essensys-hub/essensys-test-banc-SC944D/etude/cables-v1.docx

Câbles tout fait :

Videk 1530 Farnell 1525883 (Sub-D HP (helf pitch) 50 vers Sub-D HP 50)

Videk 1557 Farnell 1525919 (idem 1530 mais en 68 pts)

MEILHAUS (http://fr.farnell.com/meilhaus) AK-D78/1 Farnell 9568352 (SUB-D normal 78 pts mâle/femelle).

Trouver de la chaussette à toron.
