essensys-hub/essensys-test-banc-SC944D/etude/mesures-analogiques-annexe-spec-v4.pdf

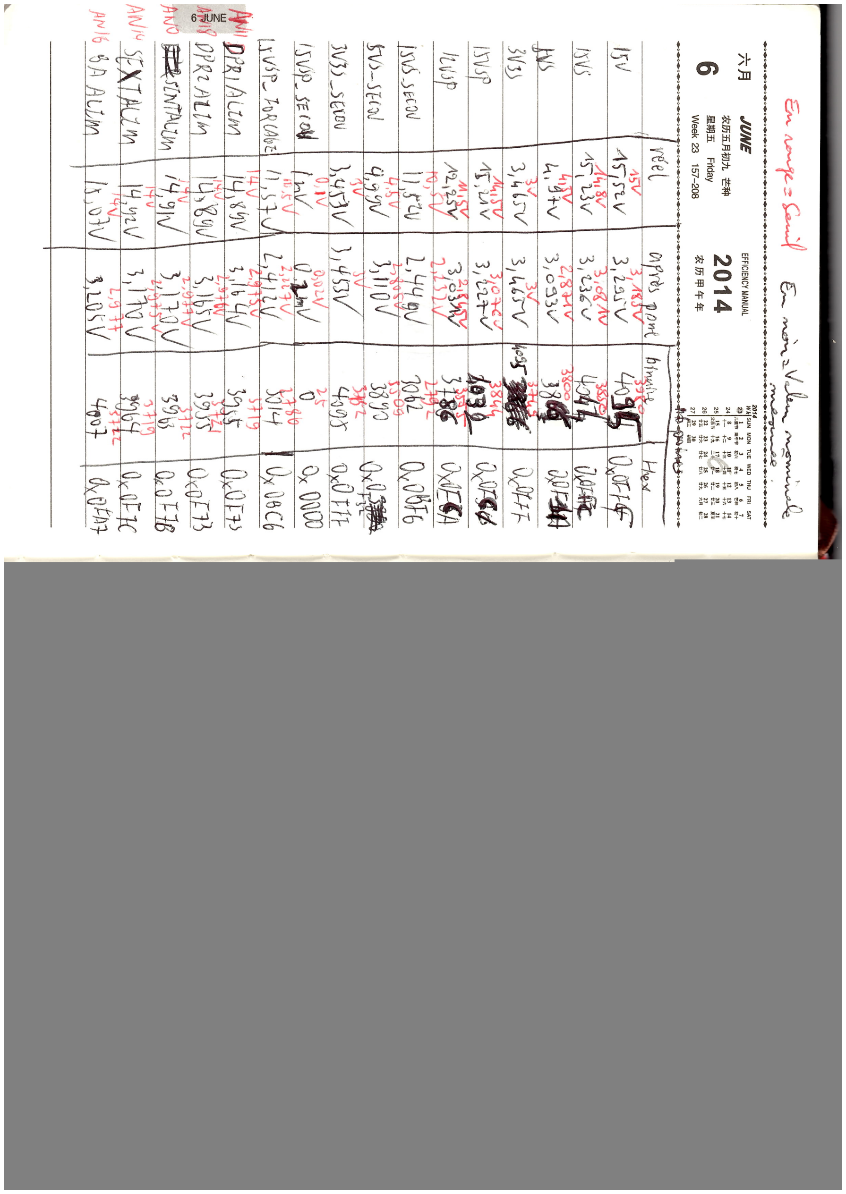
[picture p5: page 1]
