essensys-hub/essensys-test-banc-SC944D/etude/croquis-alimentations-banc.pdf

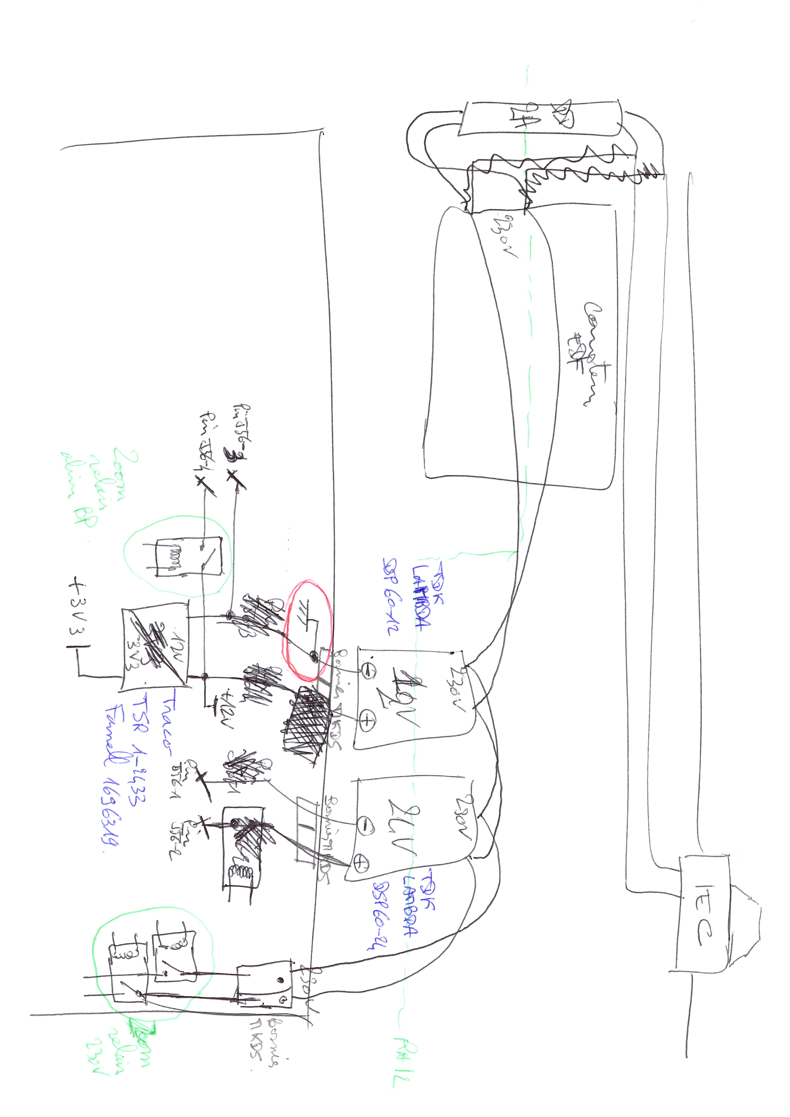
[picture p6: page 1]
