essensys-hub/essensys-test-banc-SC944D/etude/croquis-implantation-mecanique.pdf

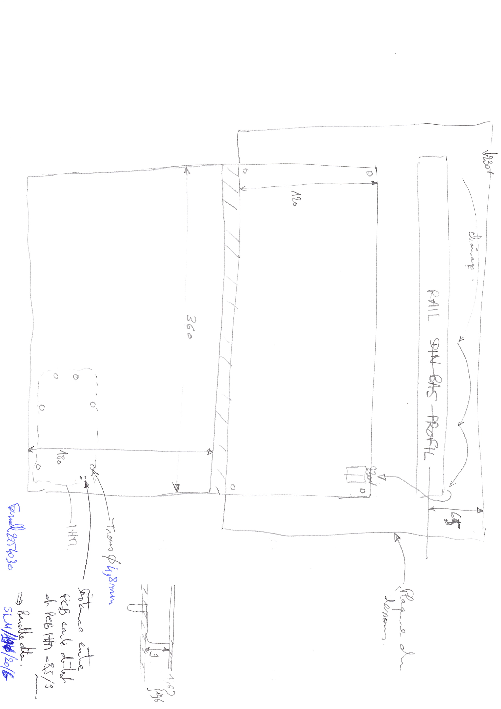
[picture p7: page 1]
