essensys-hub/essensys-test-banc-SC944D/etude/croquis-relais-230v.pdf

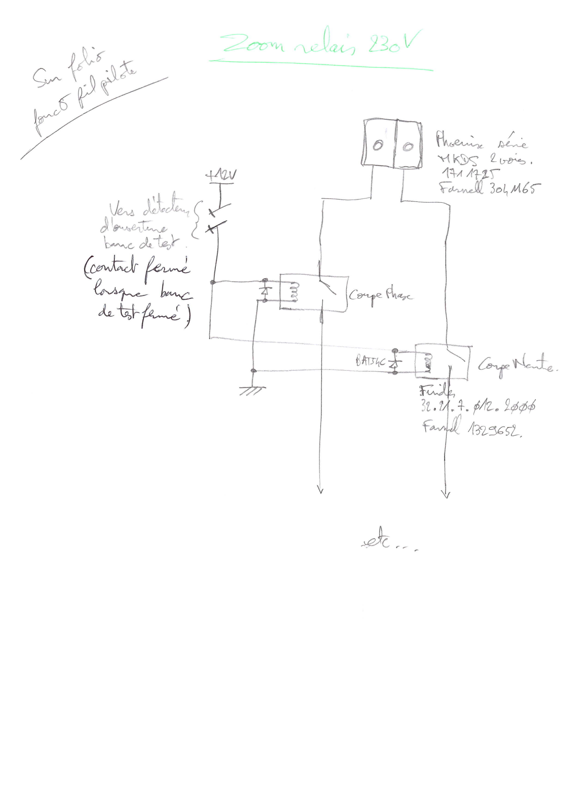
[picture p8: page 1]
