essensys-hub/essensys-test-banc-SC944D/etude/croquis-relais-alim-bp.pdf

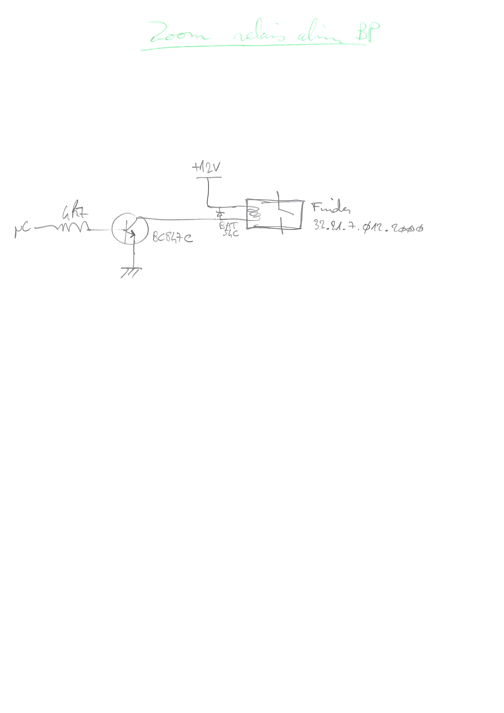
[picture p9: page 1]
