essensys-hub/essensys-test-banc-SC944D/etude/scan-ajout-masses.pdf

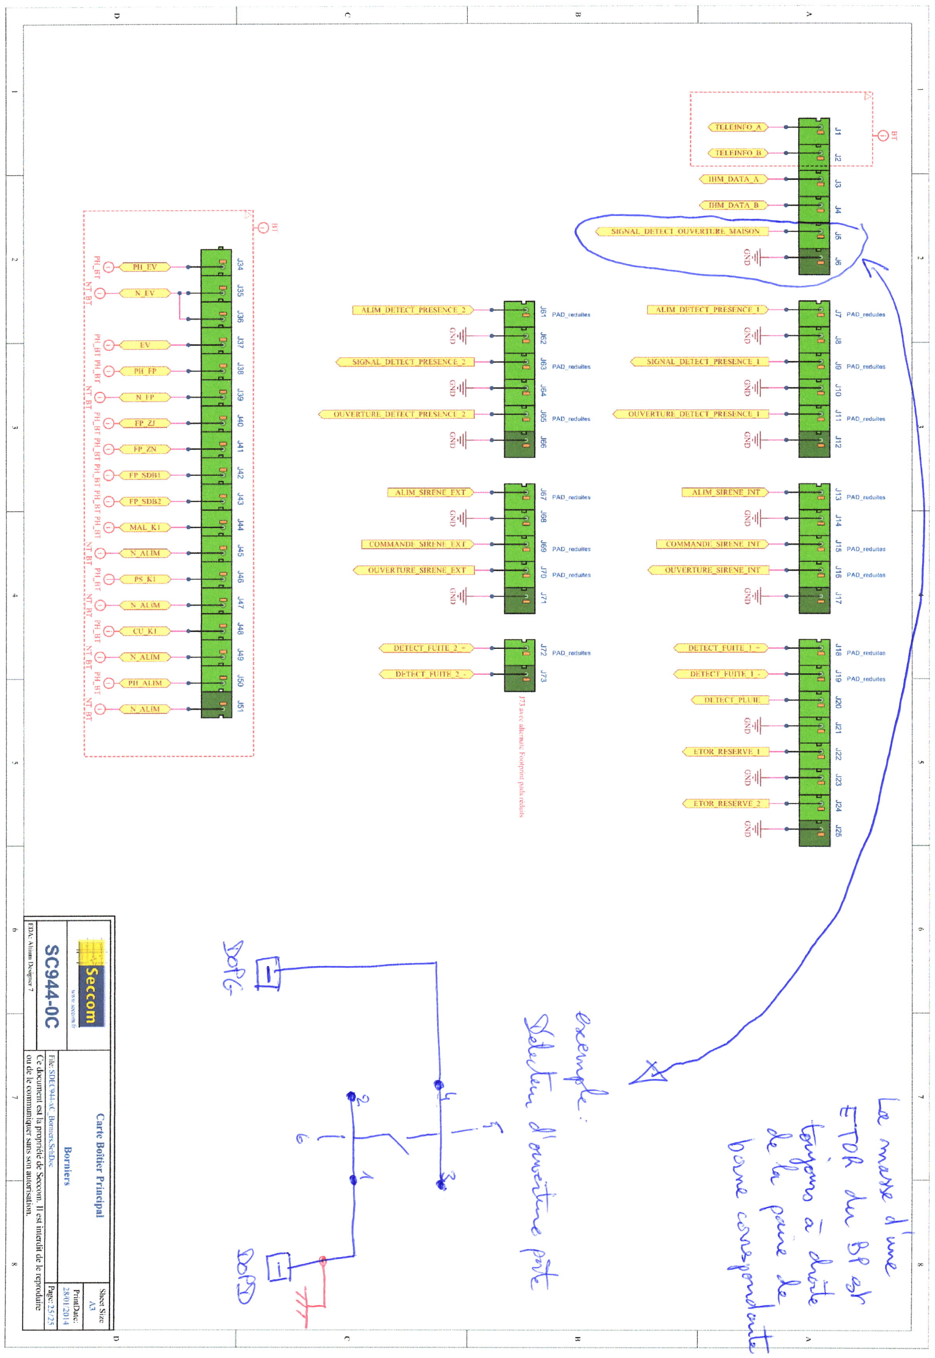
[picture p10: page 1]
