essensys-hub/essensys-test-banc-SC944D/etude/scan-connecteur-prog-dsp.pdf

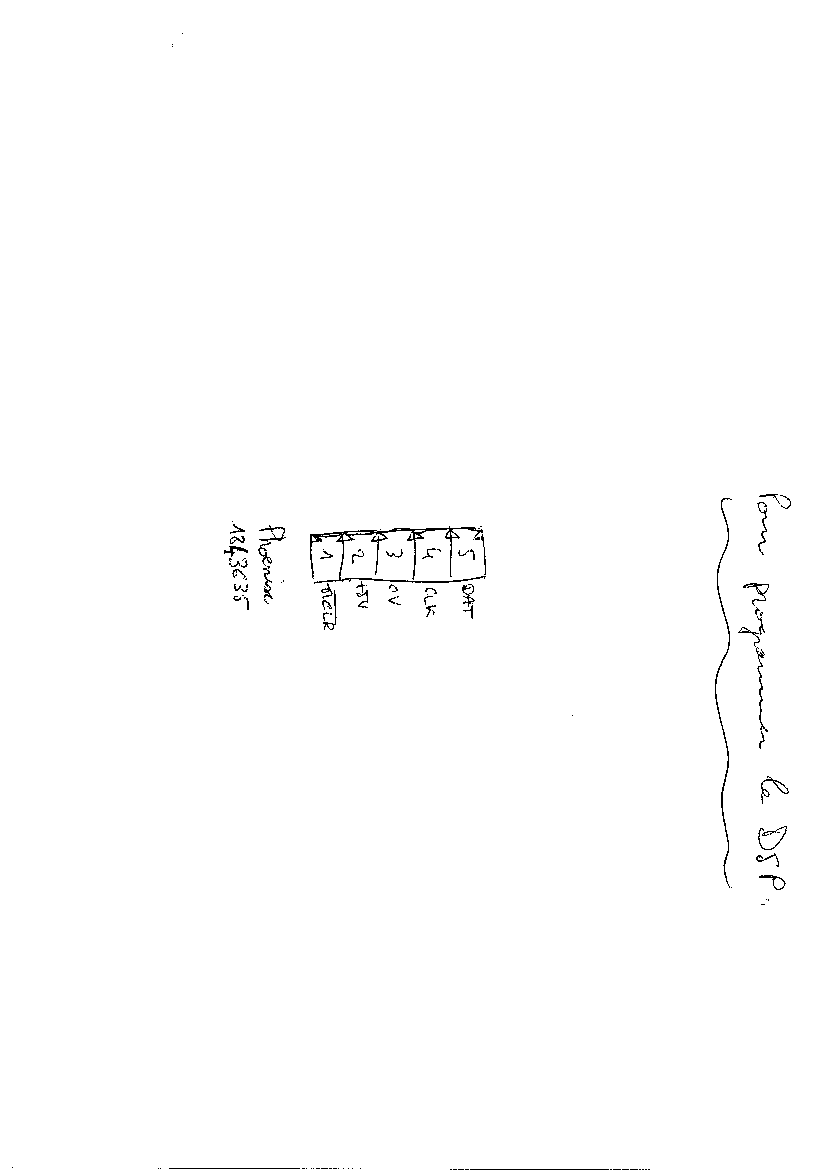
[picture p11: page 1]
