essensys-hub/essensys-test-banc-SC944D/docs/images/lit-de-clous.jpg

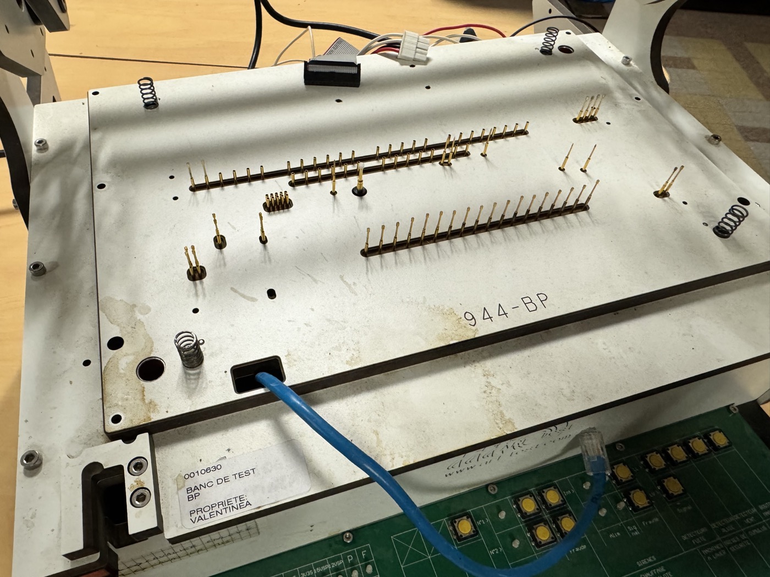
docs/images/lit-de-clous.jpg
