essensys-hub/essensys-test-banc-SC944D/photos/2016-10-08/20161008_151500.jpg

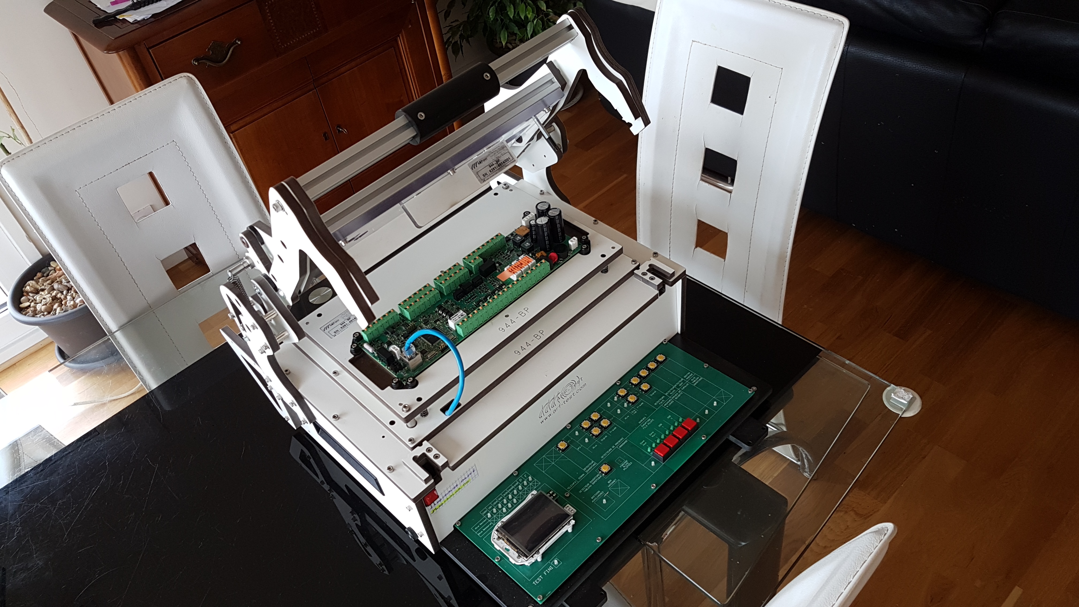
photos/2016-10-08/20161008_151500.jpg
