essensys-hub/essensys-test-banc-SC944D/photos/2026-11-09/IMG_5847.jpg

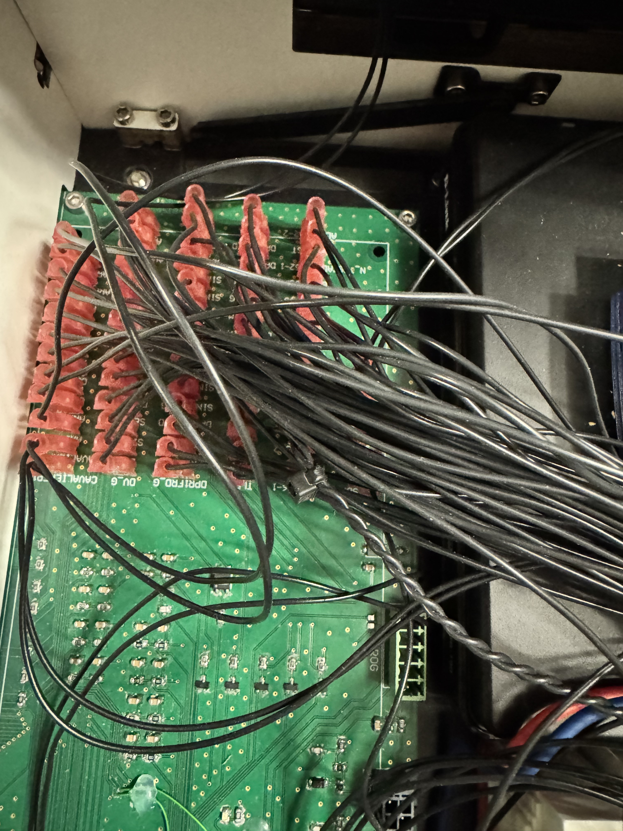
photos/2026-11-09/IMG_5847.jpg
