essensys-hub/essensys-test-banc-SC944D/photos/2026-11-09/IMG_5849.jpg

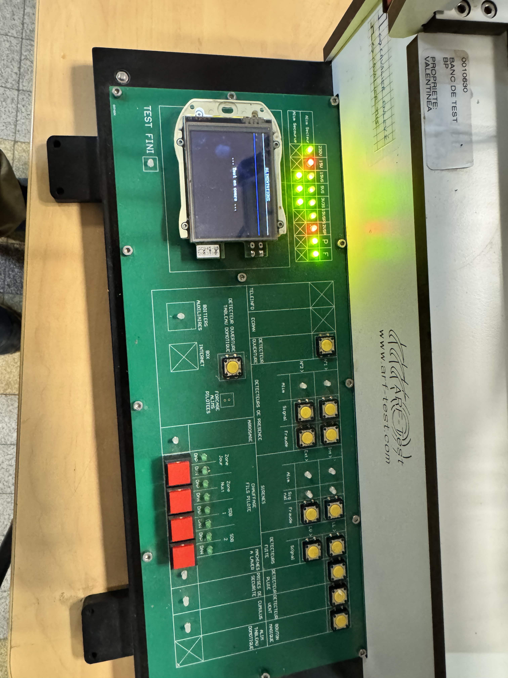
photos/2026-11-09/IMG_5849.jpg
