essensys-hub/essensys-test-banc-SC944D/carte-interface-SI841A/face-avant/archives/ci-v1_2000-Preserve-Appearance.dxf

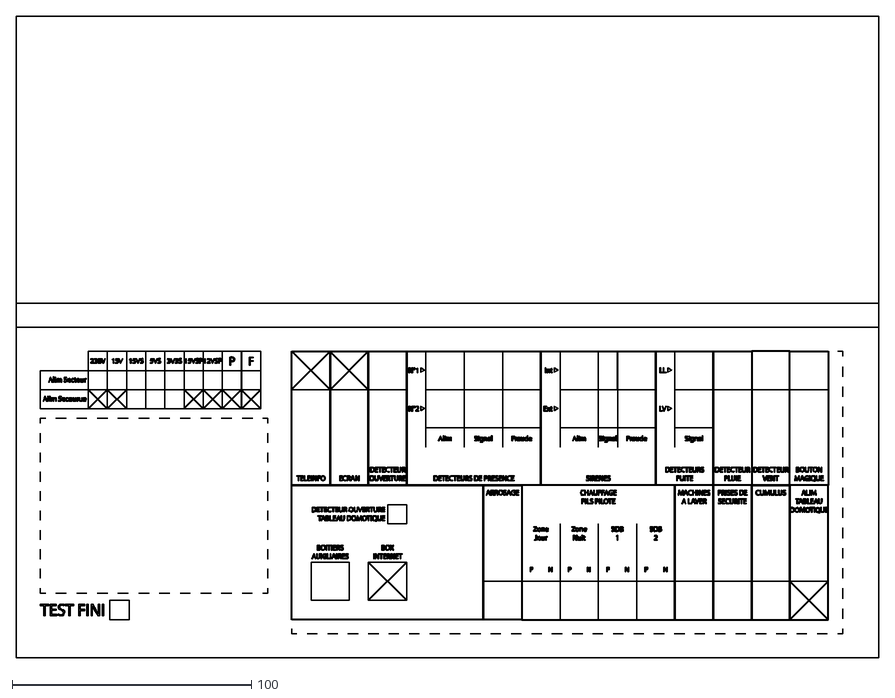
[picture p24: CAD file, 2026-11-11, an earlier design]
carte-interface-SI841A/face-avant/archives/ci-v1_2000-Preserve-Appearance.dxf
360.0 x 268.0
