essensys-hub/essensys-test-banc-SC944D/carte-interface-SI841A/face-avant/archives/ci-v4_2000-8-PNG-PA-APFA-OT.dxf

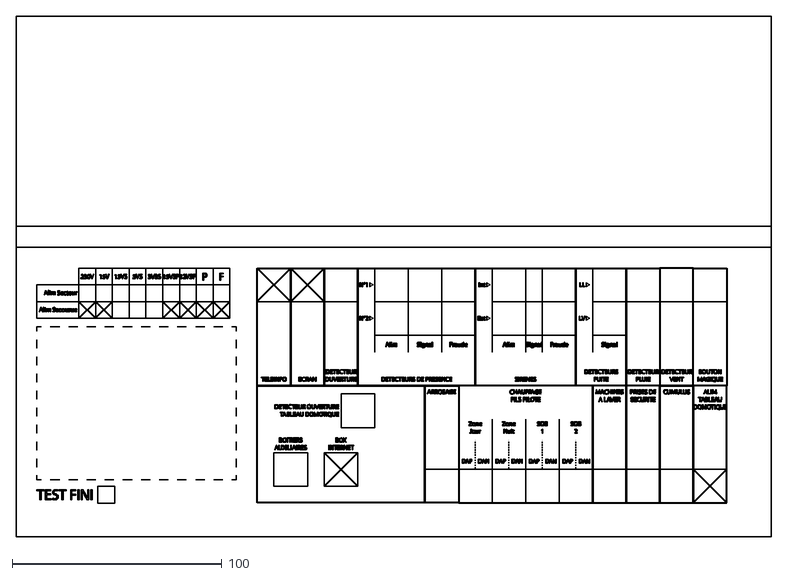
[picture p30: CAD file, 2026-11-11, an earlier design]
carte-interface-SI841A/face-avant/archives/ci-v4_2000-8-PNG-PA-APFA-OT.dxf
360.0 x 248.0
