essensys-hub/essensys-test-banc-SC944D/(list of files, cad)

Other CAD files:
carte-interface-SI841A/face-avant/archives/ci-v1_2000-Maximum-Editability.dwg
carte-interface-SI841A/face-avant/archives/ci-v1_R14-Preserve-Appearance.dwg
carte-interface-SI841A/face-avant/archives/ci-v1_R13-Preserve-Appearance.dwg
carte-interface-SI841A/face-avant/archives/ci-v1_2000-Preserve-Appearance.dwg
carte-interface-SI841A/face-avant/archives/ci-v2_2000-Preserve-Appearance.dwg
