essensys-hub/essensys-test-banc-SC944D/mecanique-arf-test-6281/_Index.html

Logo ARF-Test

Folders
ASM's Affaire | ASM's Commun | BOM | Include

Anchor

<Root>

ASM's Affaire

ASM's Commun

BOM

Include

File Listing
Folder listing : <Root>
File | Size | File | Size | File | Size | File | Size
Listing des Dossiers: H:\0 - Projets\En cours\Valentinea\Dossiers Client\6281 - ARF-PLCe 320 - SC944 | 9 Ko | Image Interface.jpg | 78 Ko | Photo interface.jpg | 205 Ko
Folder listing : ASM's Affaire
File | Size | File | Size | File | Size | File | Size
6281_005 (ARF-PLC 320 - SC944).pdf | 643 Ko | 6281_068 (Base Plate SC944).pdf | 236 Ko | 6281_092 (Top SC944).pdf | 99 Ko | 6281_111 (Right Panel - V2).pdf | 115 Ko
6281_035 (Rear Panel SC94x).pdf | 38 Ko | 6281_084 (Pusher plate SC944).pdf | 119 Ko | 6281_102 (Presse PCB).pdf | 51 Ko | 6281_117 (Left Panel - V2).pdf | 113 Ko
6281_052 (Std Presser - 320 - V2).pdf | 280 Ko | 6281_090 (Appli SC944).pdf | 104 Ko | 6281_104 (Presse Basse PCB).pdf | 47 Ko | 6281_158 (Bottom Plate (320) SC944).pdf | 90 Ko
6281_062 (Box ARF-PLC-03-V2).pdf | 491 Ko | 6281_091 (Bottom SC944).pdf | 187 Ko
Folder listing : ASM's Commun
File | Size | File | Size | File | Size | File | Size
6278_058 (Std Presser - 320 V2).pdf | 461 Ko | 6278_125 (Locating).pdf | 47 Ko | 8005_016 (Switch PLC_V2).pdf | 74 Ko | 8005_083 (Vis moletee).pdf | 83 Ko
Folder listing : BOM
File | Size | File | Size | File | Size | File | Size
6281_005 (Full).txt | 49 Ko | 6281_005 (Recap).txt | 12 Ko
Folder listing : Include
File | Size | File | Size | File | Size | File | Size
LOGO-ARF-Test.jpg | 18 Ko
