essensys-hub/essensys-test-banc-SC944D/points-de-test-SC944/si944c-pt-noms-v1.pdf

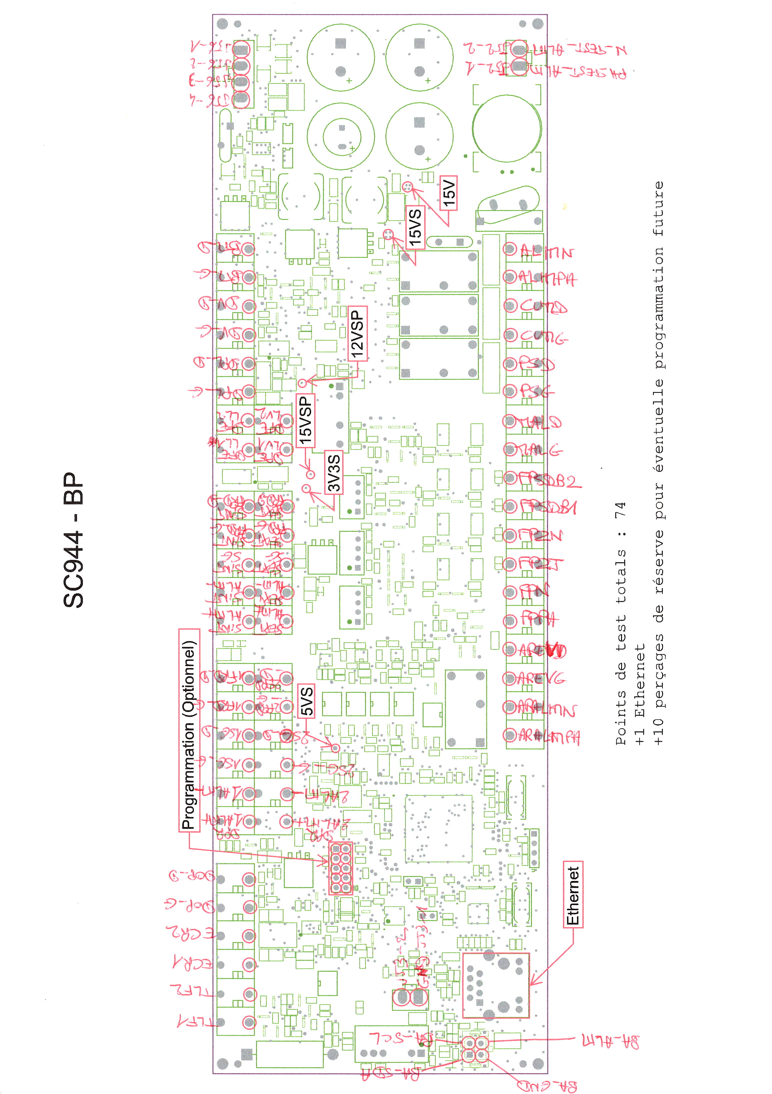
[picture p33: page 1]
