essensys-hub/essensys-test-banc-SC944D/etude/calculs-test-signal-sirenes-v1.xlsx

 | Rs | R (Ohm) | U (V) | I (mA)
SINT | 4700 | 4700 | 7.5 | 1.595744681
SEXT | 10000 |  | 4.795918367 | 1.020408163
