essensys-hub/essensys-test-banc-SC944D/etude/scan-tableau-test-alims.jpeg

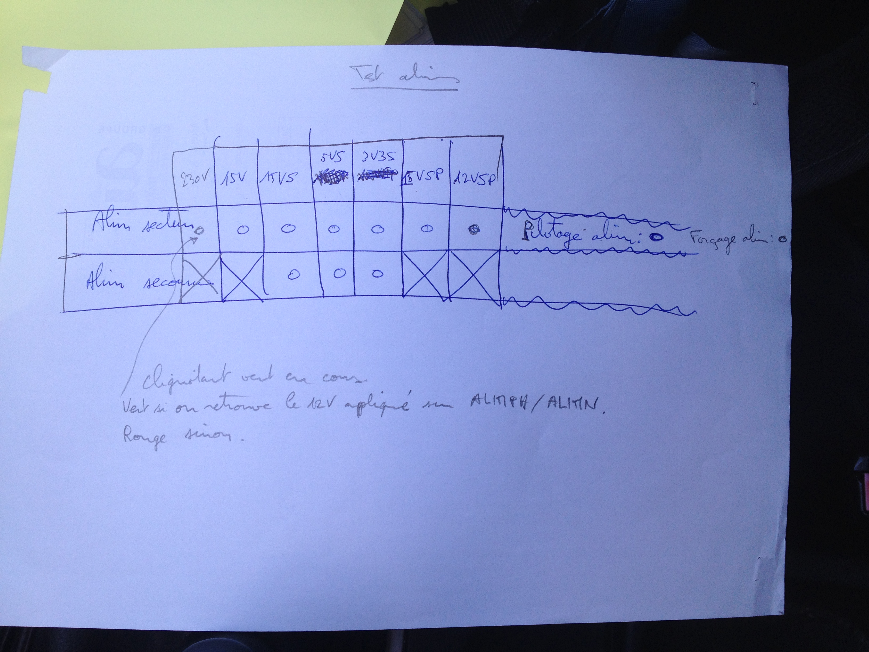
etude/scan-tableau-test-alims.jpeg
