essensys-hub/essensys-test-banc-SC944D/mecanique-arf-test-6281/Image Interface.jpg

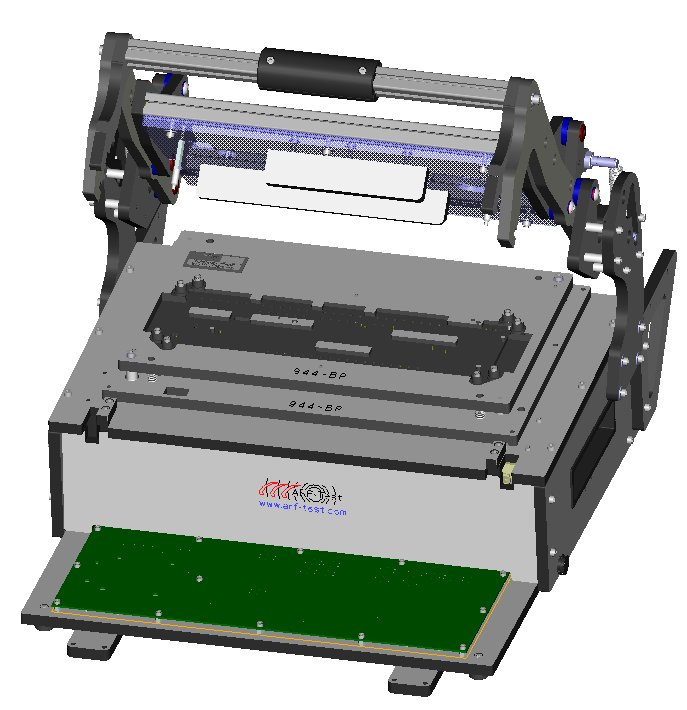
mecanique-arf-test-6281/Image Interface.jpg
