essensys-hub/essensys-test-banc-SC944D/mecanique-arf-test-6281/Photo interface.jpg

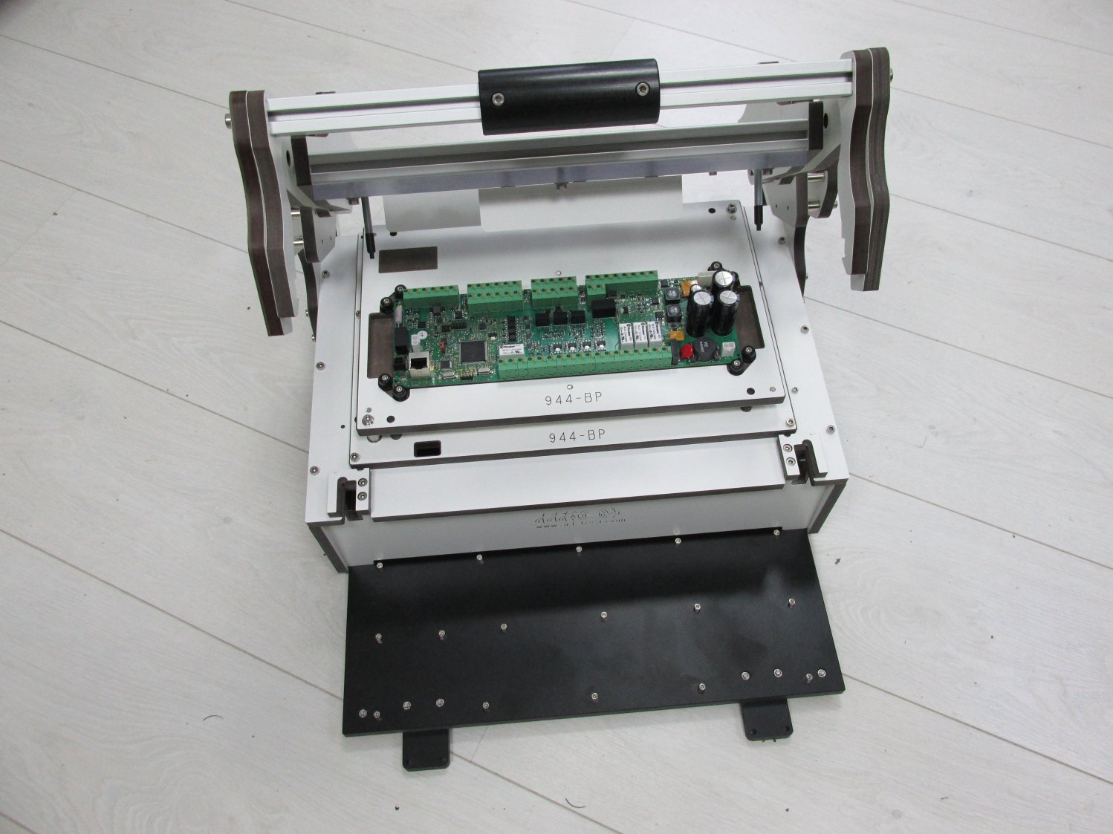
mecanique-arf-test-6281/Photo interface.jpg
