essensys-hub/essensys-test-banc-SC944D/carte-interface-SI841A/schema/schema-banc-bp-v4.pdf

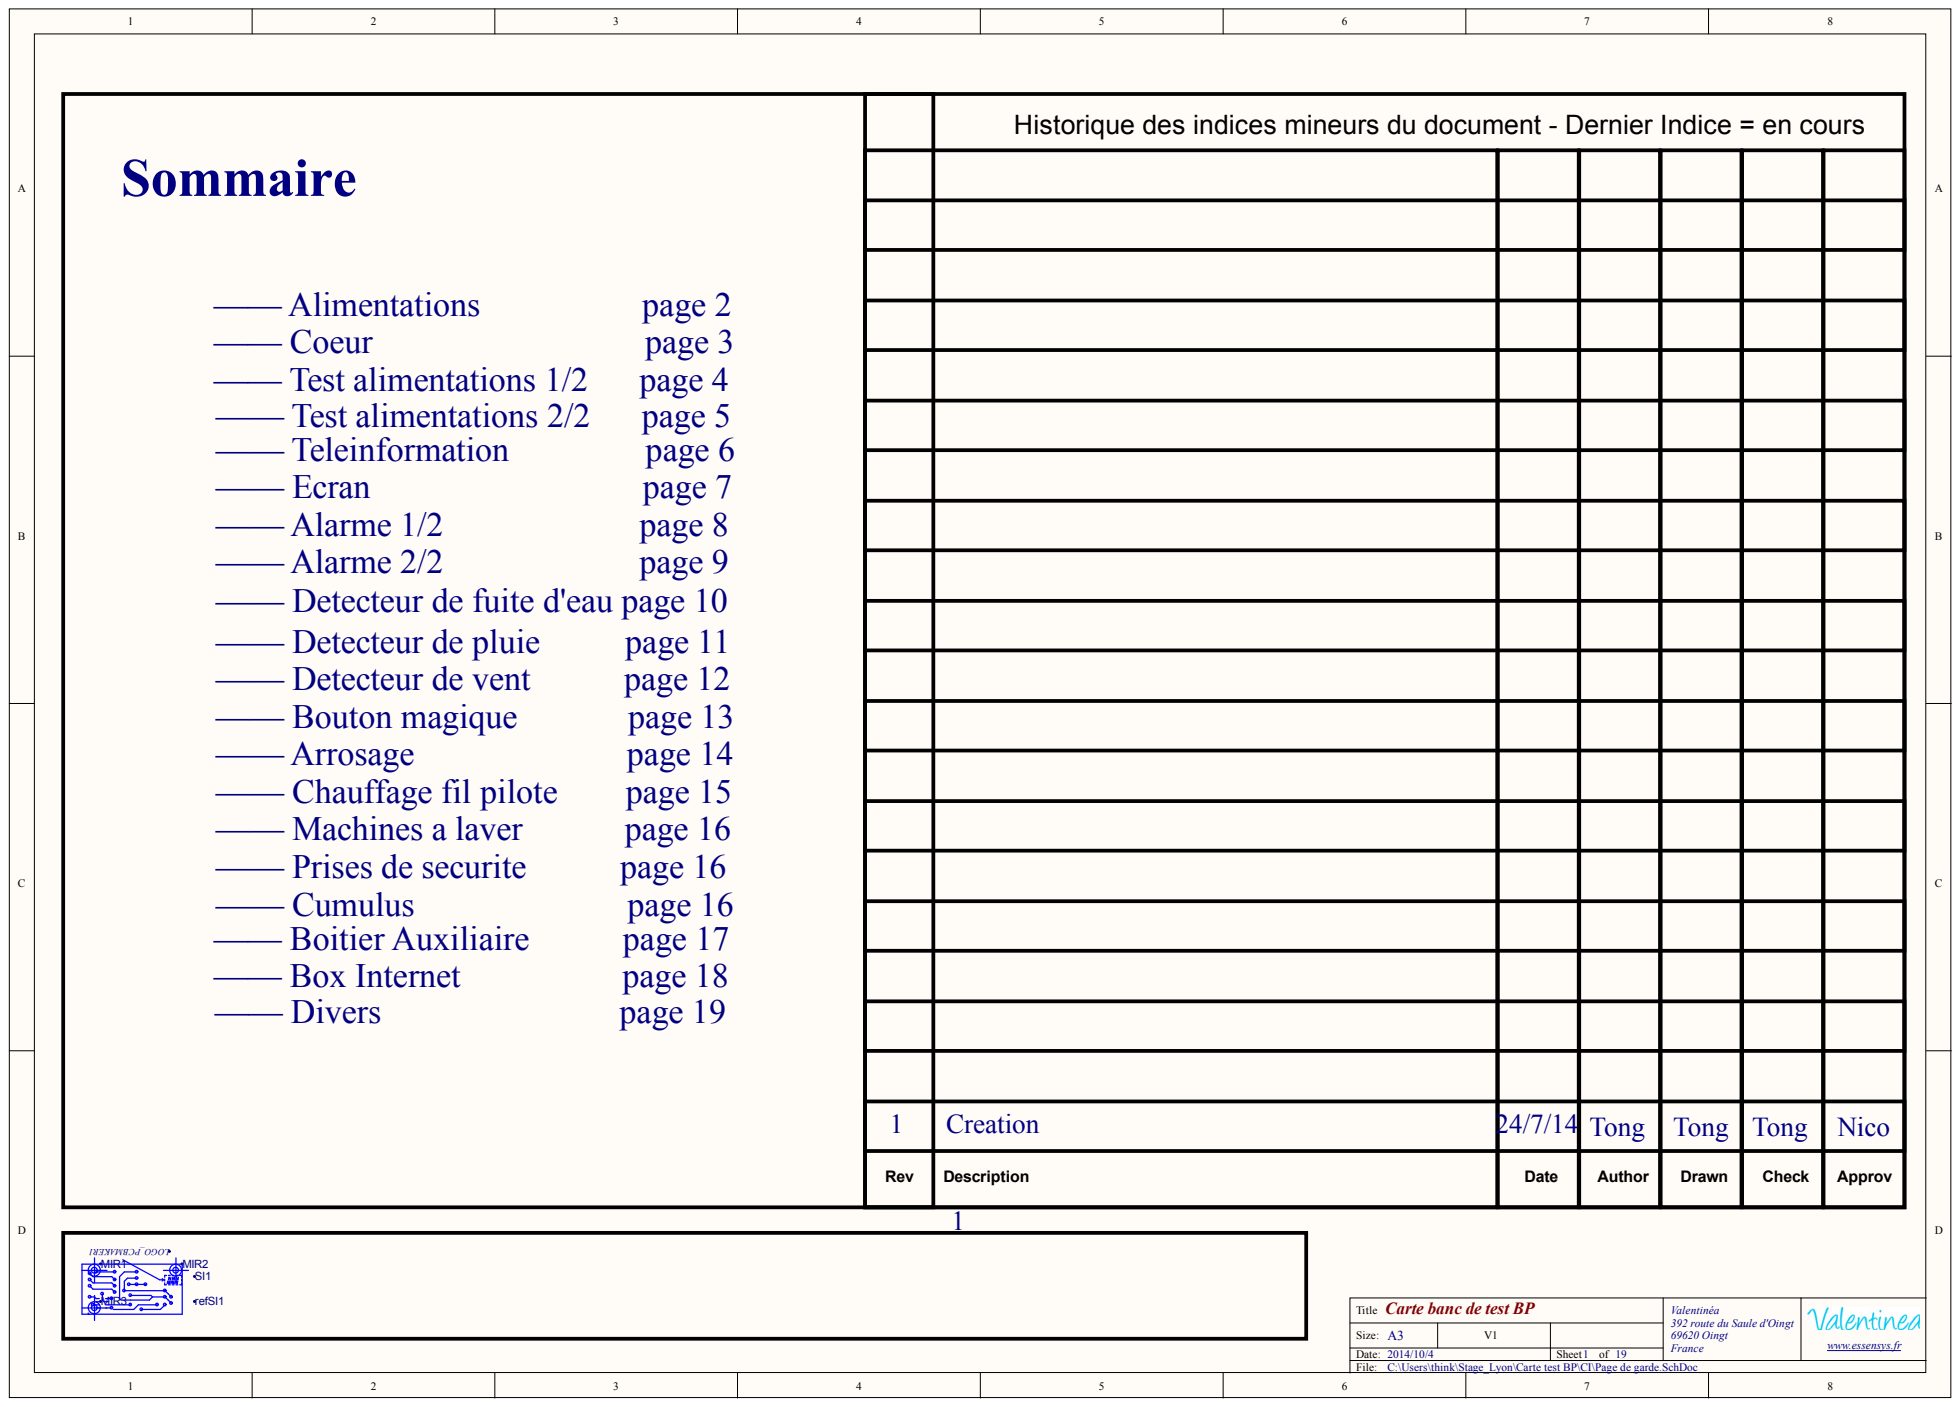
[picture p37: page 1]

Historique des indices mineurs du document - Dernier Indice = en cours

—— Detecteur de fuite d'eau page 10

1 | Creation | 24/7/14 | Tong | Tong | Tong | Nico

Rev | Description | Date | Author | Drawn | Check | Approv

Carte banc de test BP Title | Valentinéa 392 route du Saule d'Oingt 69620 Oingt France | www.essensys.fr 19

Size: A3 | V1
Date: | | Sheet of

C:\Users\think\Stage_Lyon\Carte test BP\CI\Page de garde.SchDoc

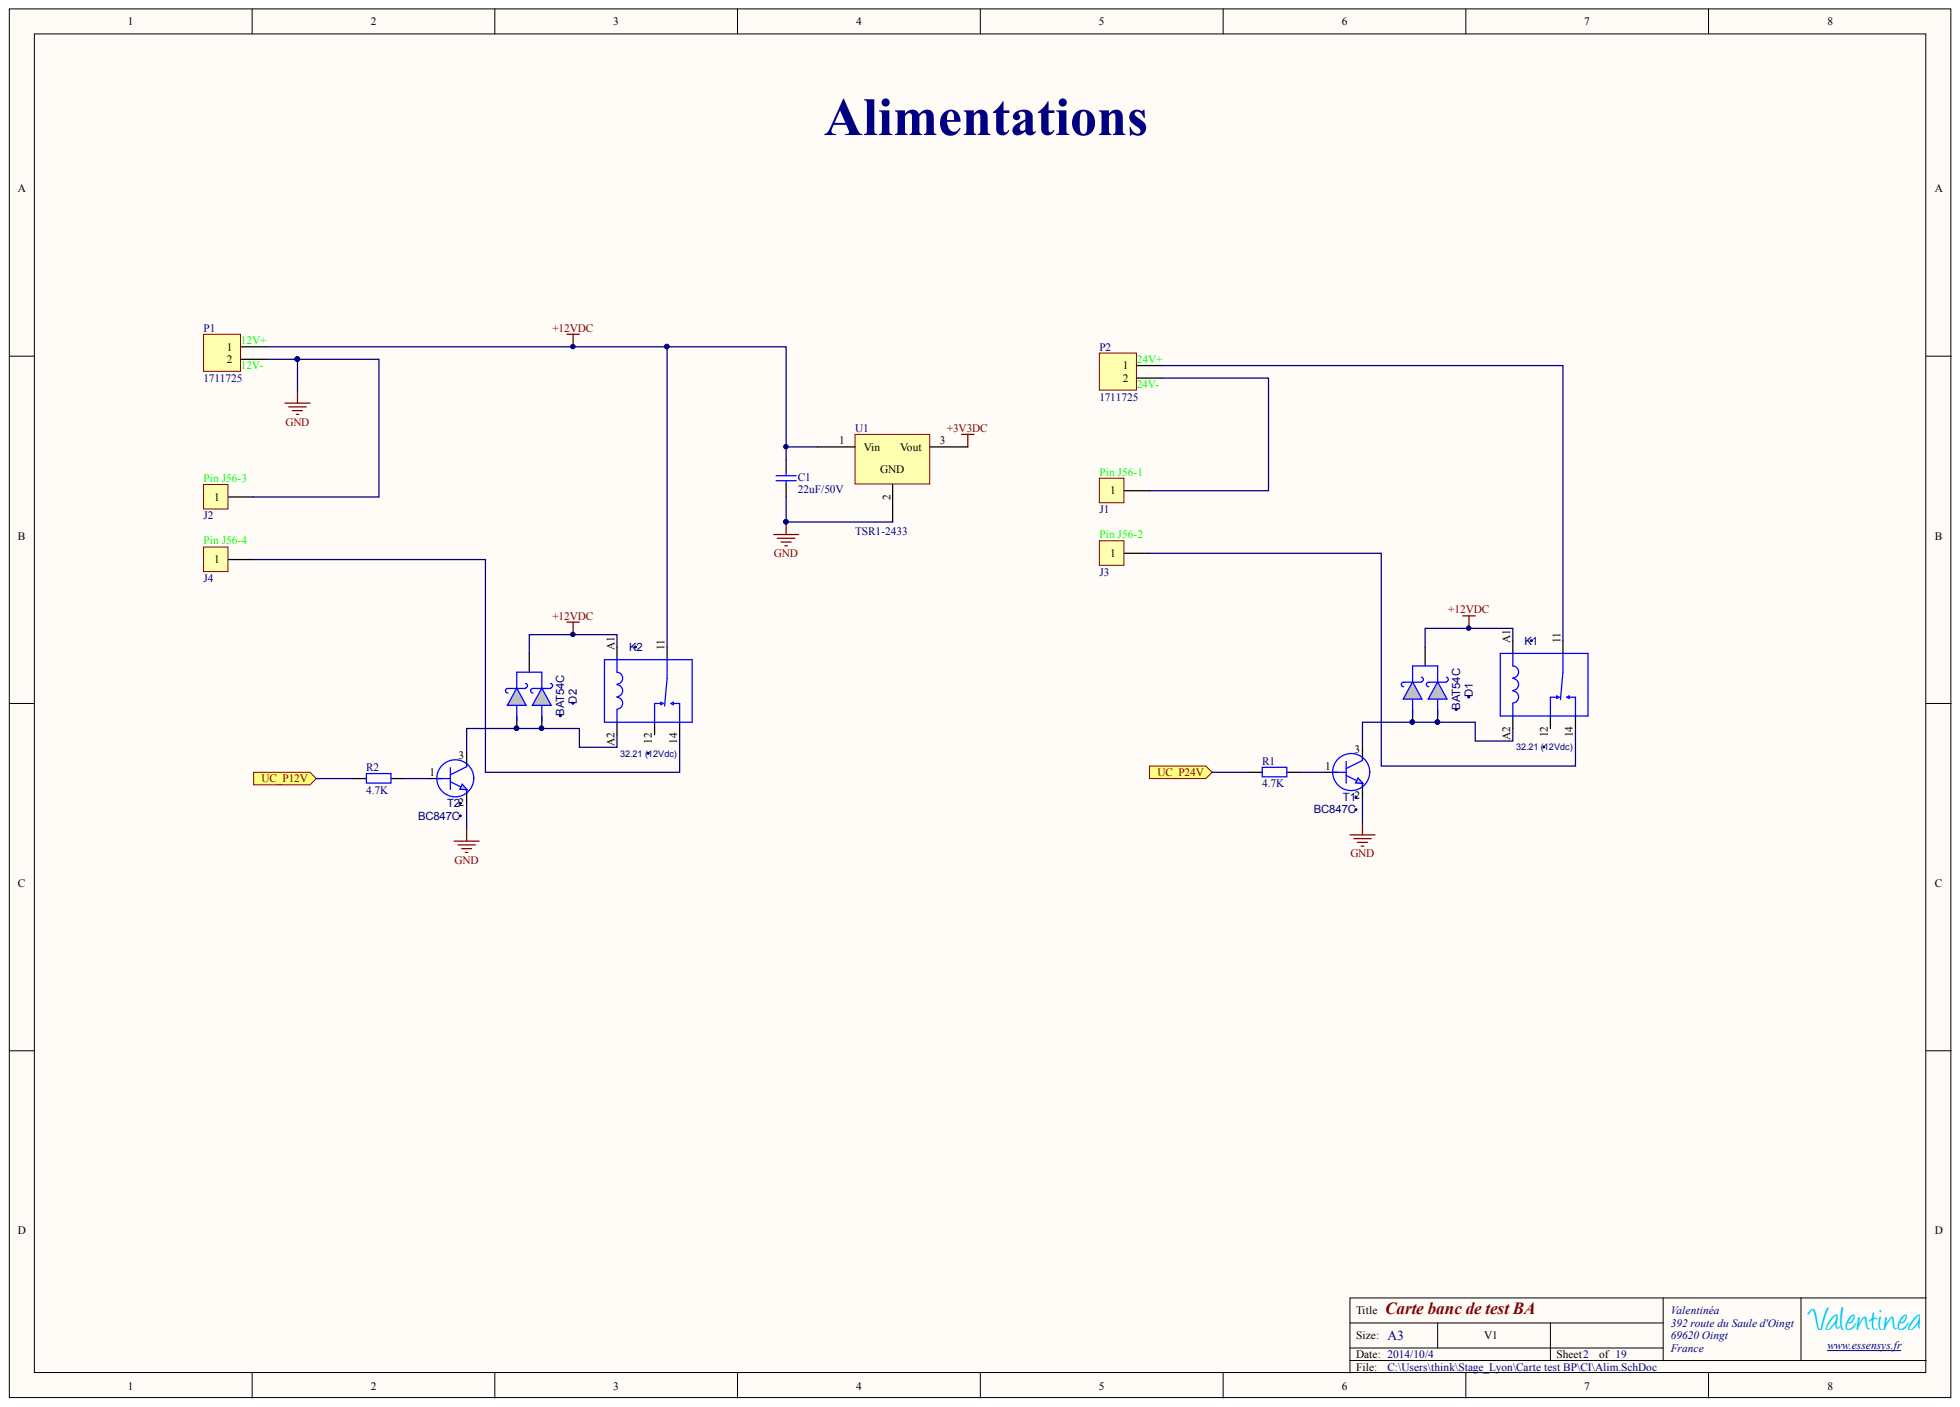
[picture p38: page 2]

Car te ban c de tes t BA Ti t l e | Valent i n é a 392 route du Saule d' O ingt 69620 O ingt France | w w w.es sensys.fr 19

Size: A | V
2014/10/

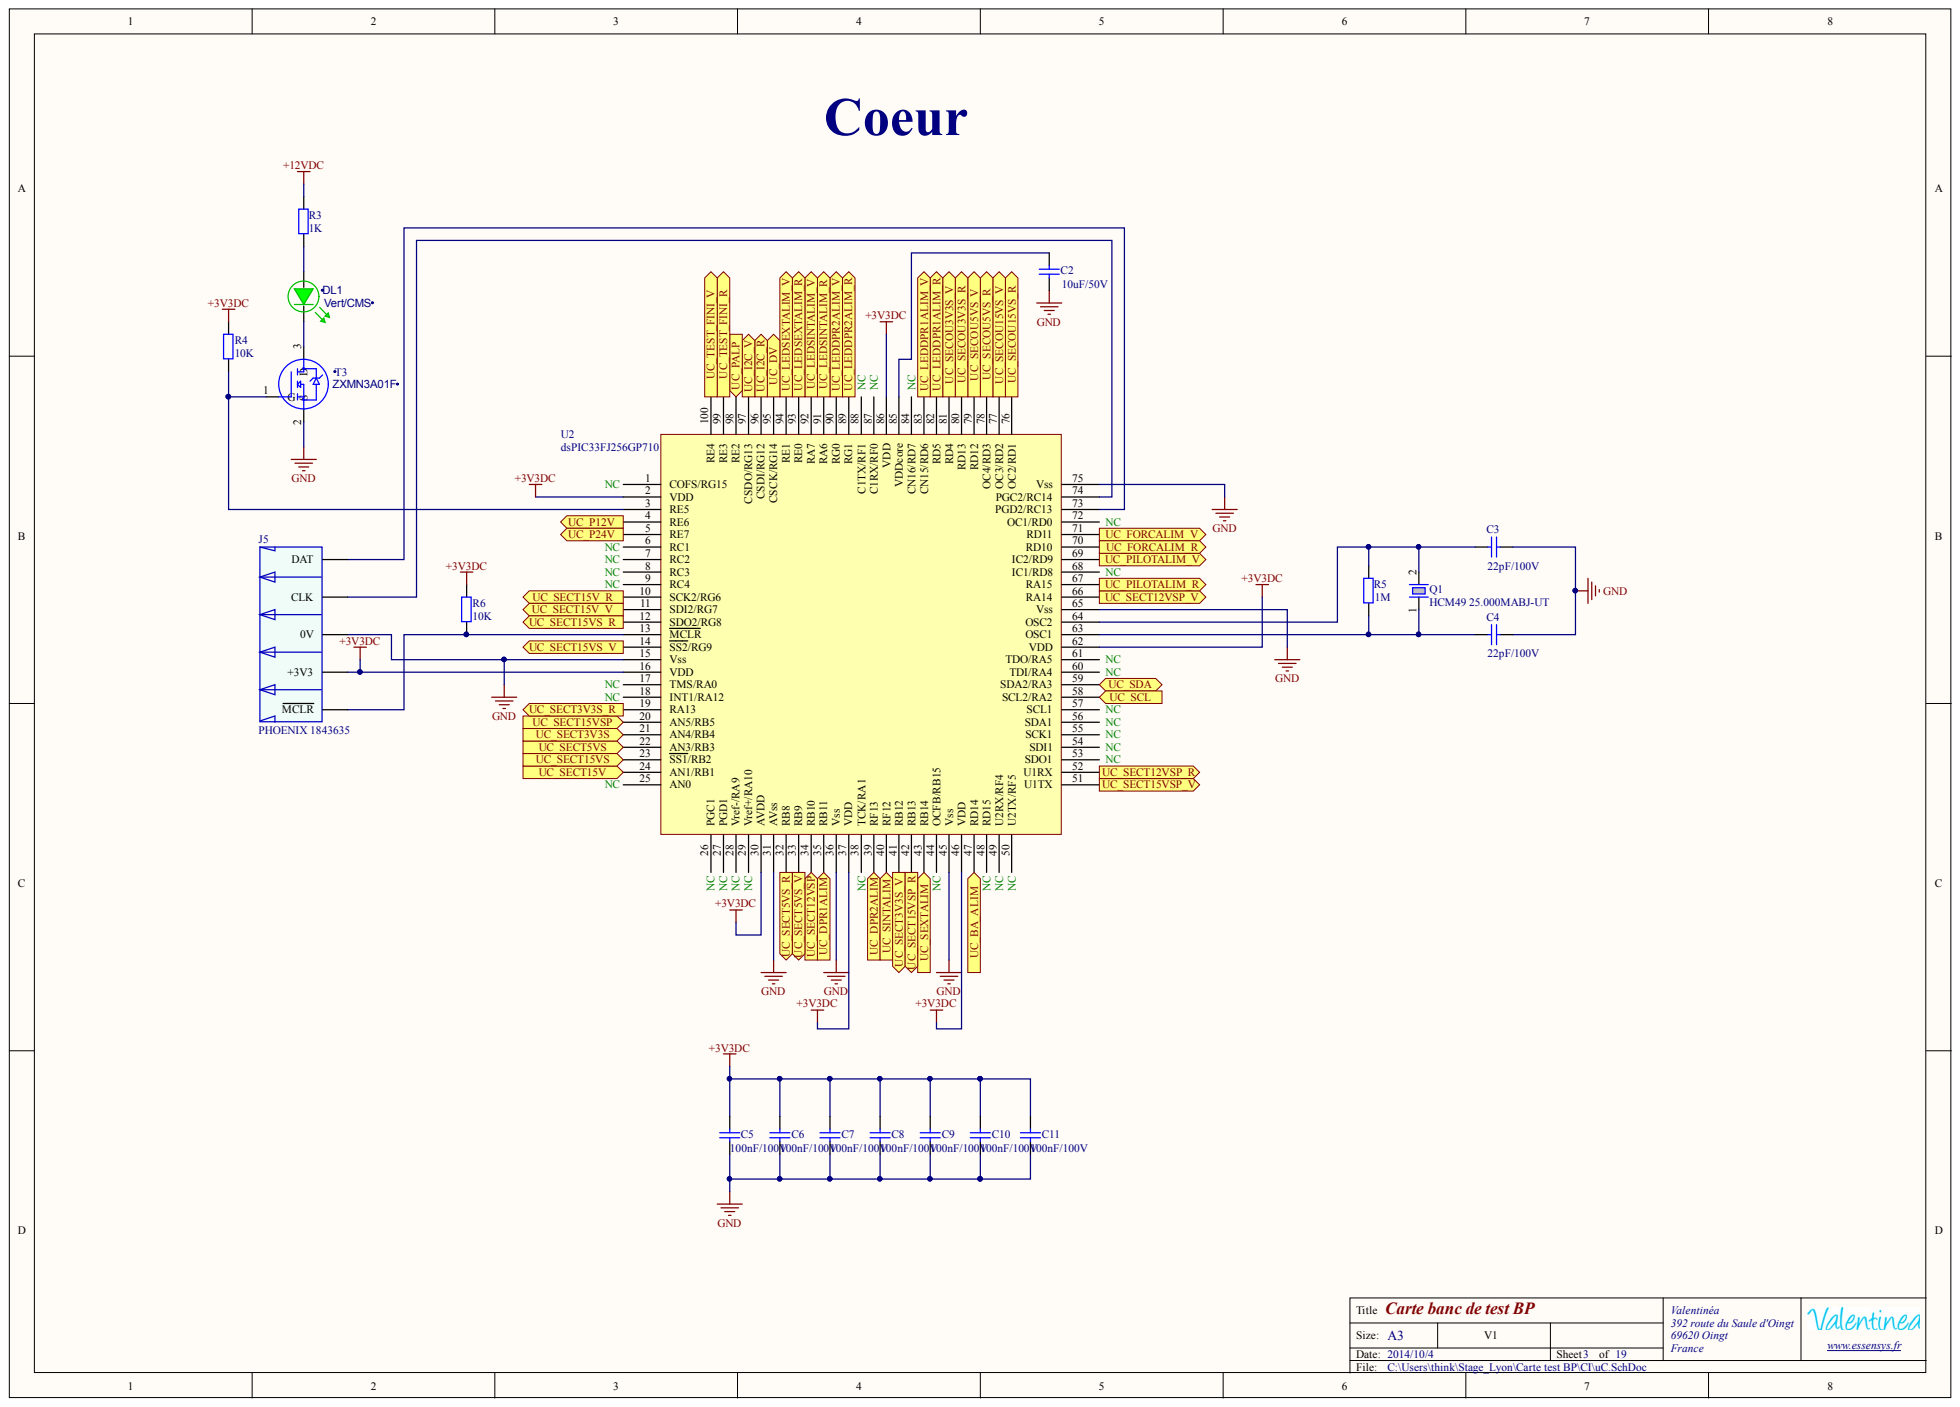
[picture p39: page 3]

VDD 16
TMS/RA0 17

MCLR | INT1/RA12 18

Carte banc de test BP

C:\Users\think\Stage_Lyon\Carte test BP\CI\uC.SchDoc

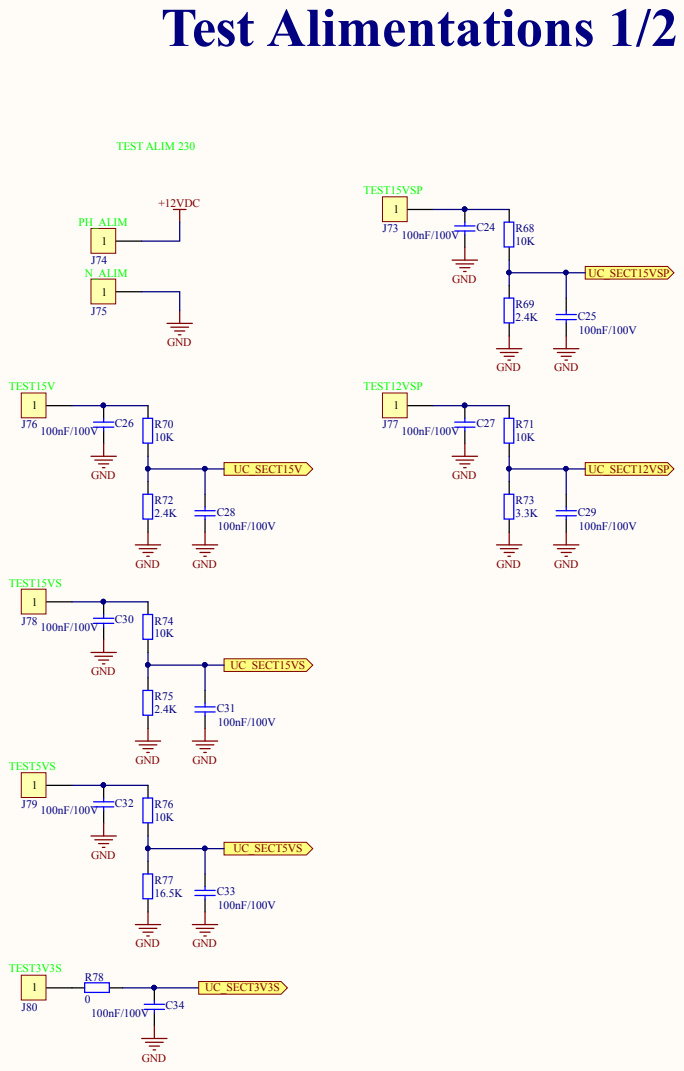
[picture p40: page 4]

Carte banc de test BA

C:\Users\think\Stage_Lyon\Carte test BP\CI\Test Alims1.SchDoc

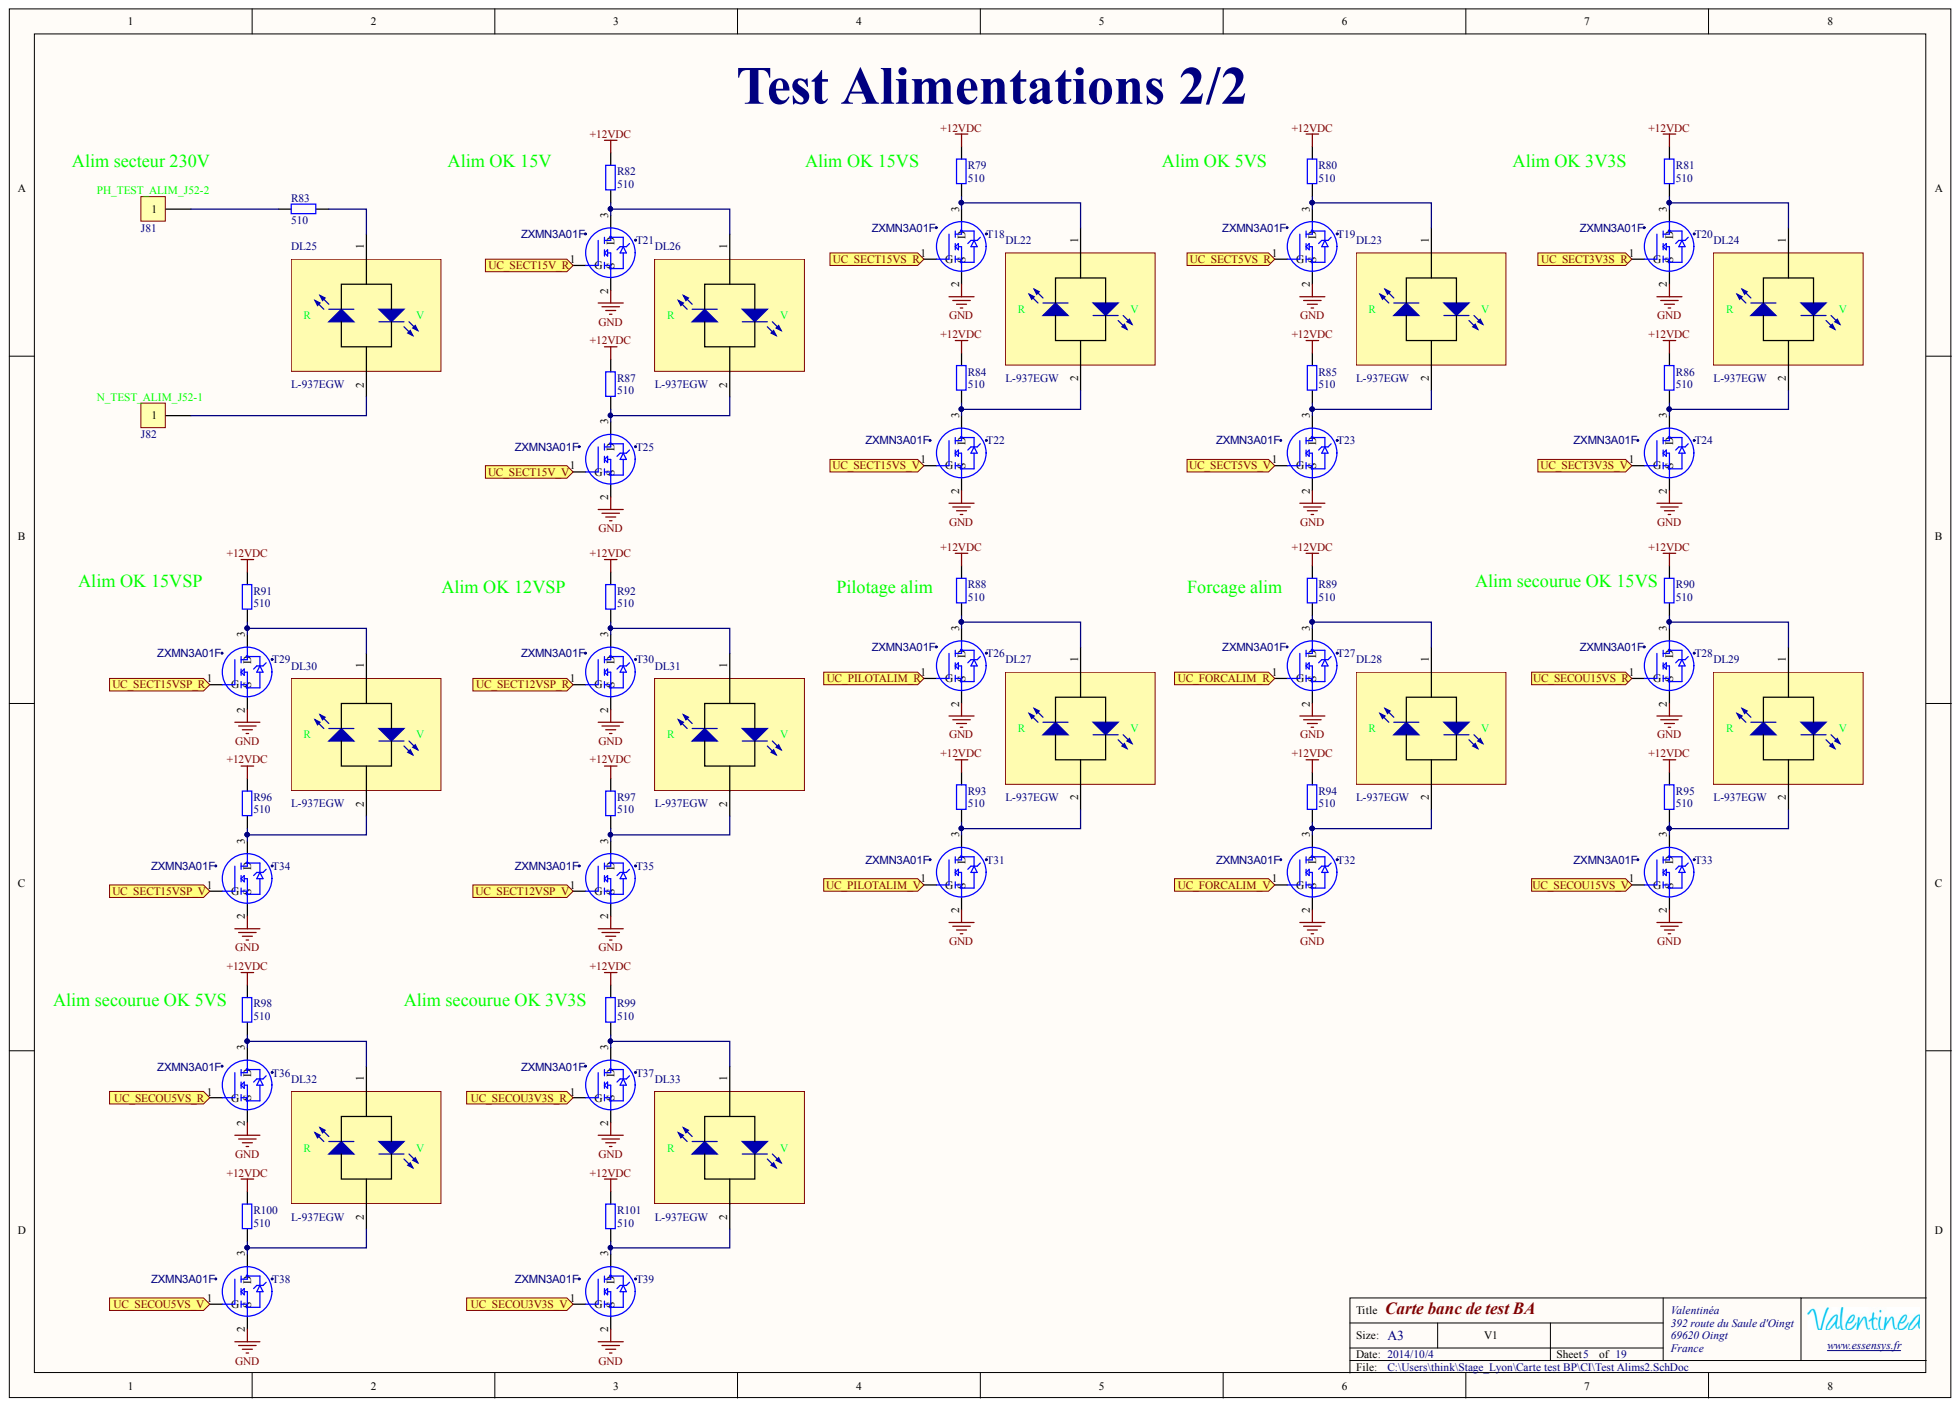
[picture p41: page 5]

C:\Users\think\Stage_Lyon\Carte test BP\CI\Test Alims2.SchDoc

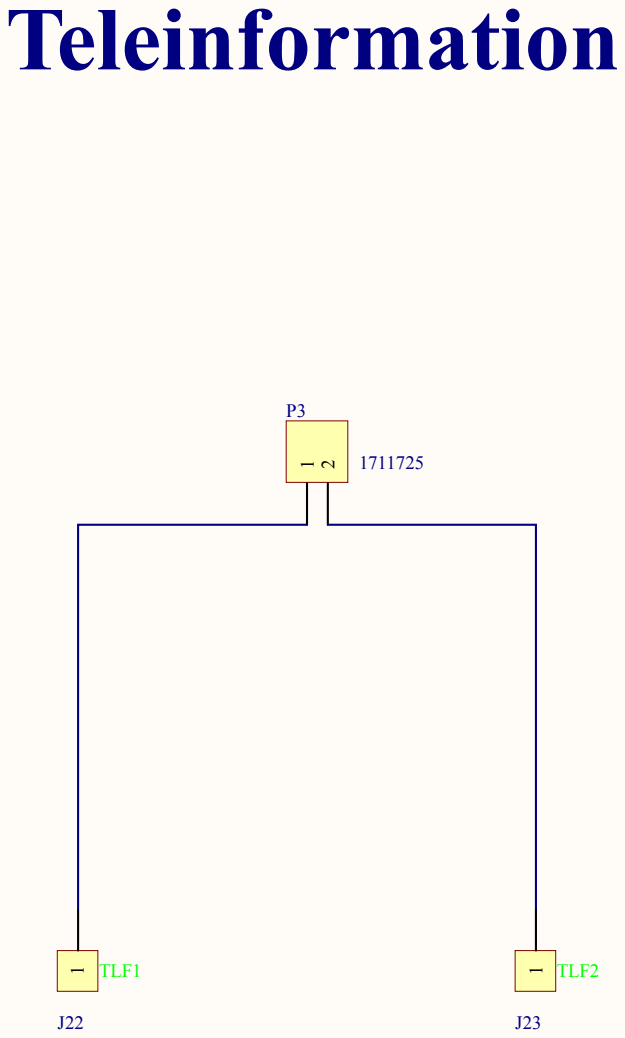
[picture p42: page 6]

C:\Users\think\Stage_Lyon\Carte test BP\CI\Teleinfo.SchDoc

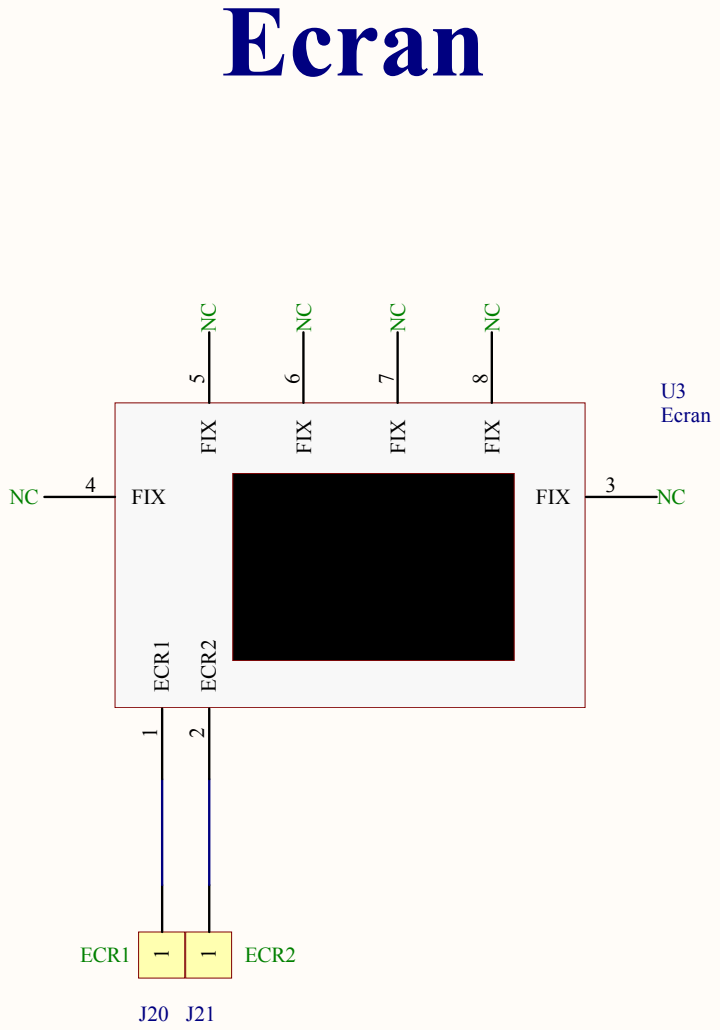
[picture p43: page 7]

C:\Users\think\Stage_Lyon\Carte test BP\CI\Ecran.SchDoc

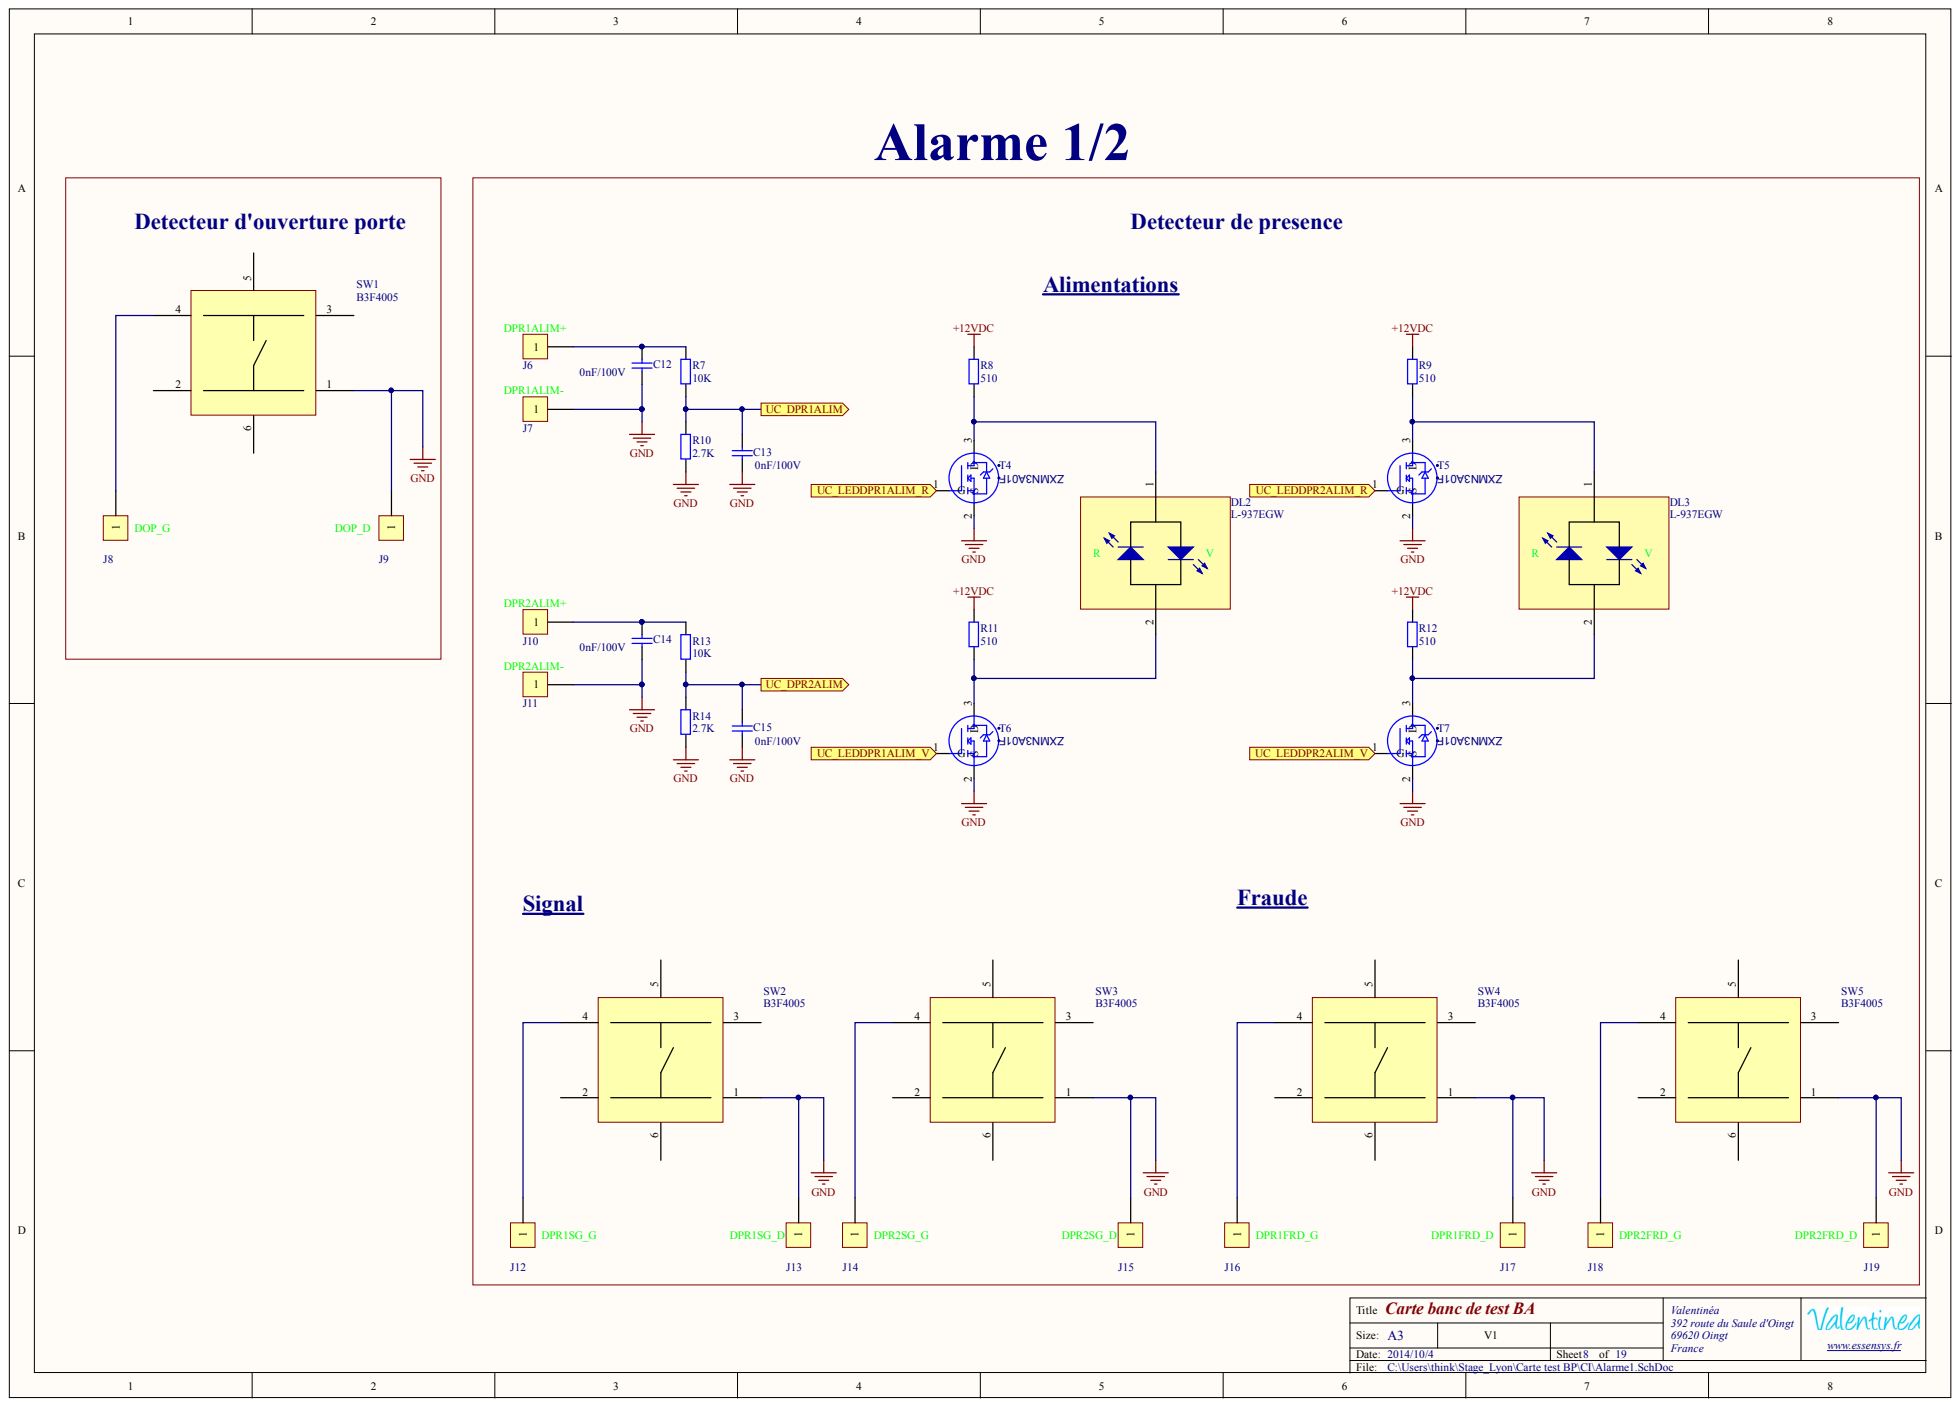
[picture p44: page 8]

C:\Users\think\Stage_Lyon\Carte test BP\CI\Alarme1.SchDoc

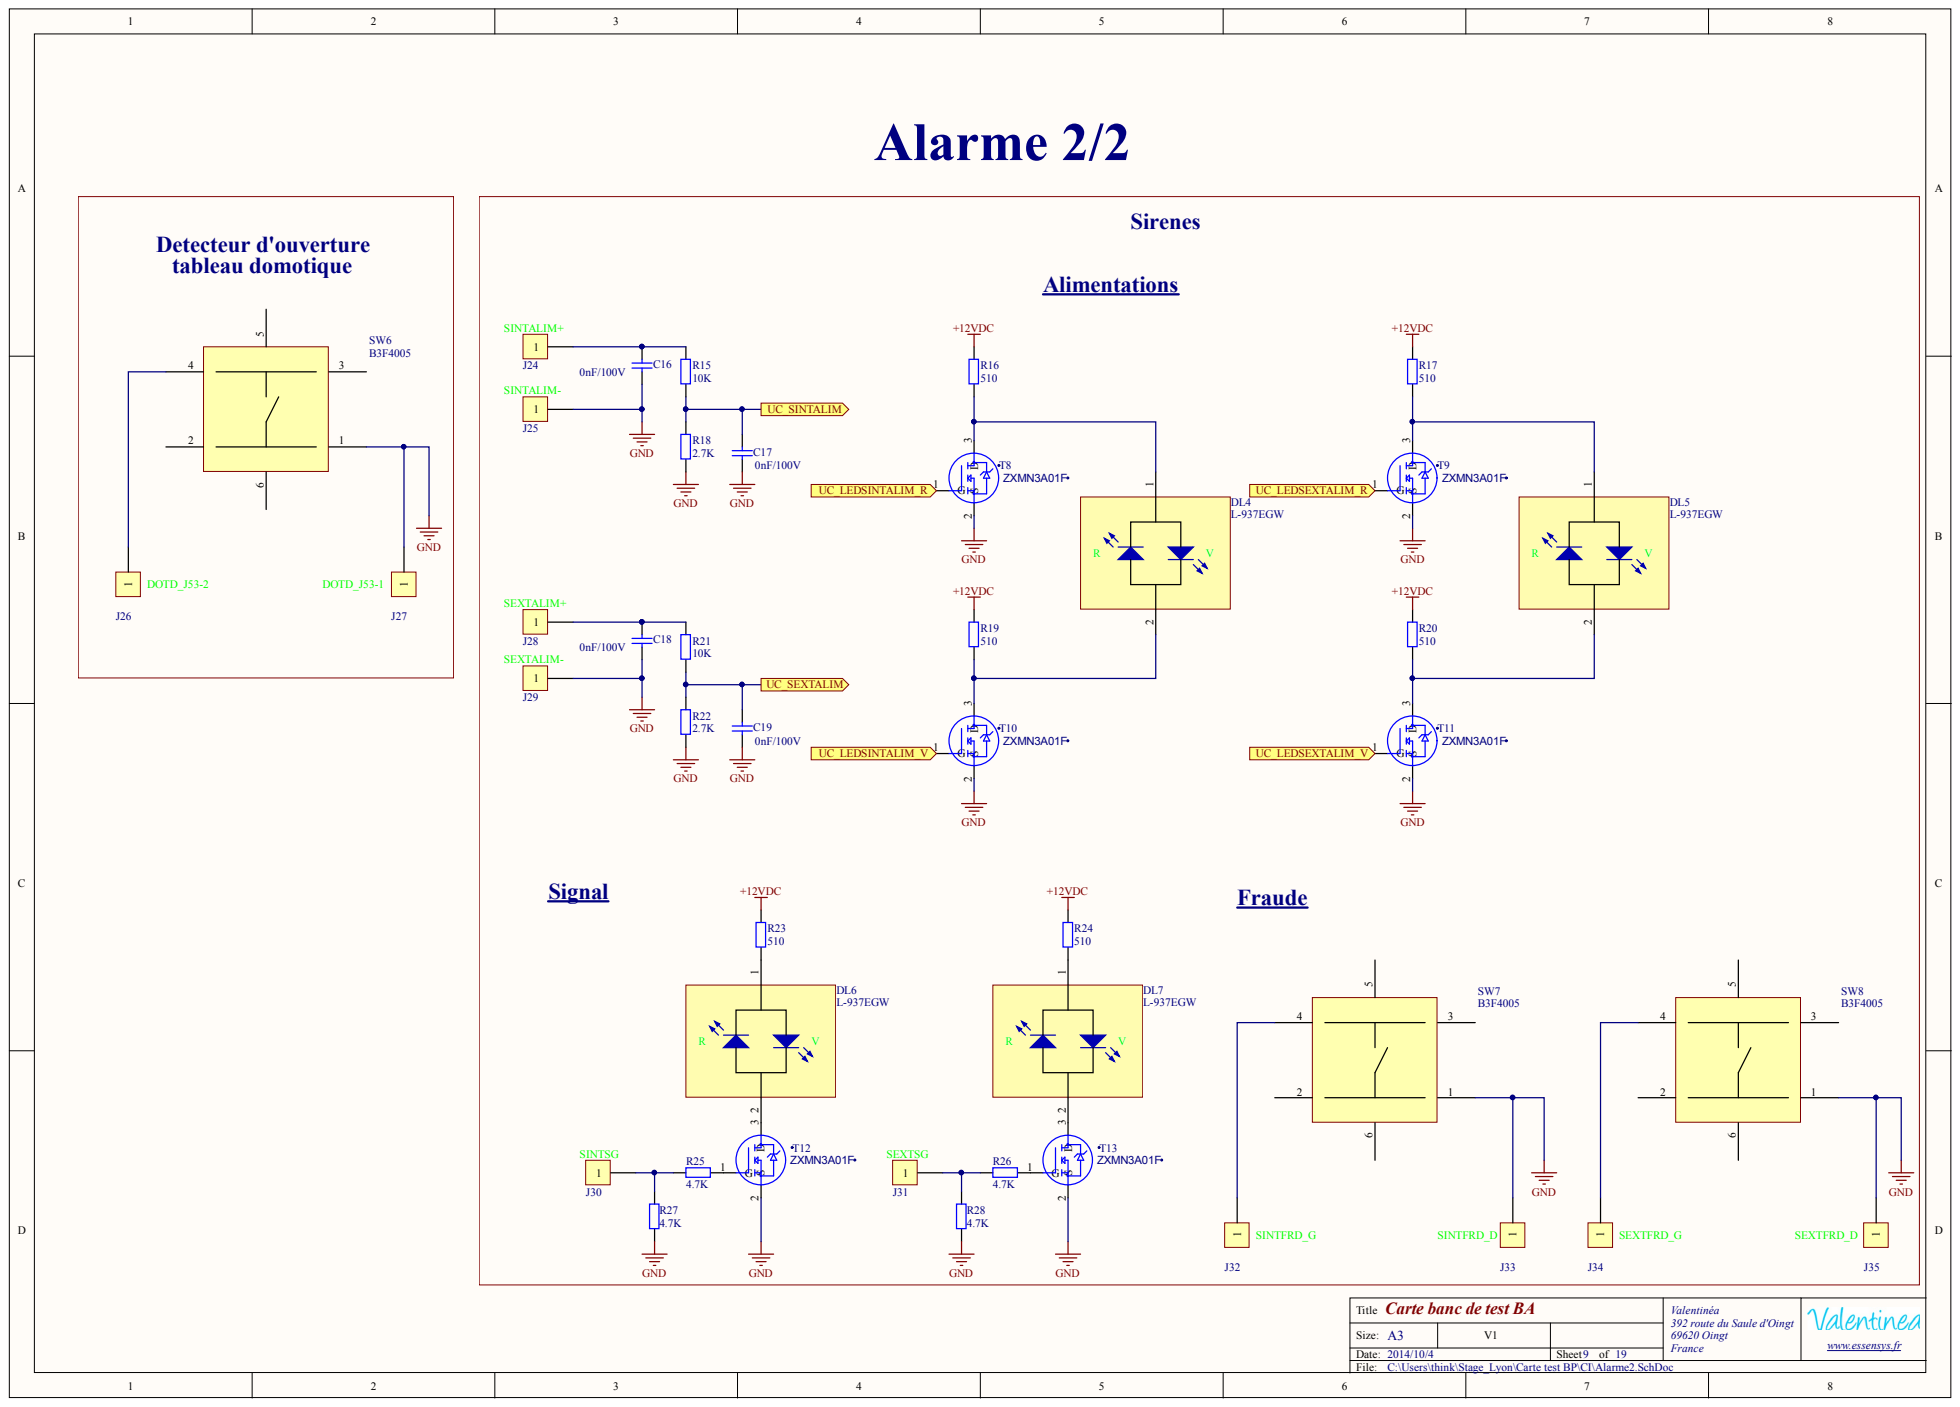
[picture p45: page 9]

C:\Users\think\Stage_Lyon\Carte test BP\CI\Alarme2.SchDoc

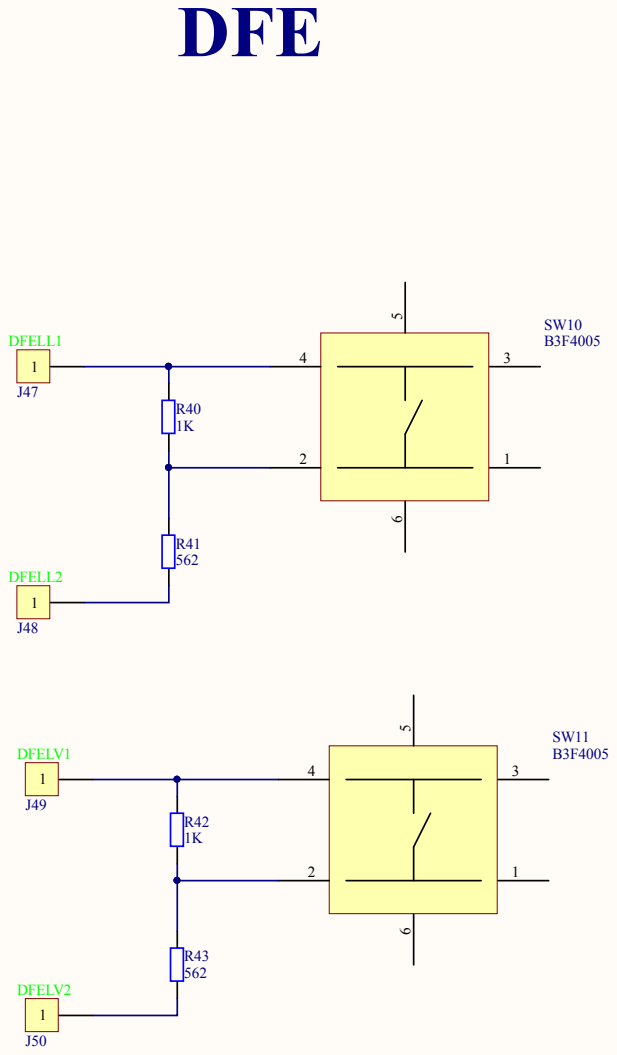
[picture p46: page 10]

C:\Users\think\Stage_Lyon\Carte test BP\CI\DFE.SchDoc

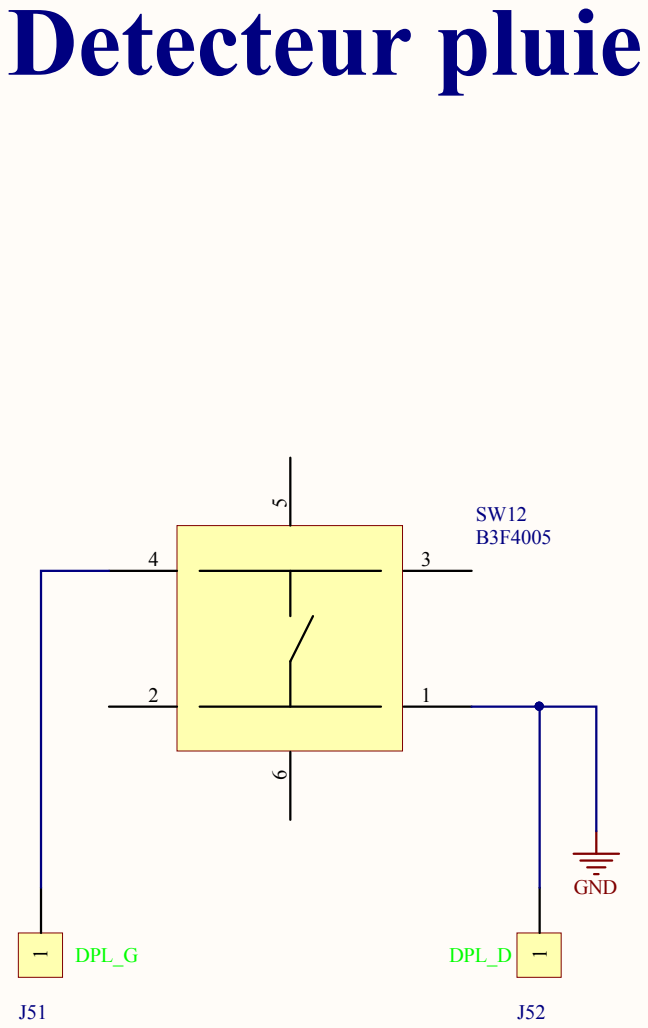
[picture p47: page 11]

C:\Users\think\Stage_Lyon\Carte test BP\CI\DPL.SchDoc

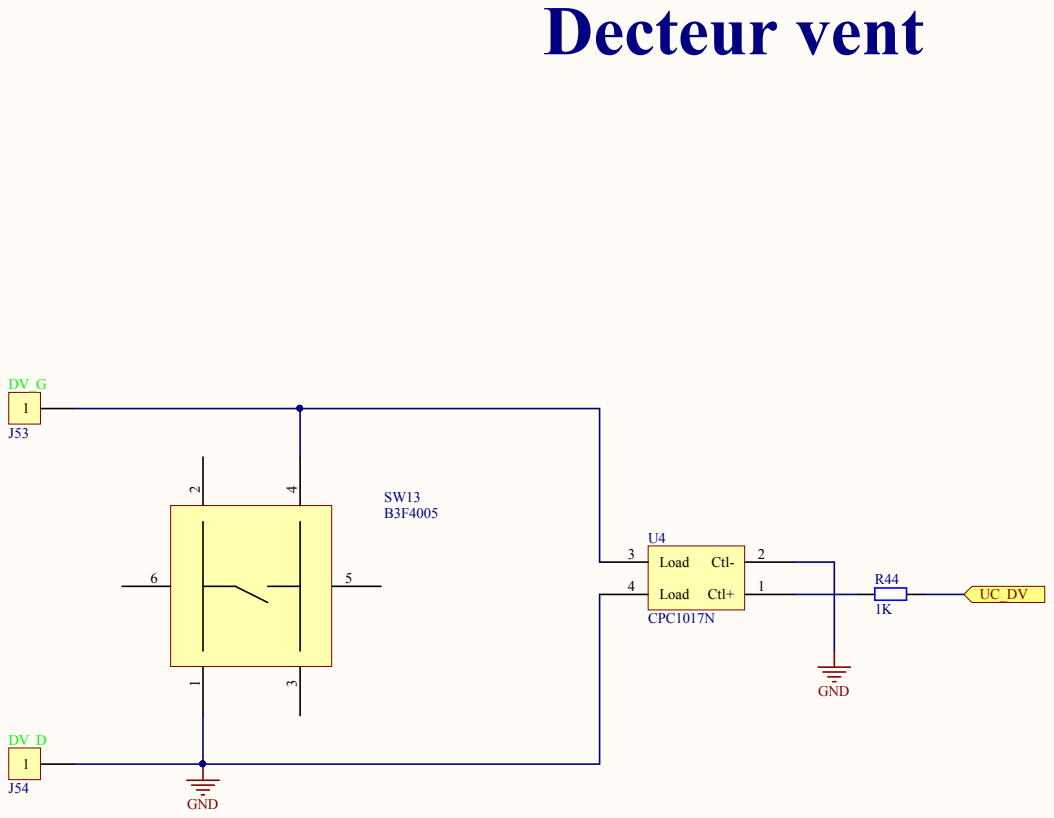
[picture p48: page 12]

C:\Users\think\Stage_Lyon\Carte test BP\CI\DV.SchDoc

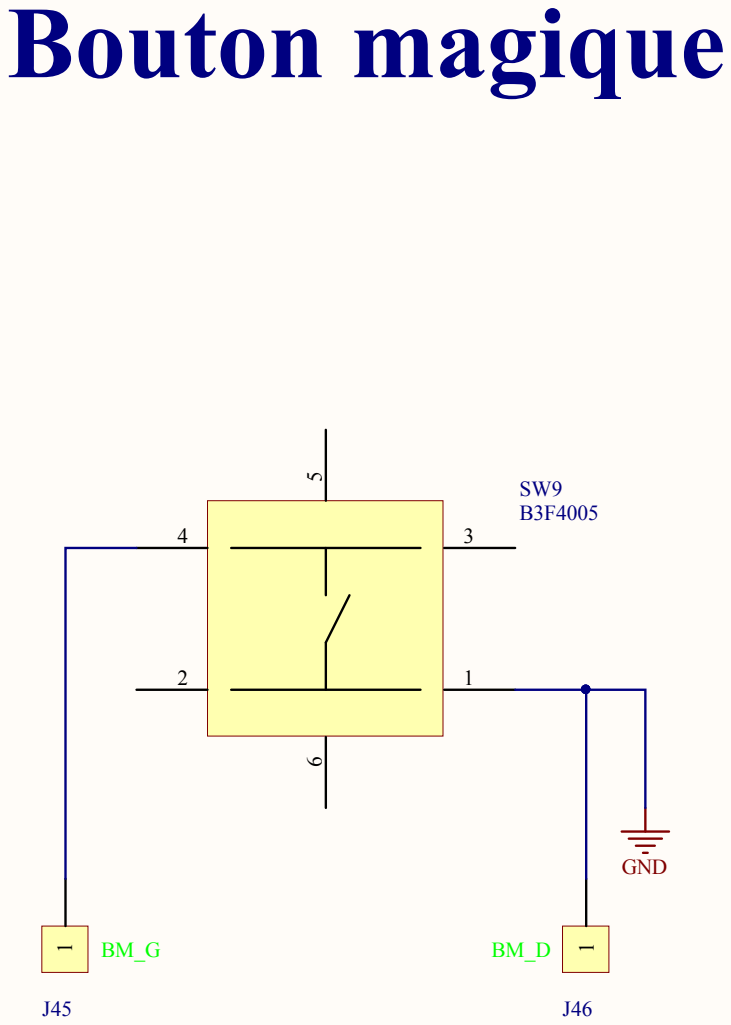
[picture p49: page 13]

C:\Users\think\Stage_Lyon\Carte test BP\CI\BM.SchDoc

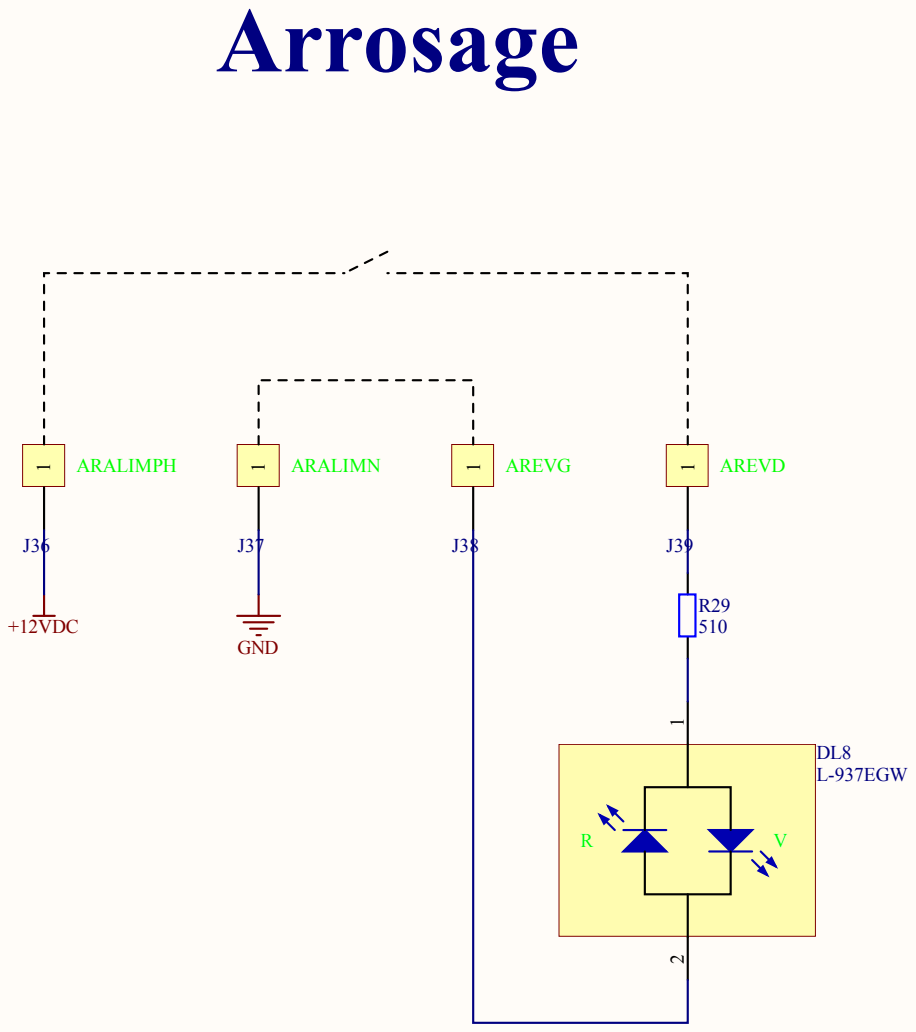
[picture p50: page 14]
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

Size: A | V
2014/10/

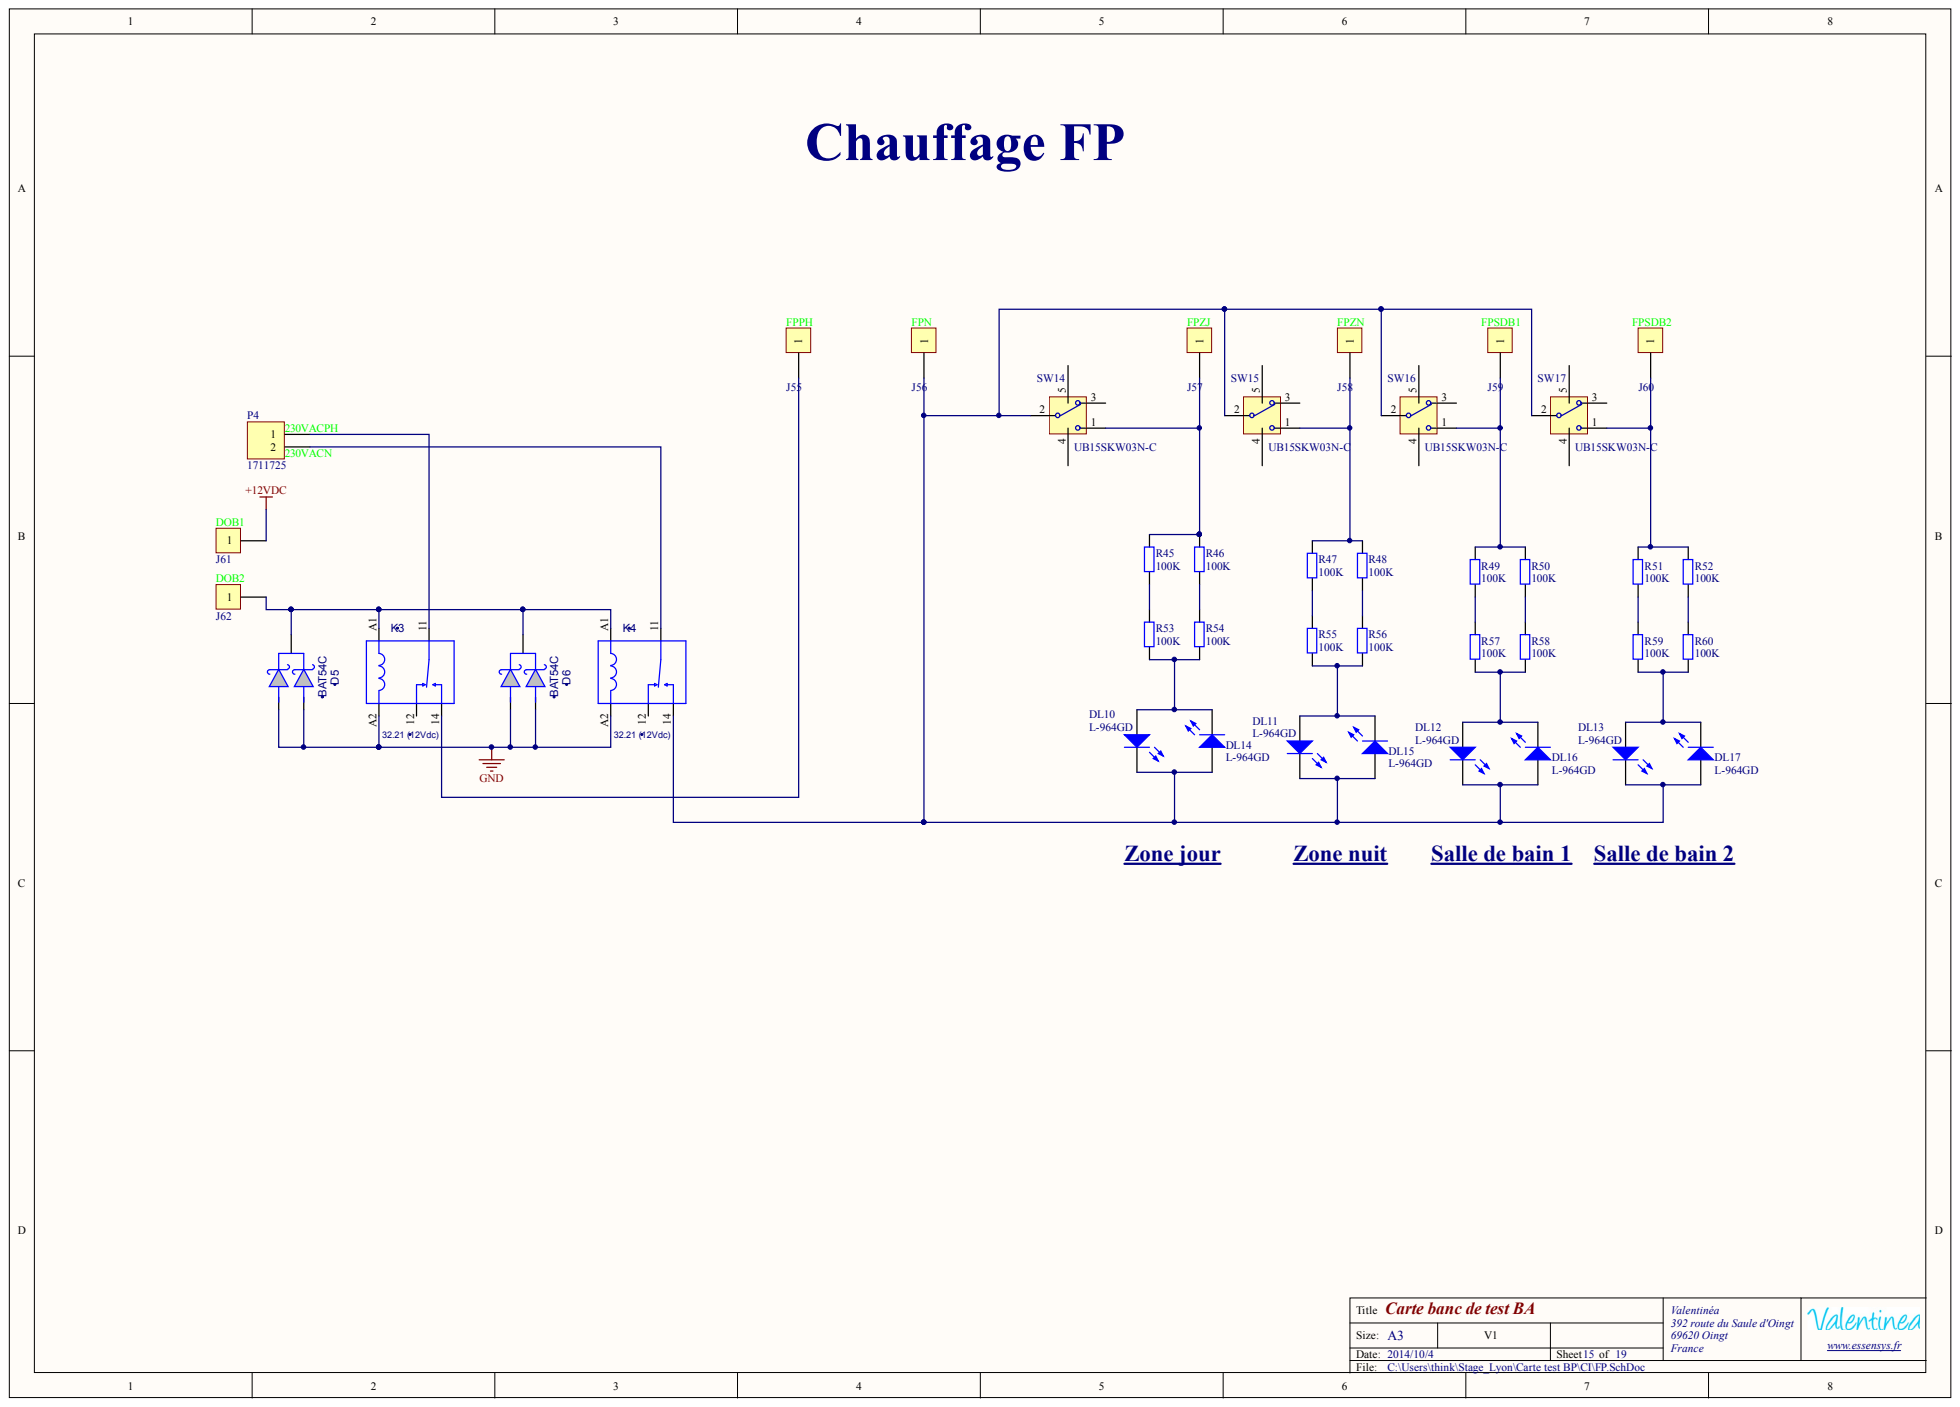
[picture p51: page 15]

C NBAT54C D5

32.21 (12Vdc)

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

Size: A | V
2014/10/

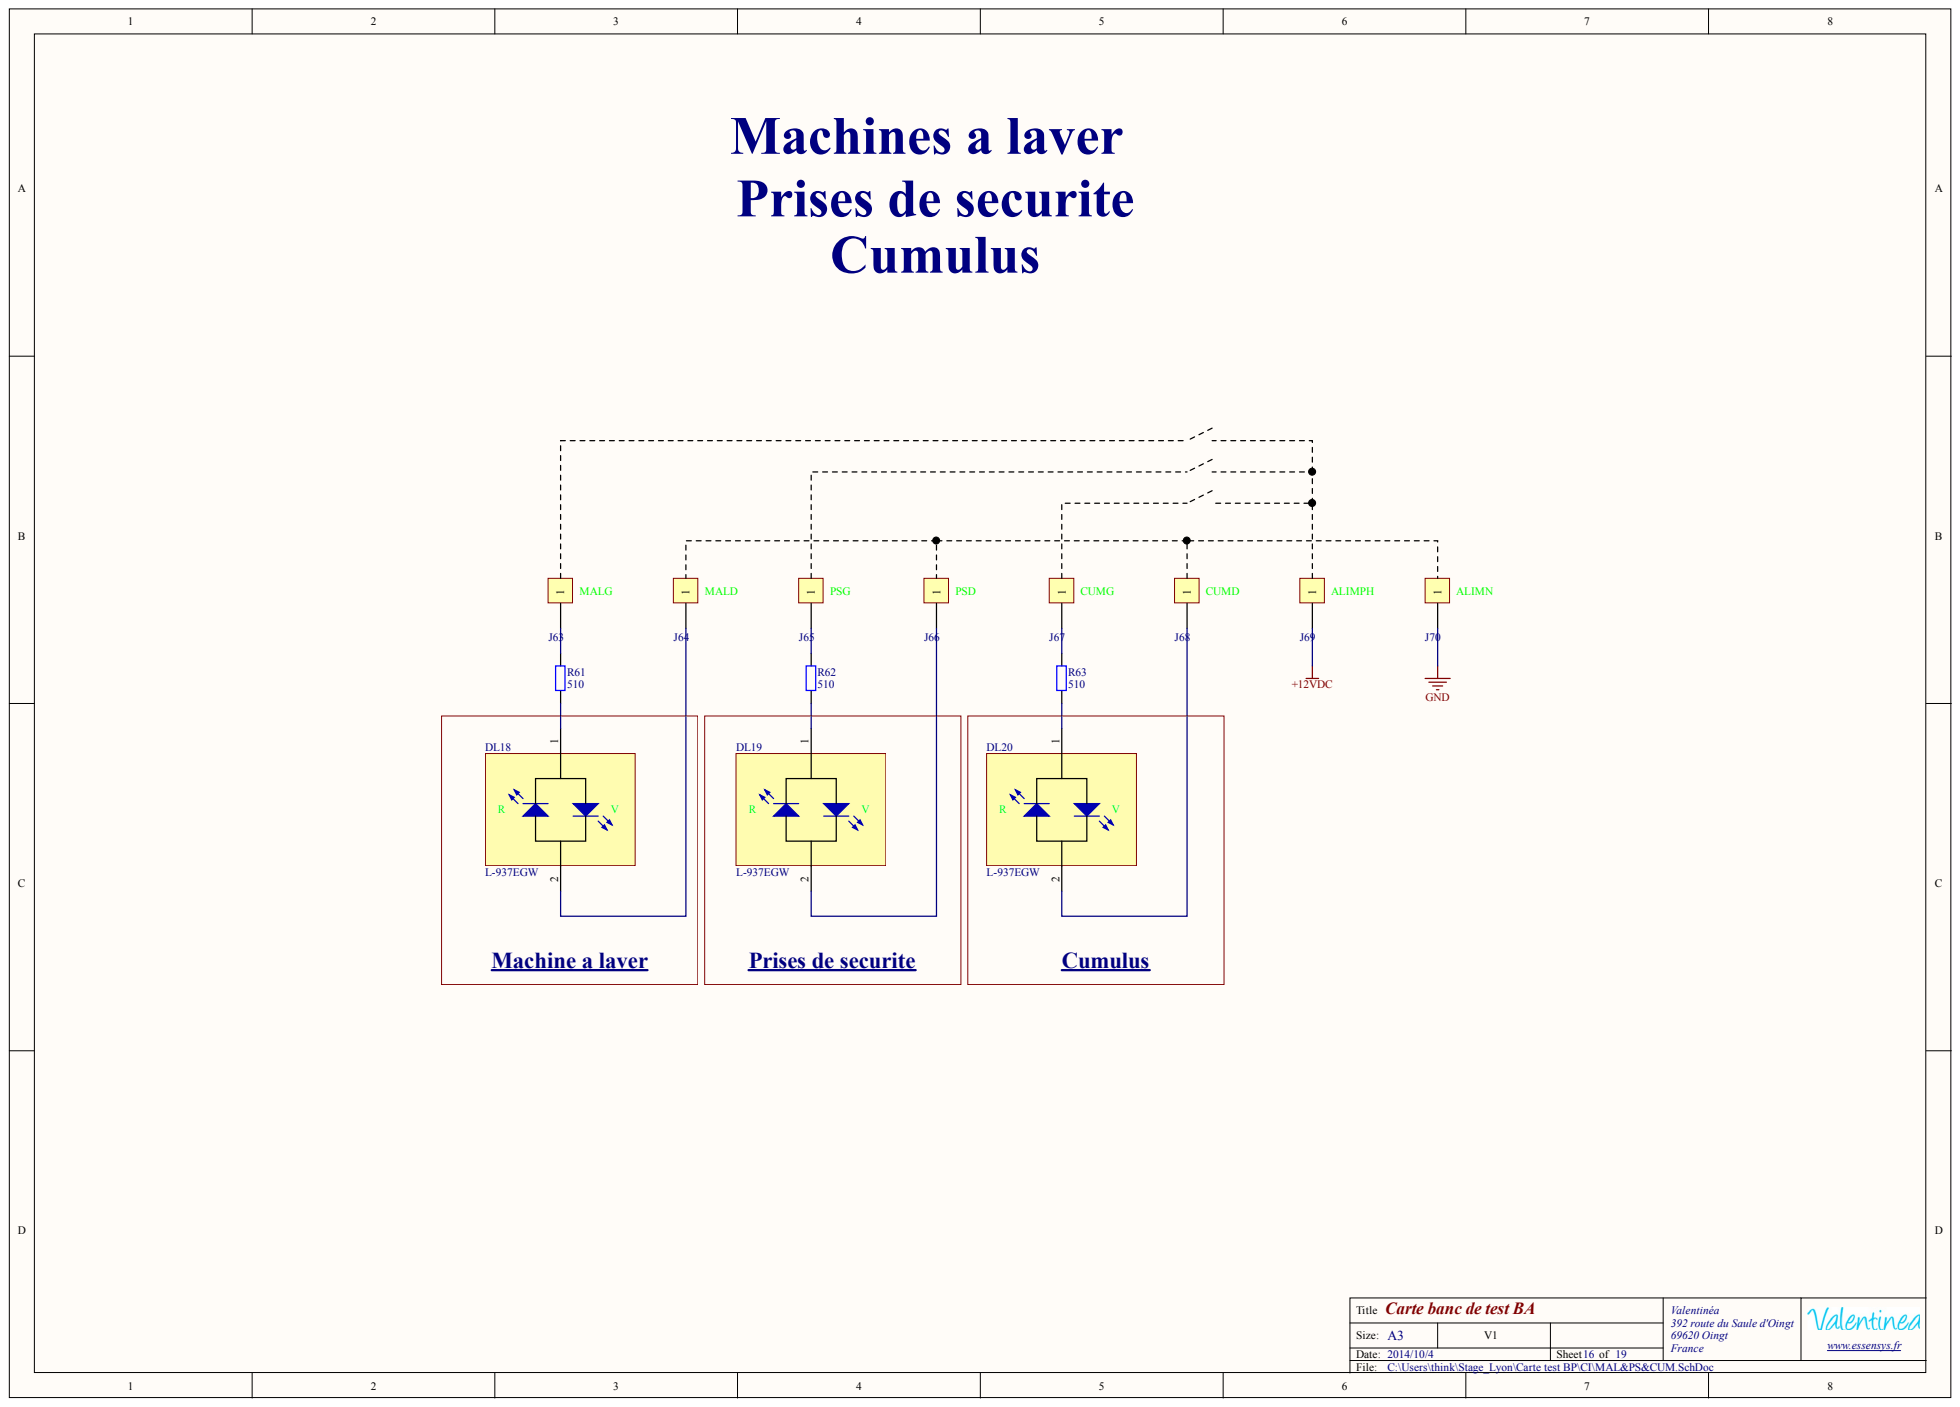
[picture p52: page 16]

C:\Users\think\Stage_Lyon\Carte test BP\CI\MAL&PS&CUM.SchDoc

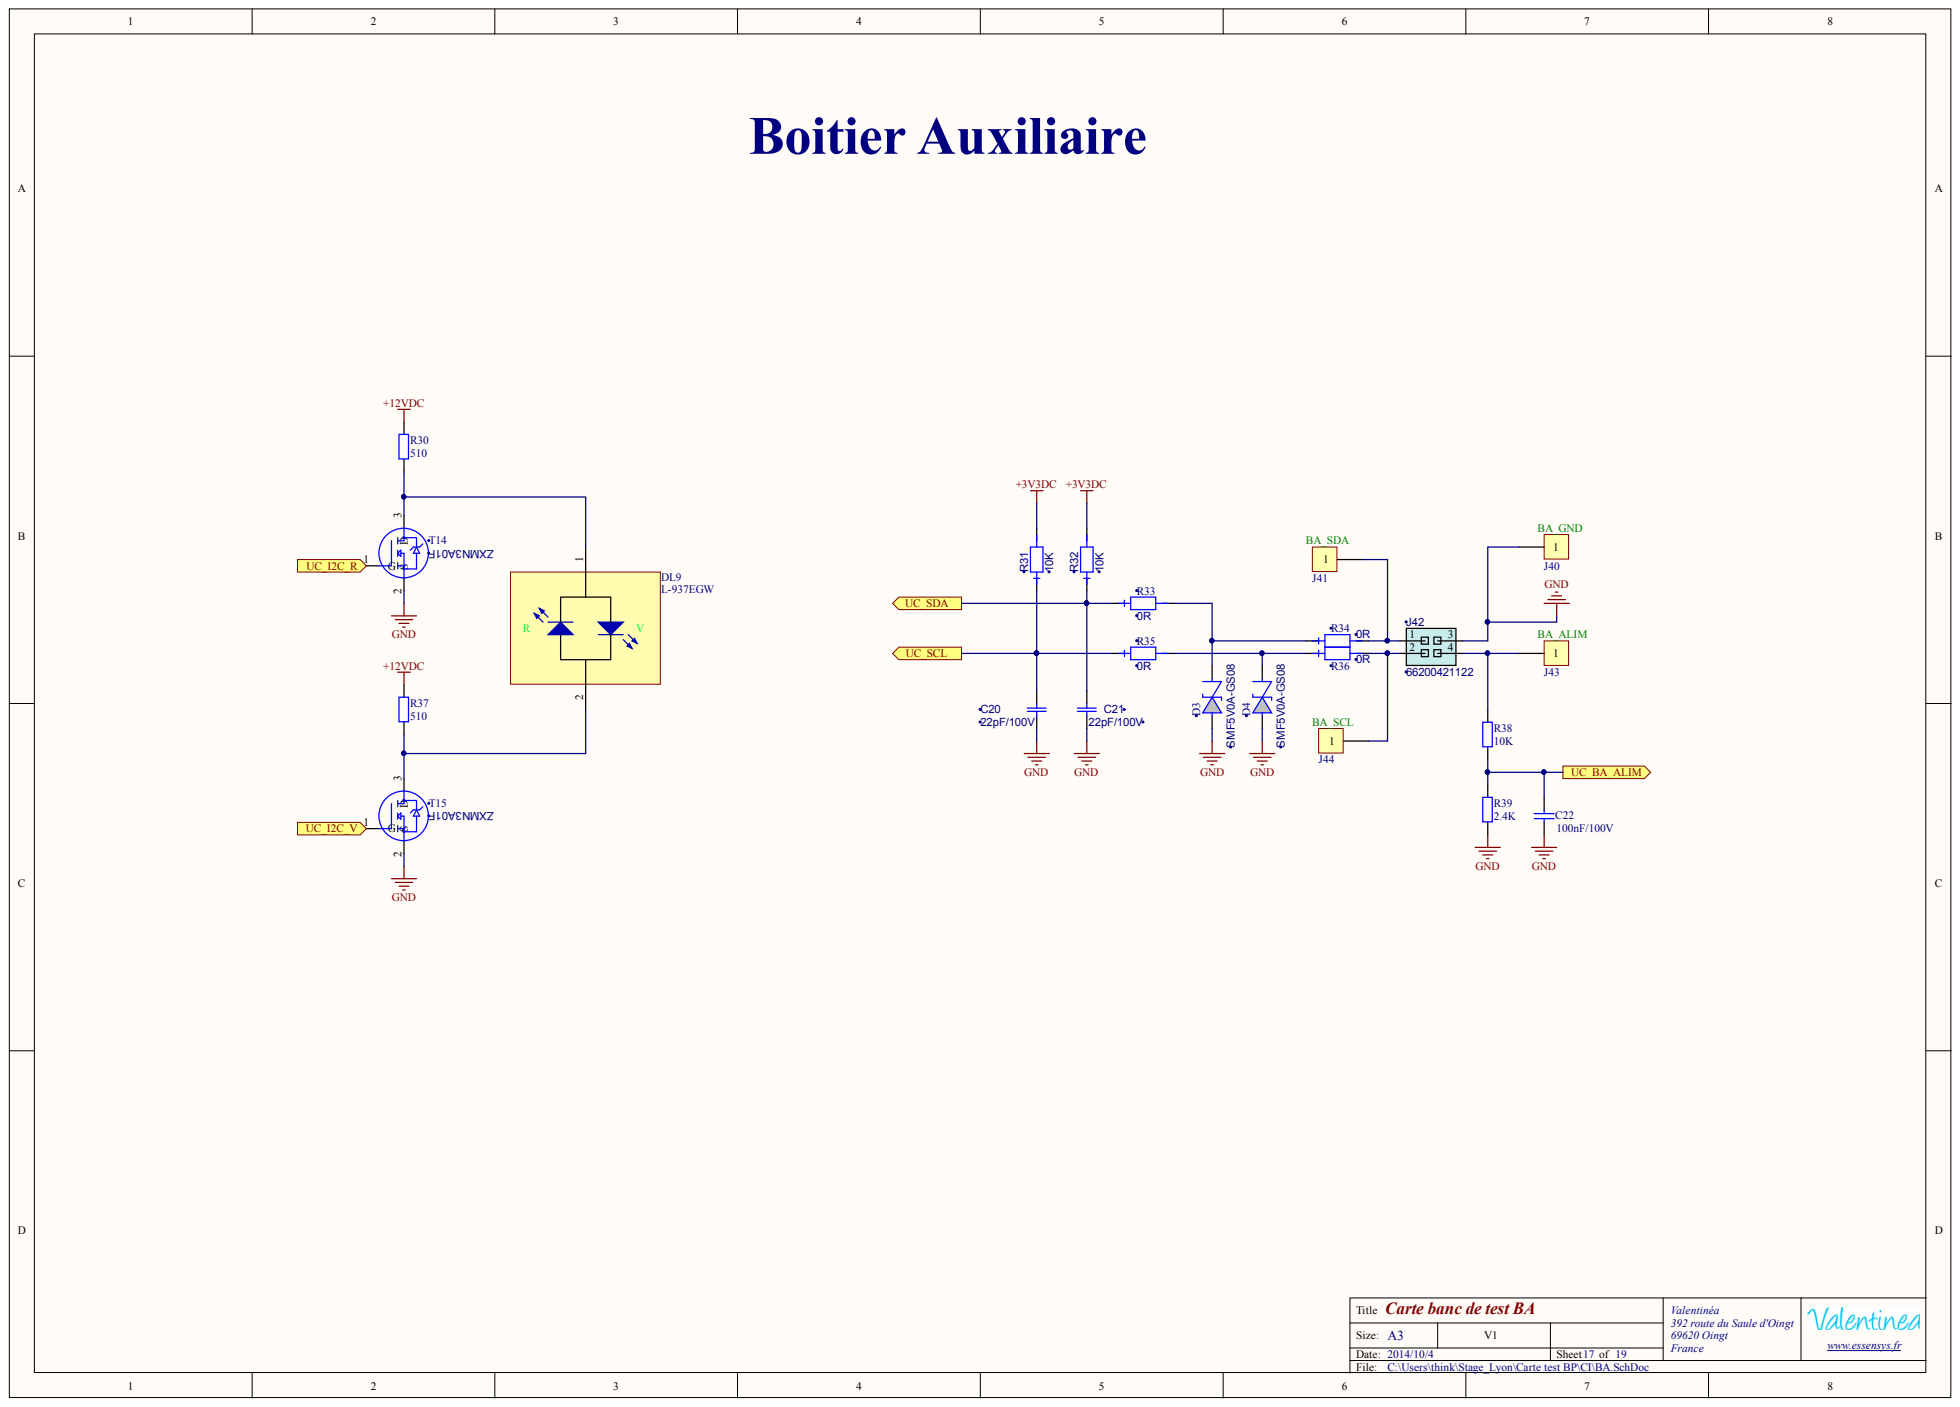
[picture p53: page 17]
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

Size: A | V
2014/10/

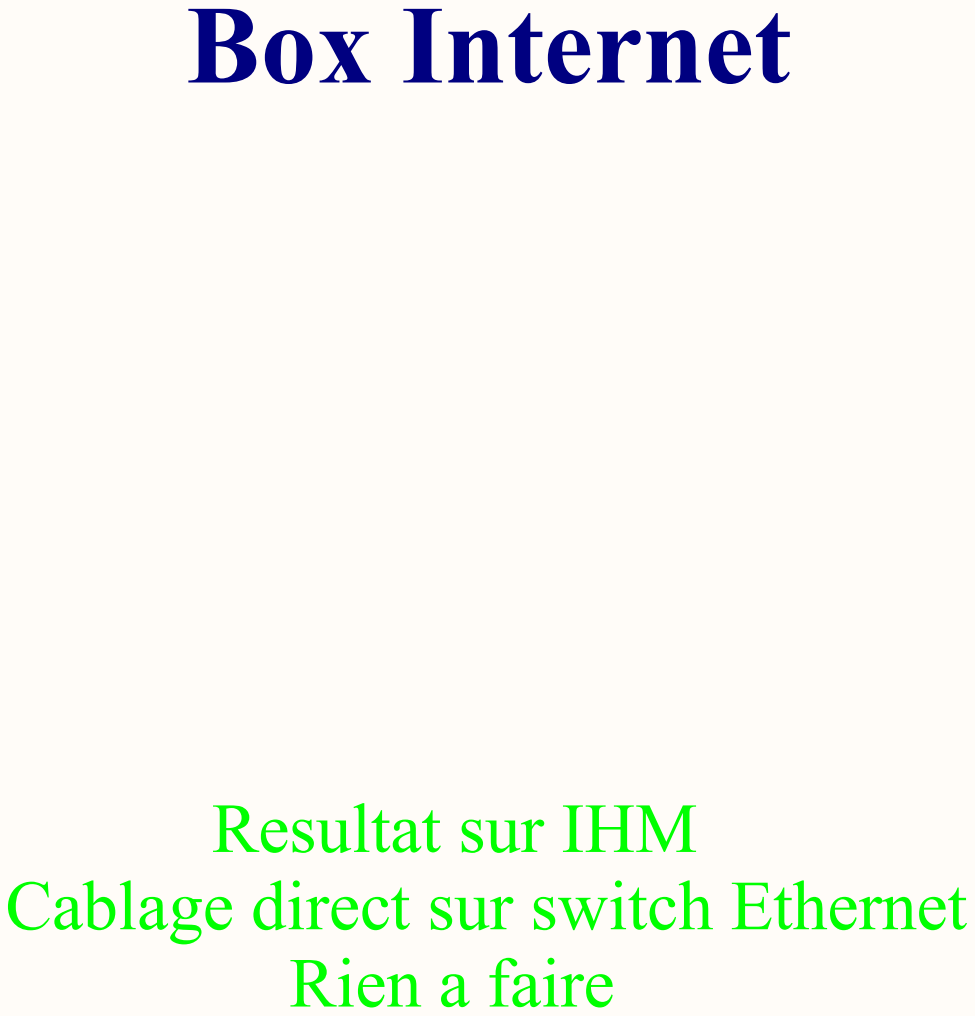
[picture p54: page 18]

Cablage direct sur switch Ethernet

C:\Users\think\Stage_Lyon\Carte test BP\CI\Eternet.SchDoc

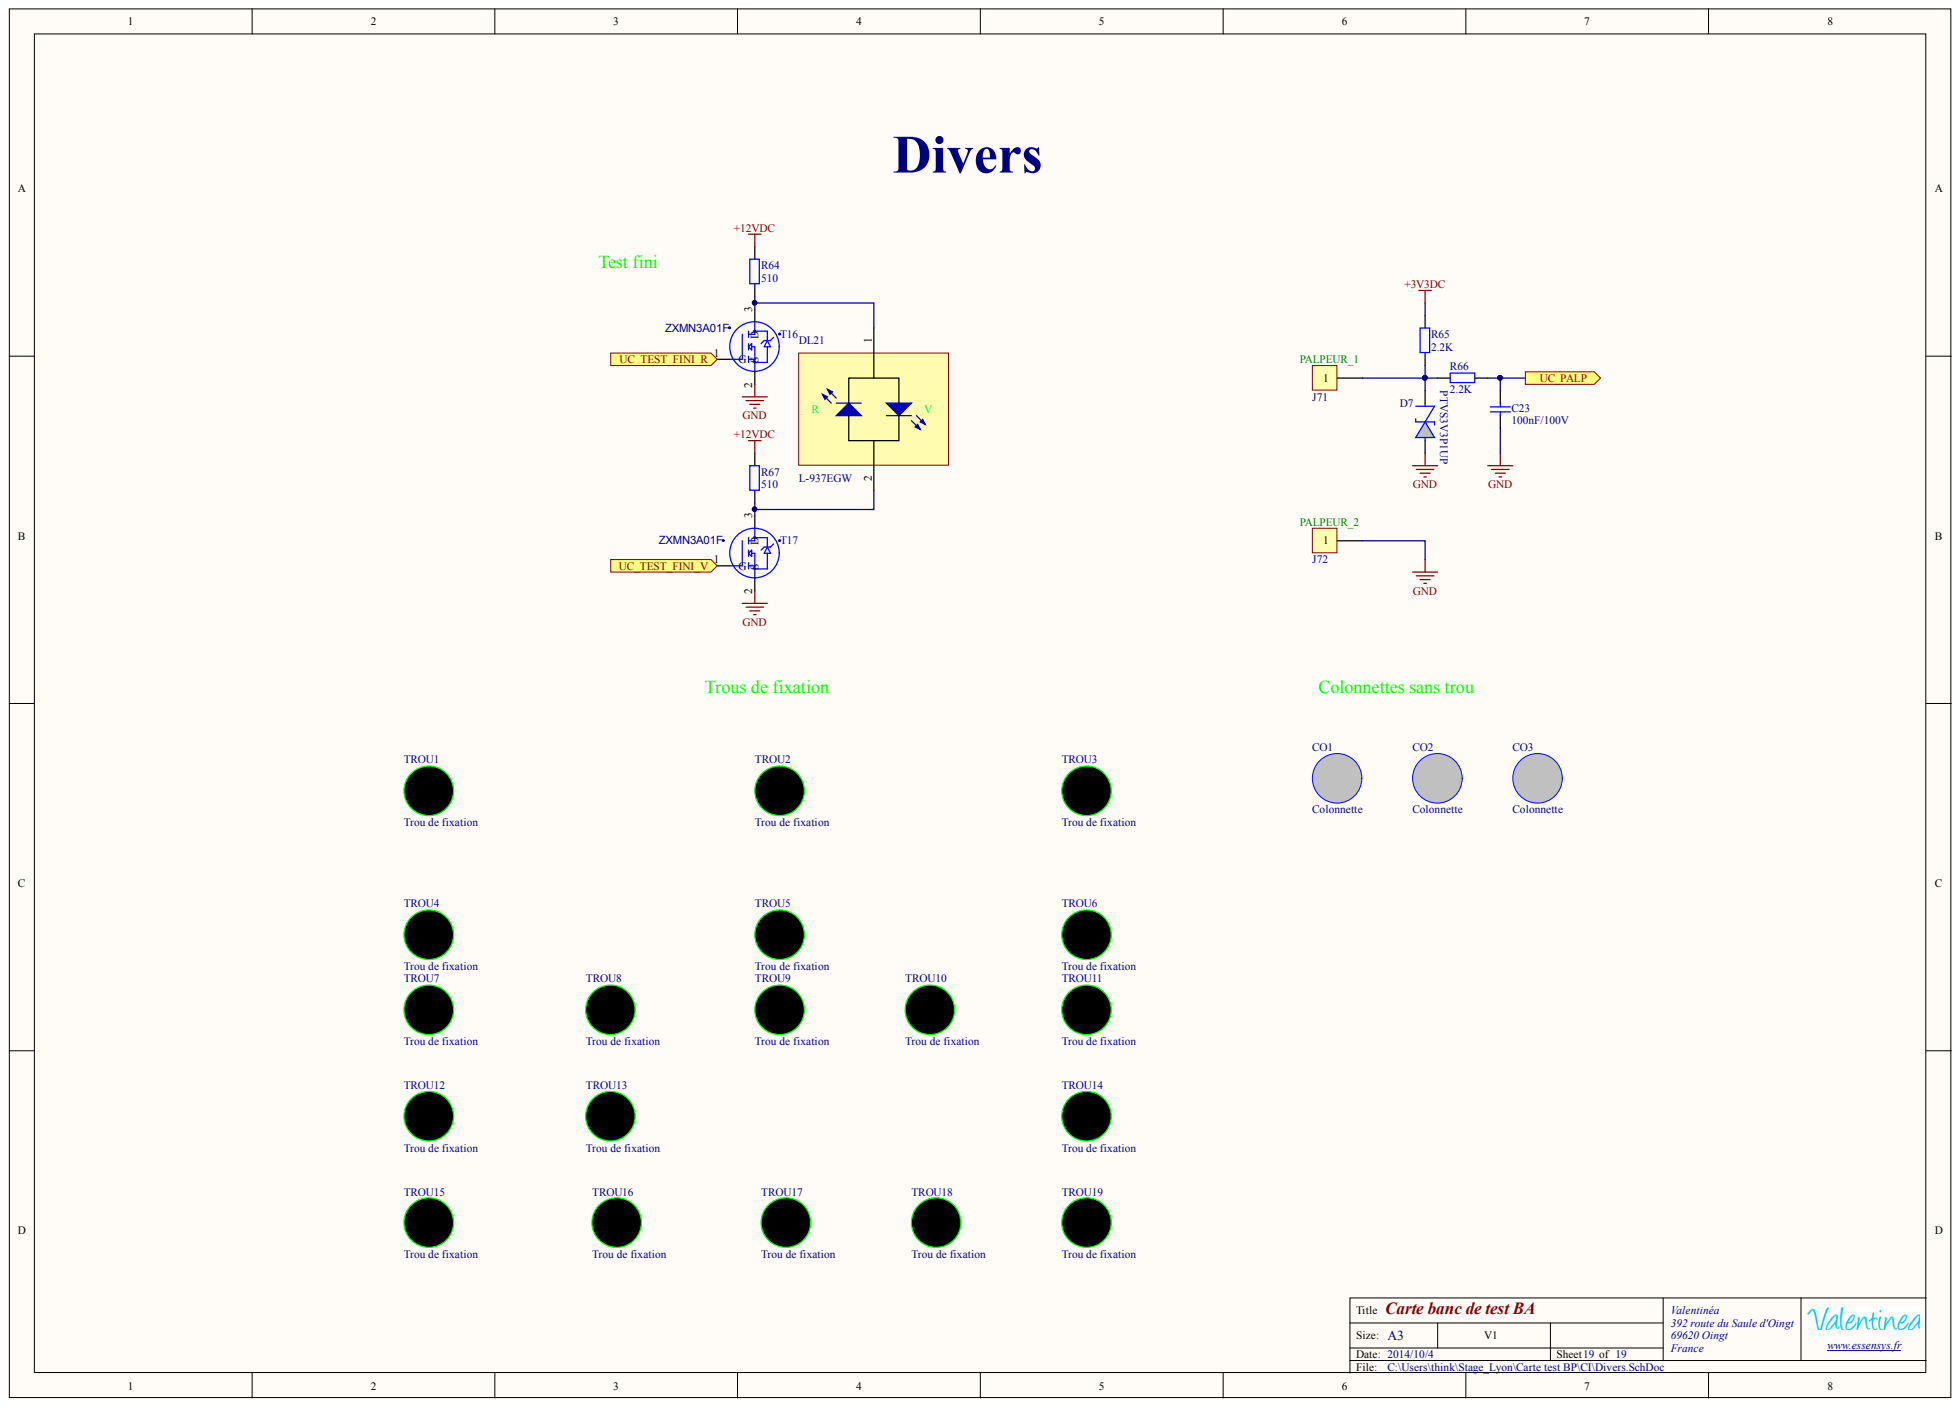
[picture p55: page 19]

C:\Users\think\Stage_Lyon\Carte test BP\CI\Divers.SchDoc
