essensys-hub/essensys-test-banc-SC944D/mecanique-arf-test-6281/ASM's Affaire/6281_005 (ARF-PLC 320 - SC944).pdf

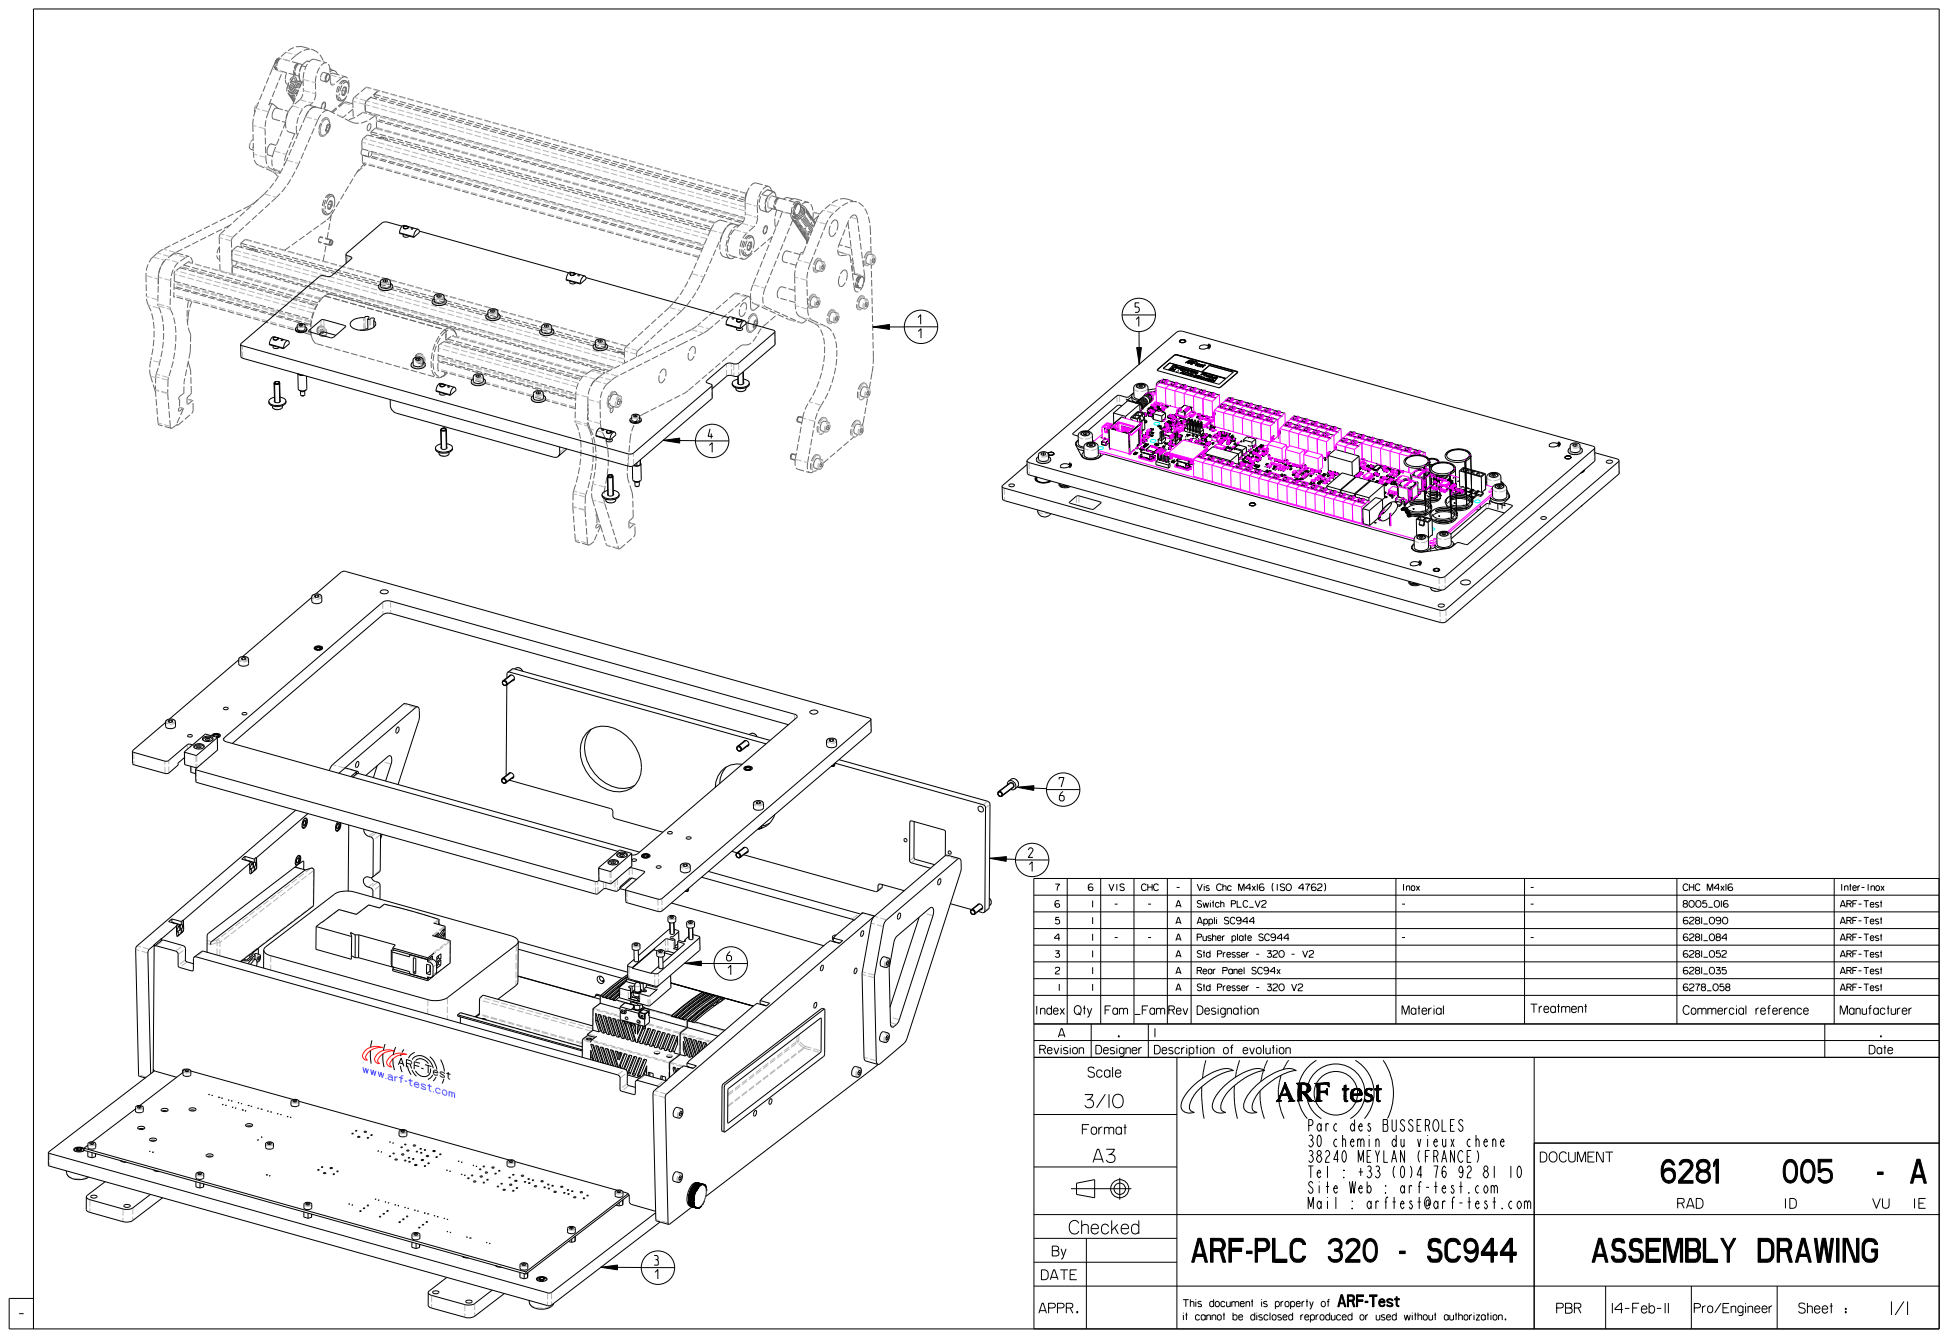
[picture p57: page 1]
