essensys-hub/essensys-test-banc-SC944D/mecanique-arf-test-6281/ASM's Affaire/6281_035 (Rear Panel SC94x).pdf

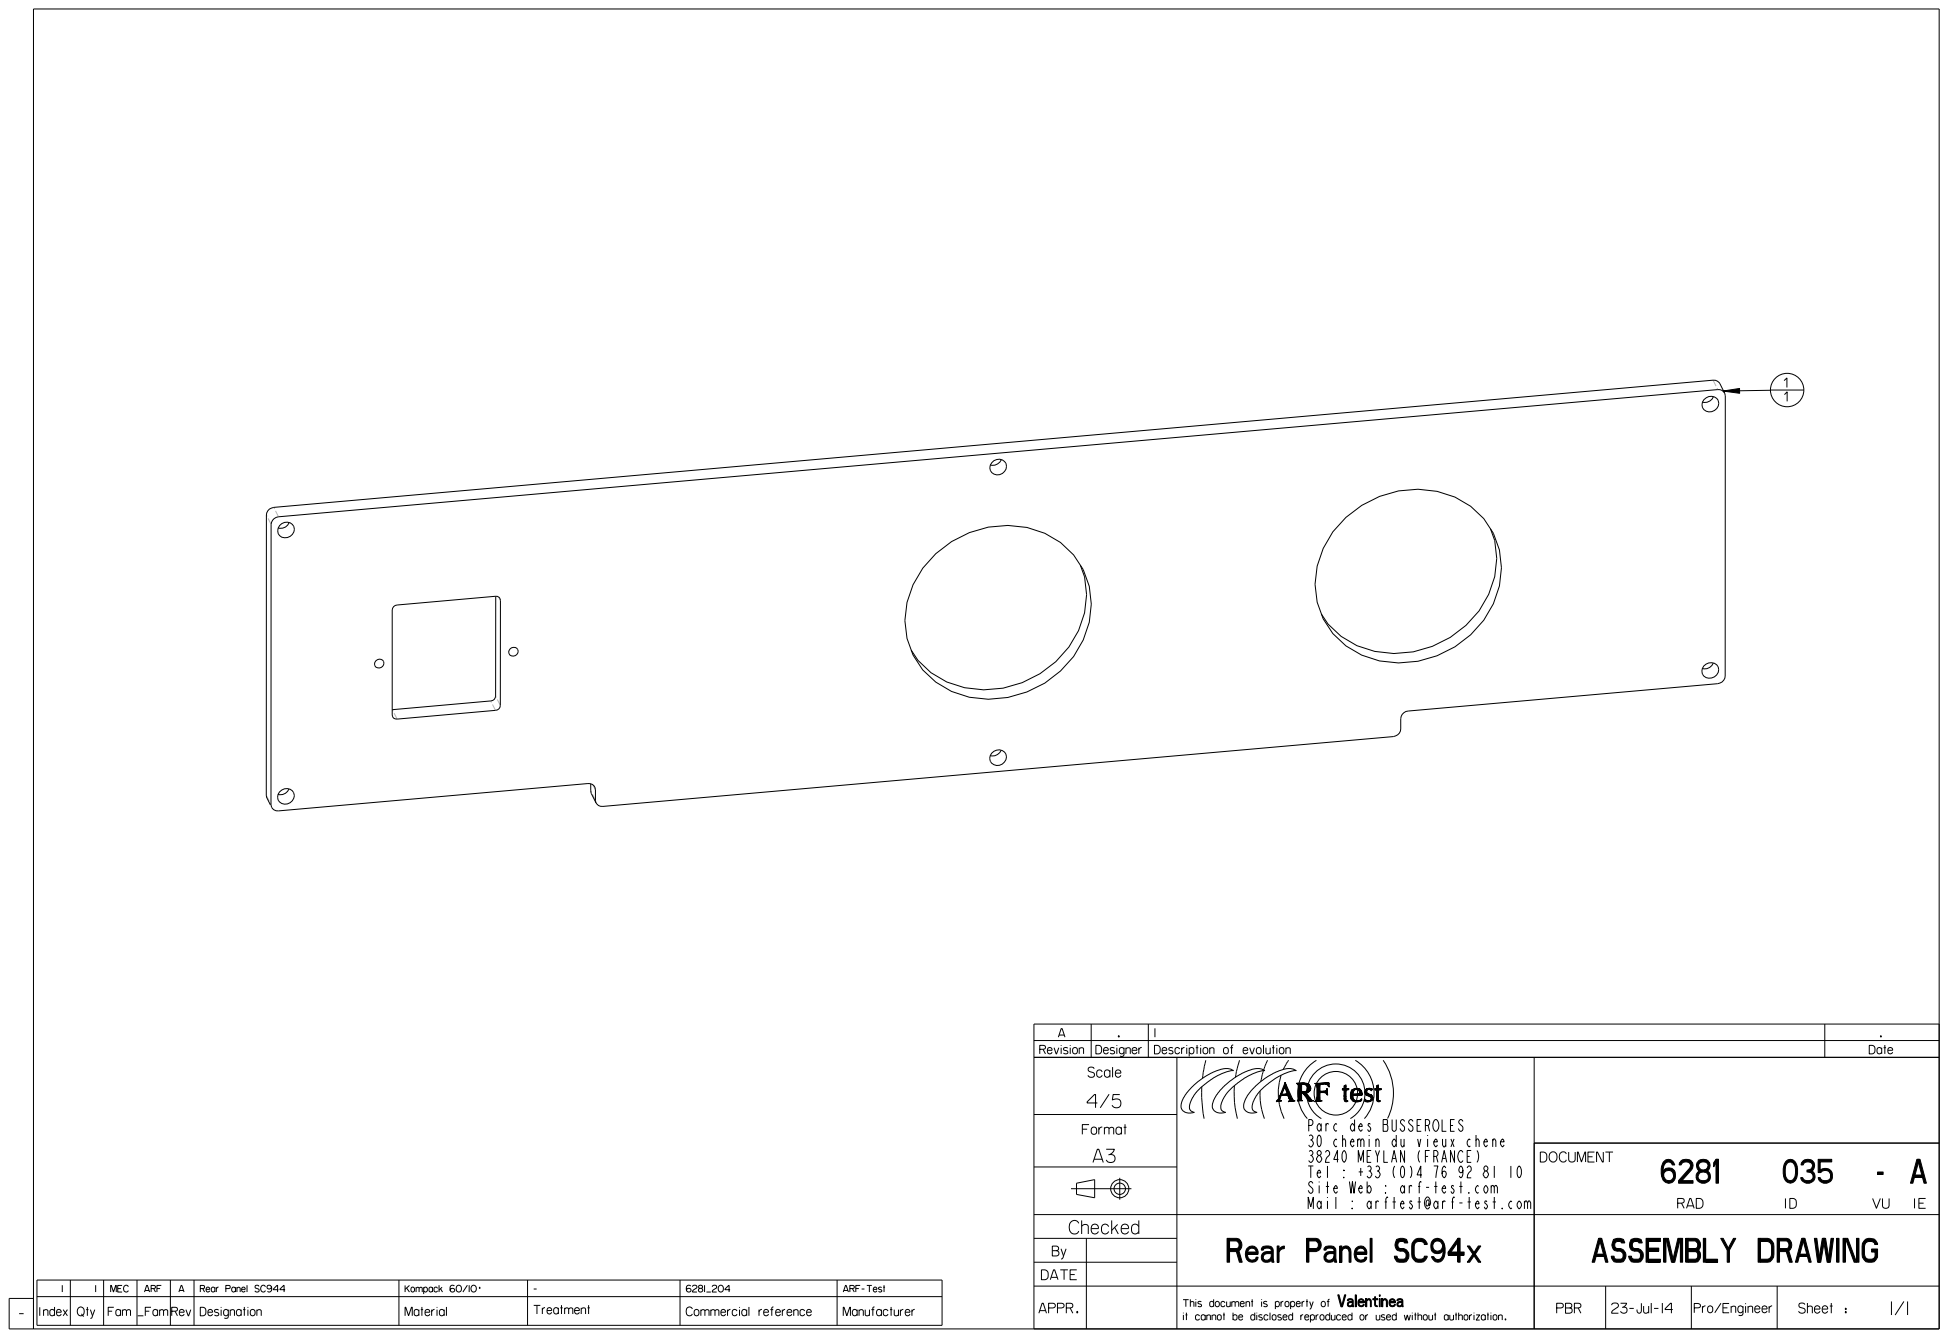
[picture p58: page 1]
