essensys-hub/essensys-test-banc-SC944D/mecanique-arf-test-6281/ASM's Affaire/6281_052 (Std Presser - 320 - V2).pdf

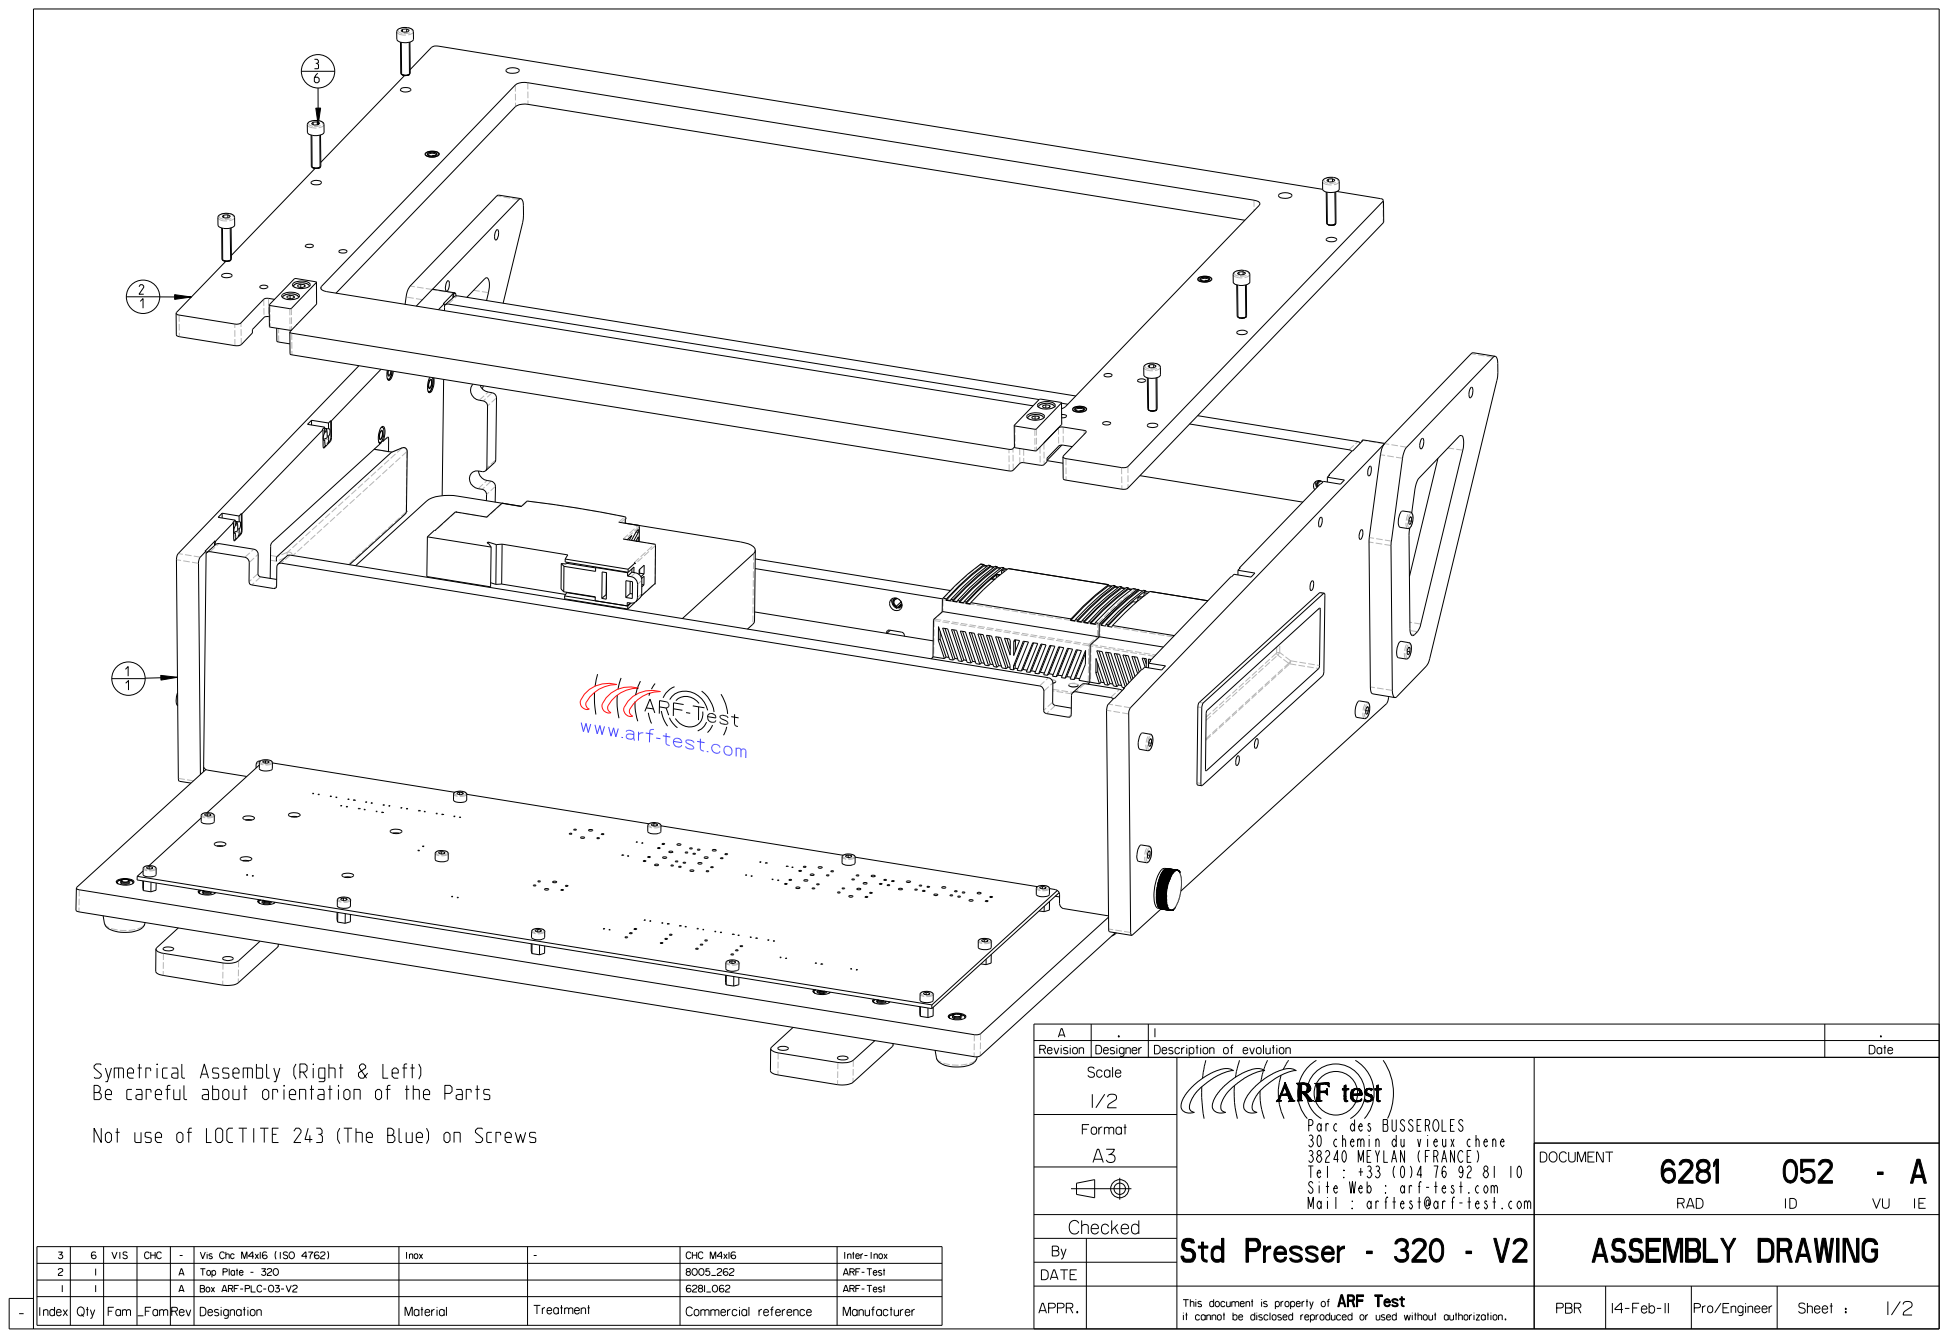
[picture p59: page 1]

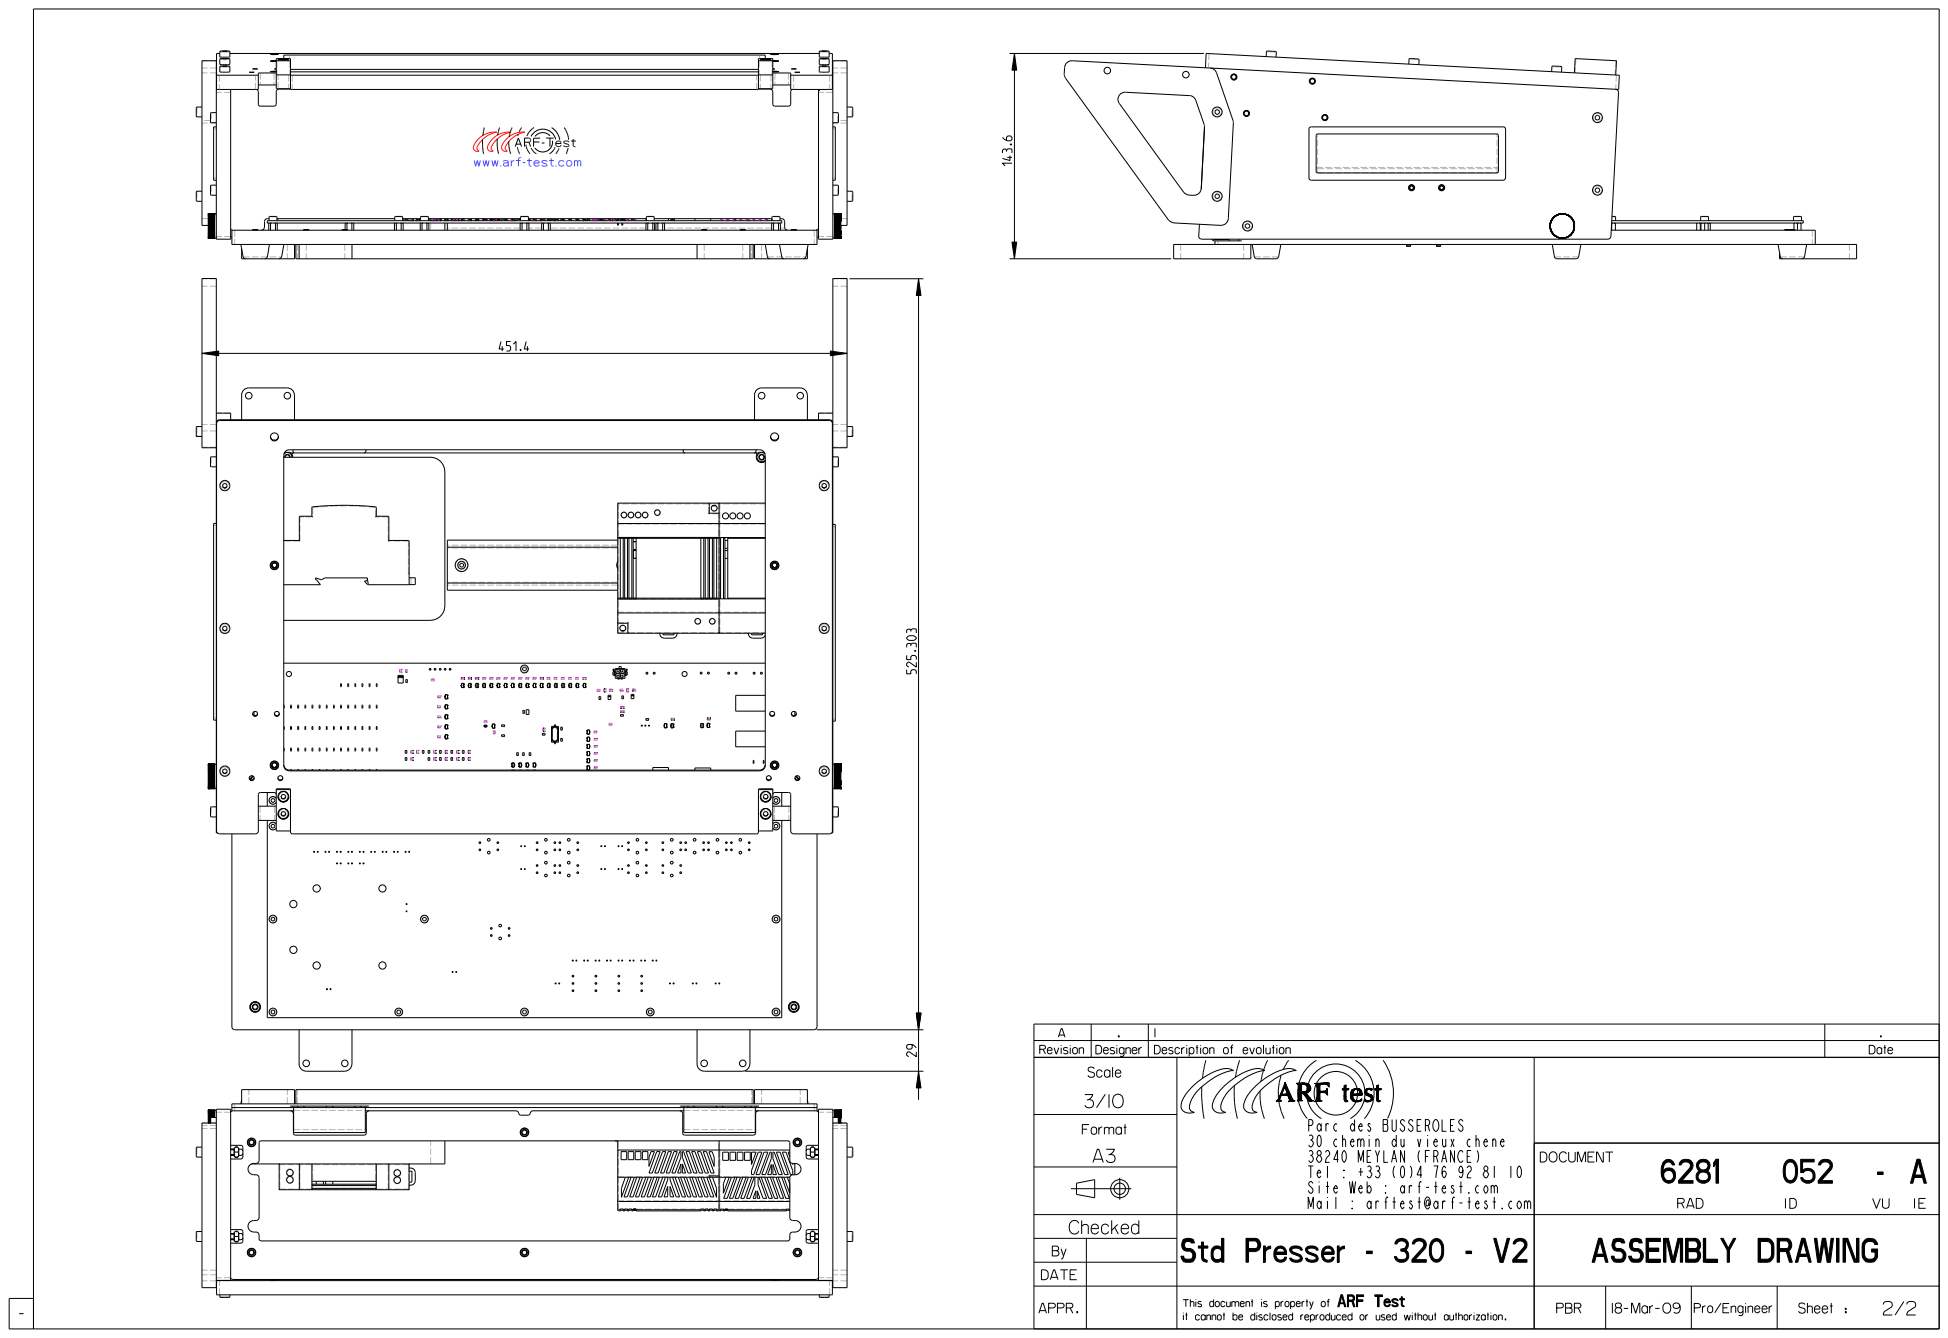
[picture p60: page 2]
