essensys-hub/essensys-test-banc-SC944D/mecanique-arf-test-6281/ASM's Affaire/6281_062 (Box ARF-PLC-03-V2).pdf

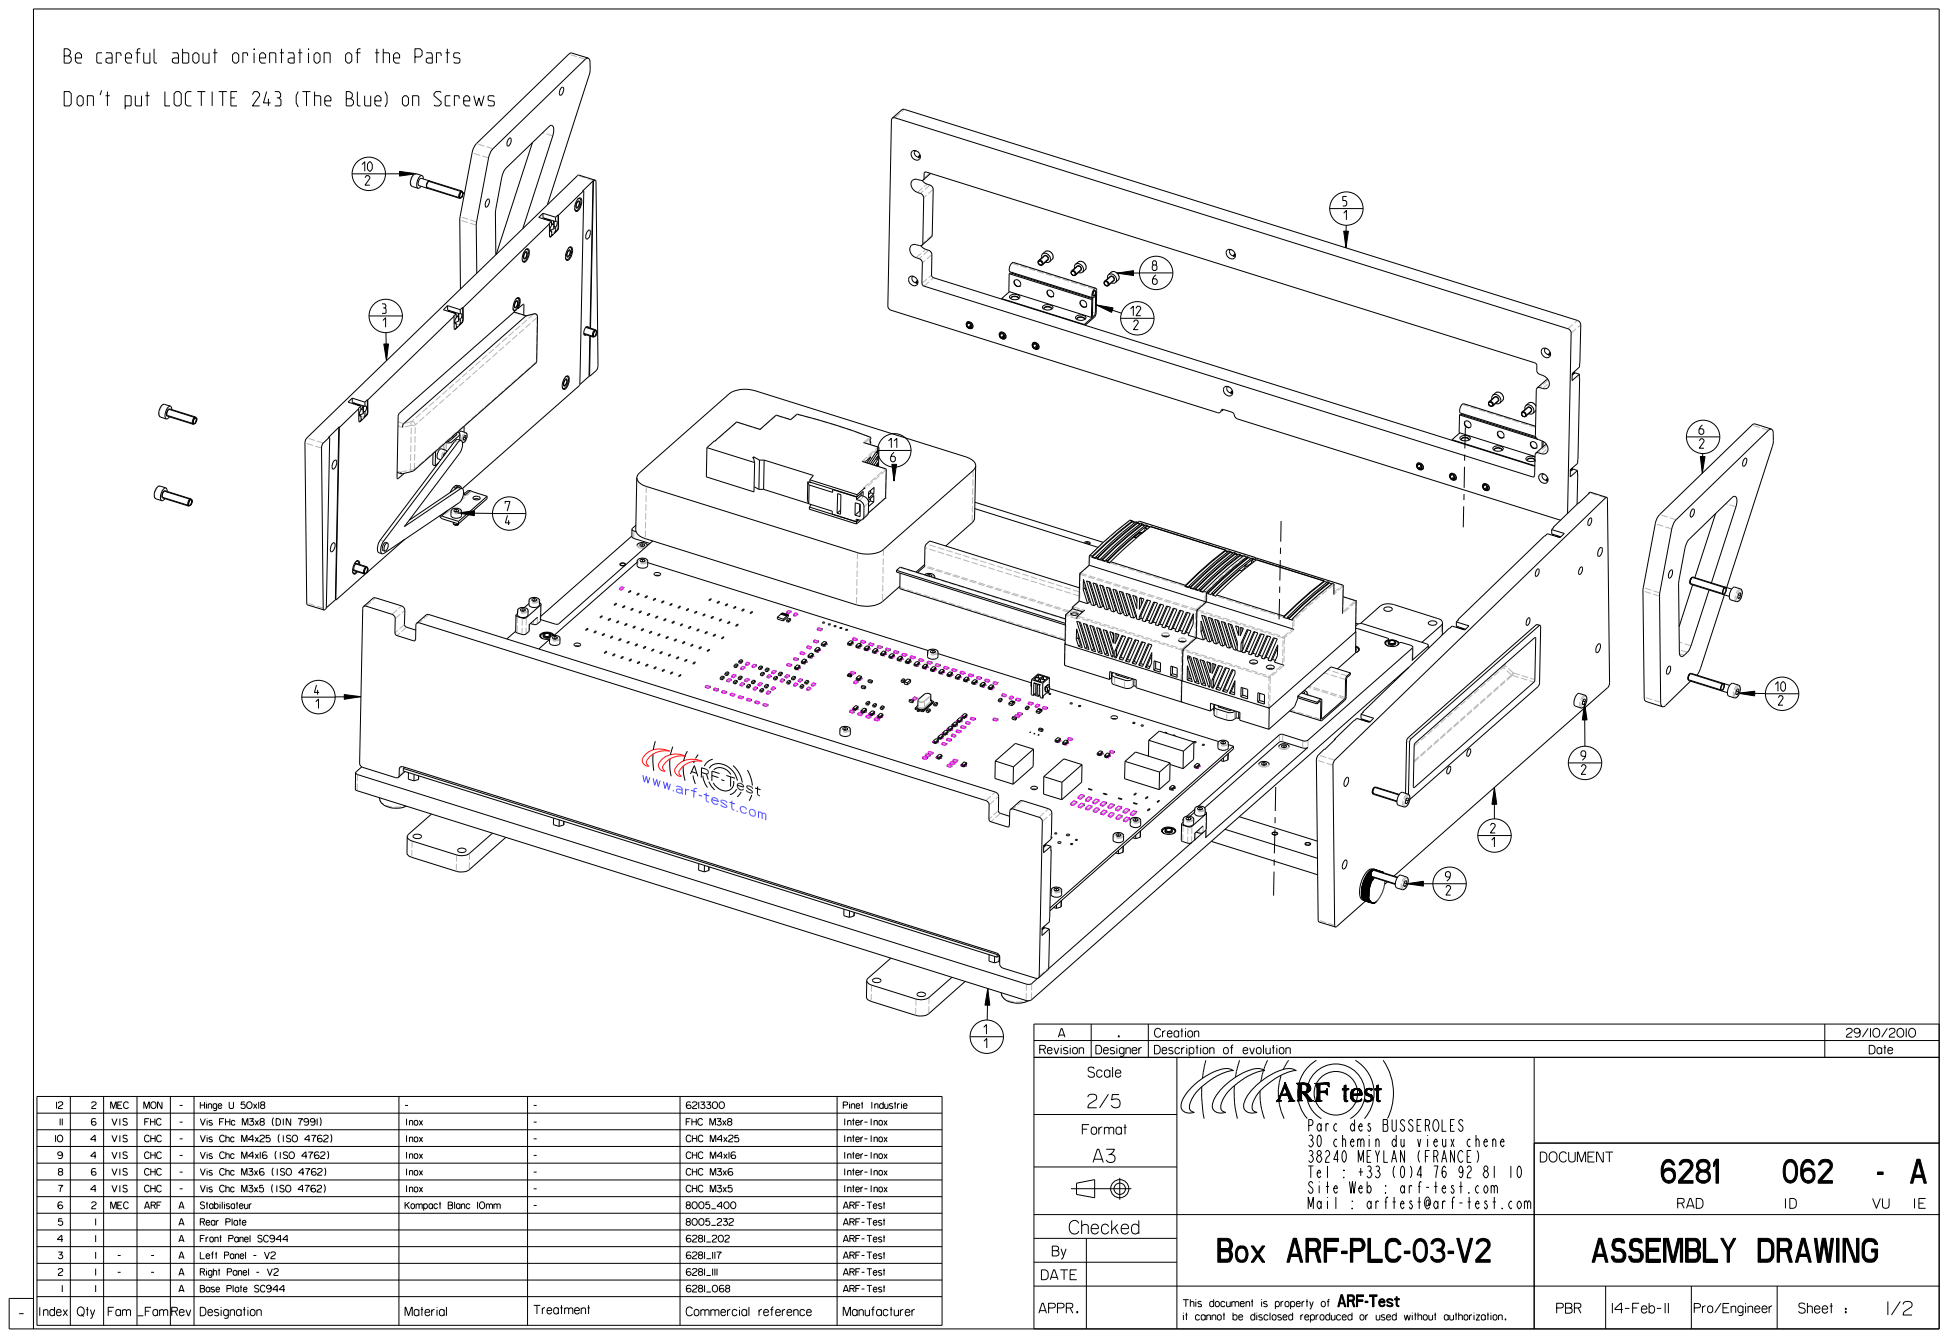
[picture p61: page 1]

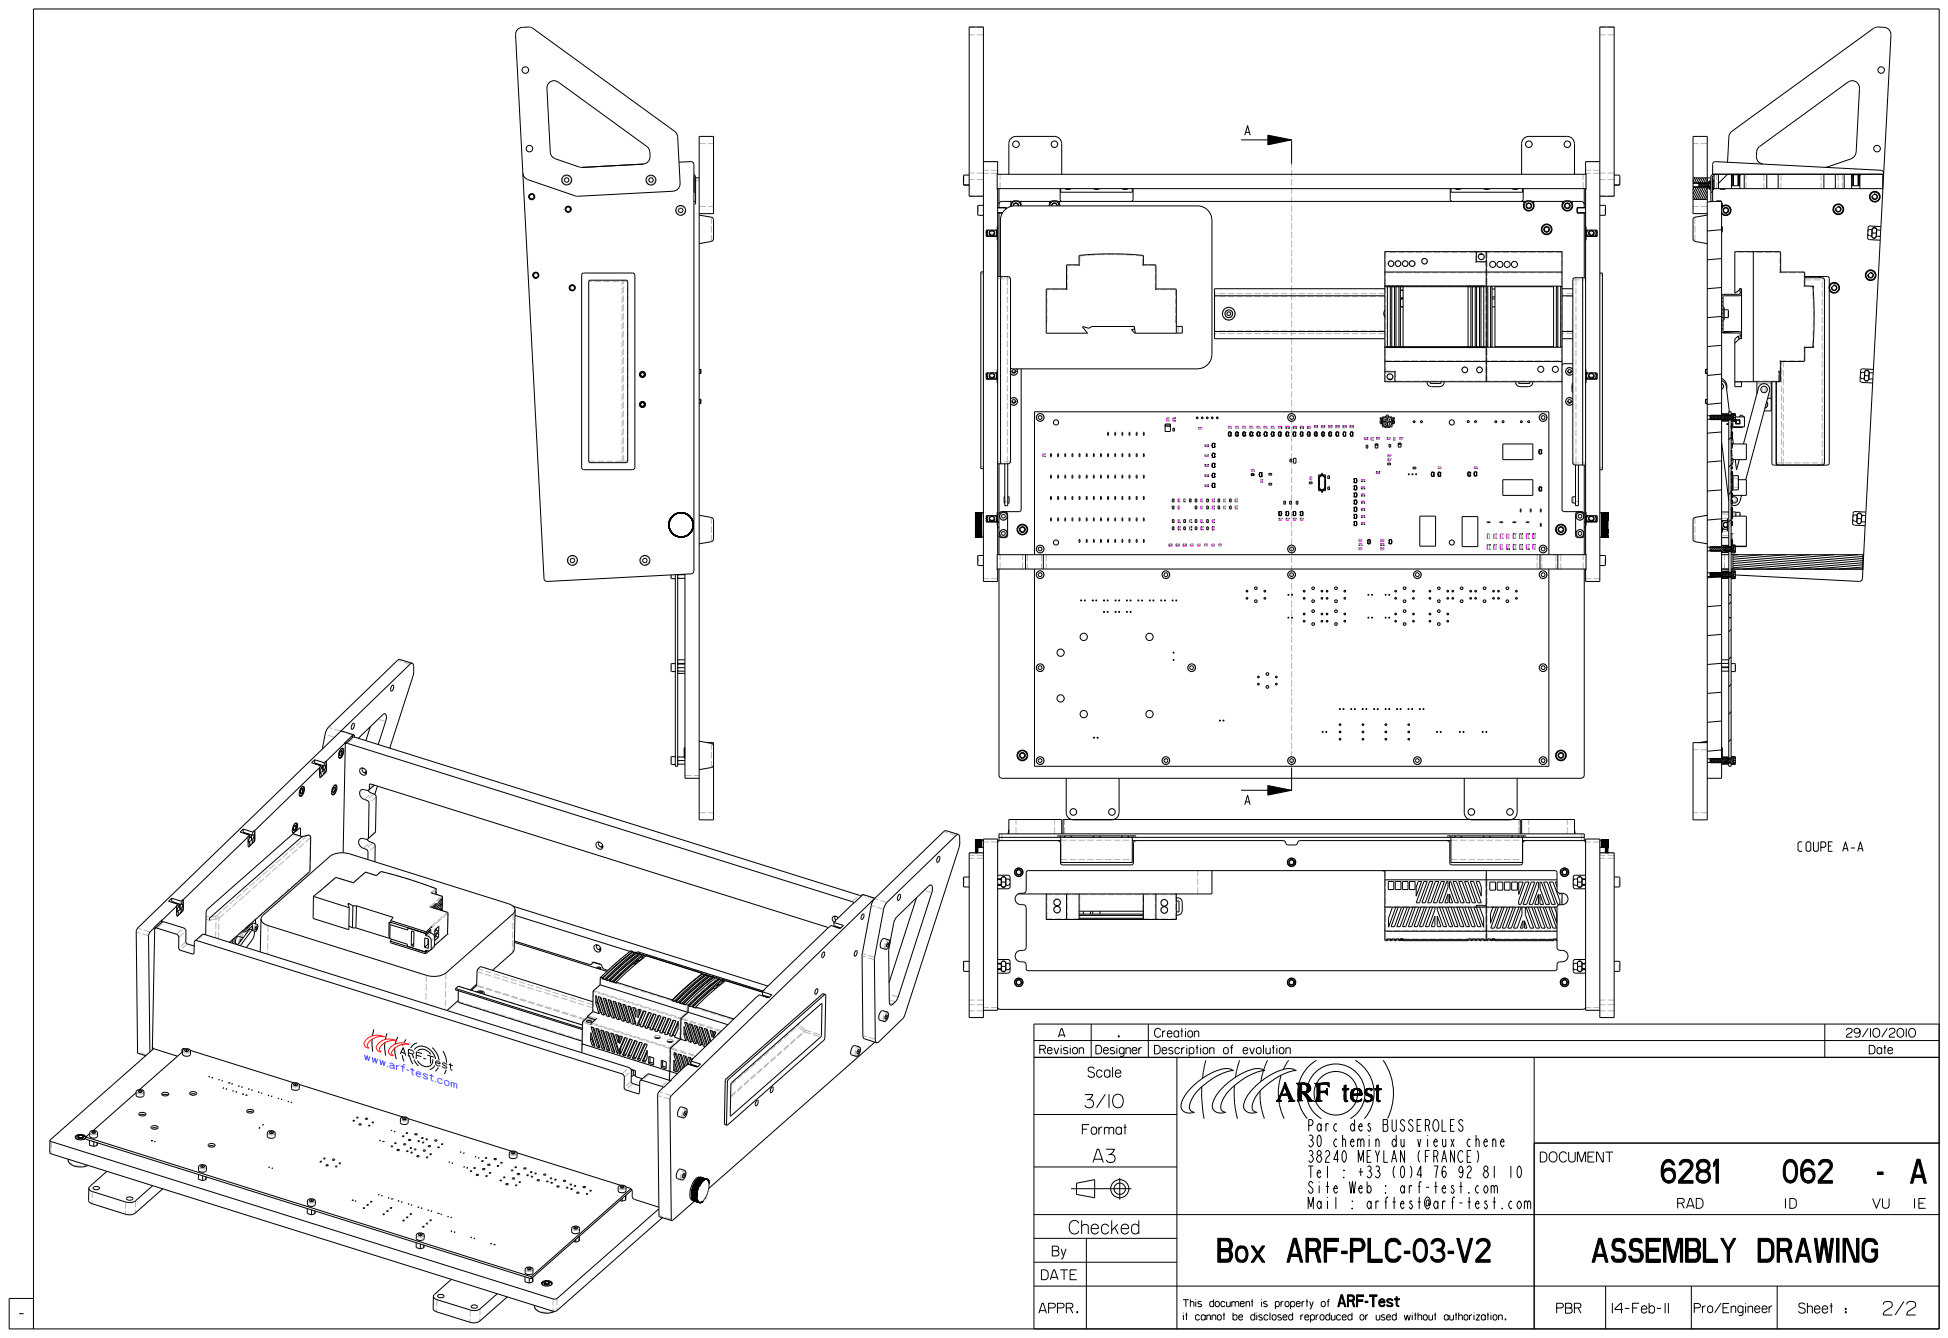
[picture p62: page 2]
