essensys-hub/essensys-test-banc-SC944D/mecanique-arf-test-6281/ASM's Affaire/6281_068 (Base Plate SC944).pdf

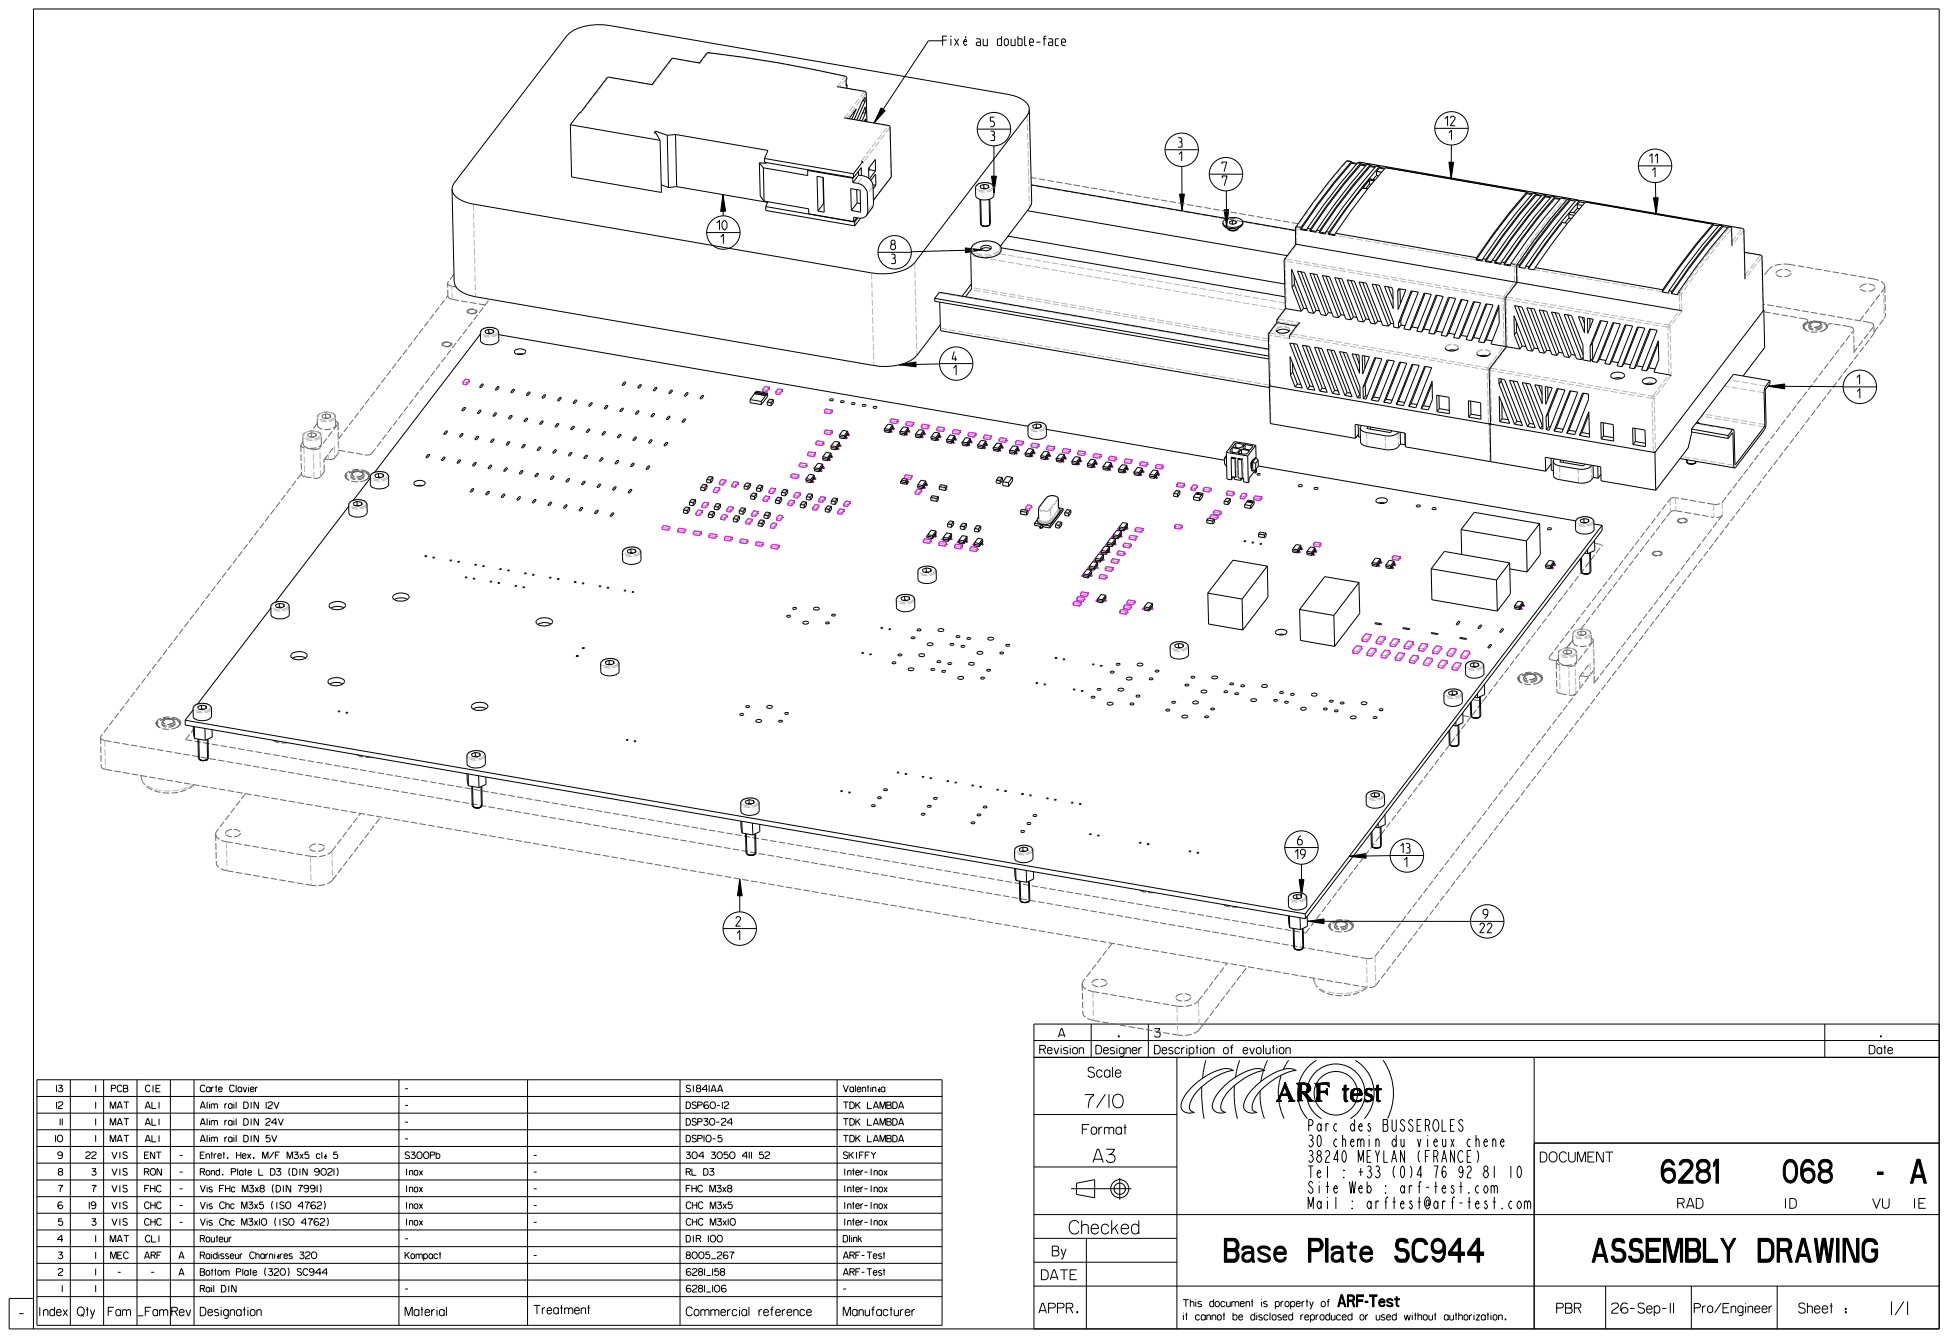
[picture p63: page 1]
