essensys-hub/essensys-test-banc-SC944D/mecanique-arf-test-6281/ASM's Affaire/6281_084 (Pusher plate SC944).pdf

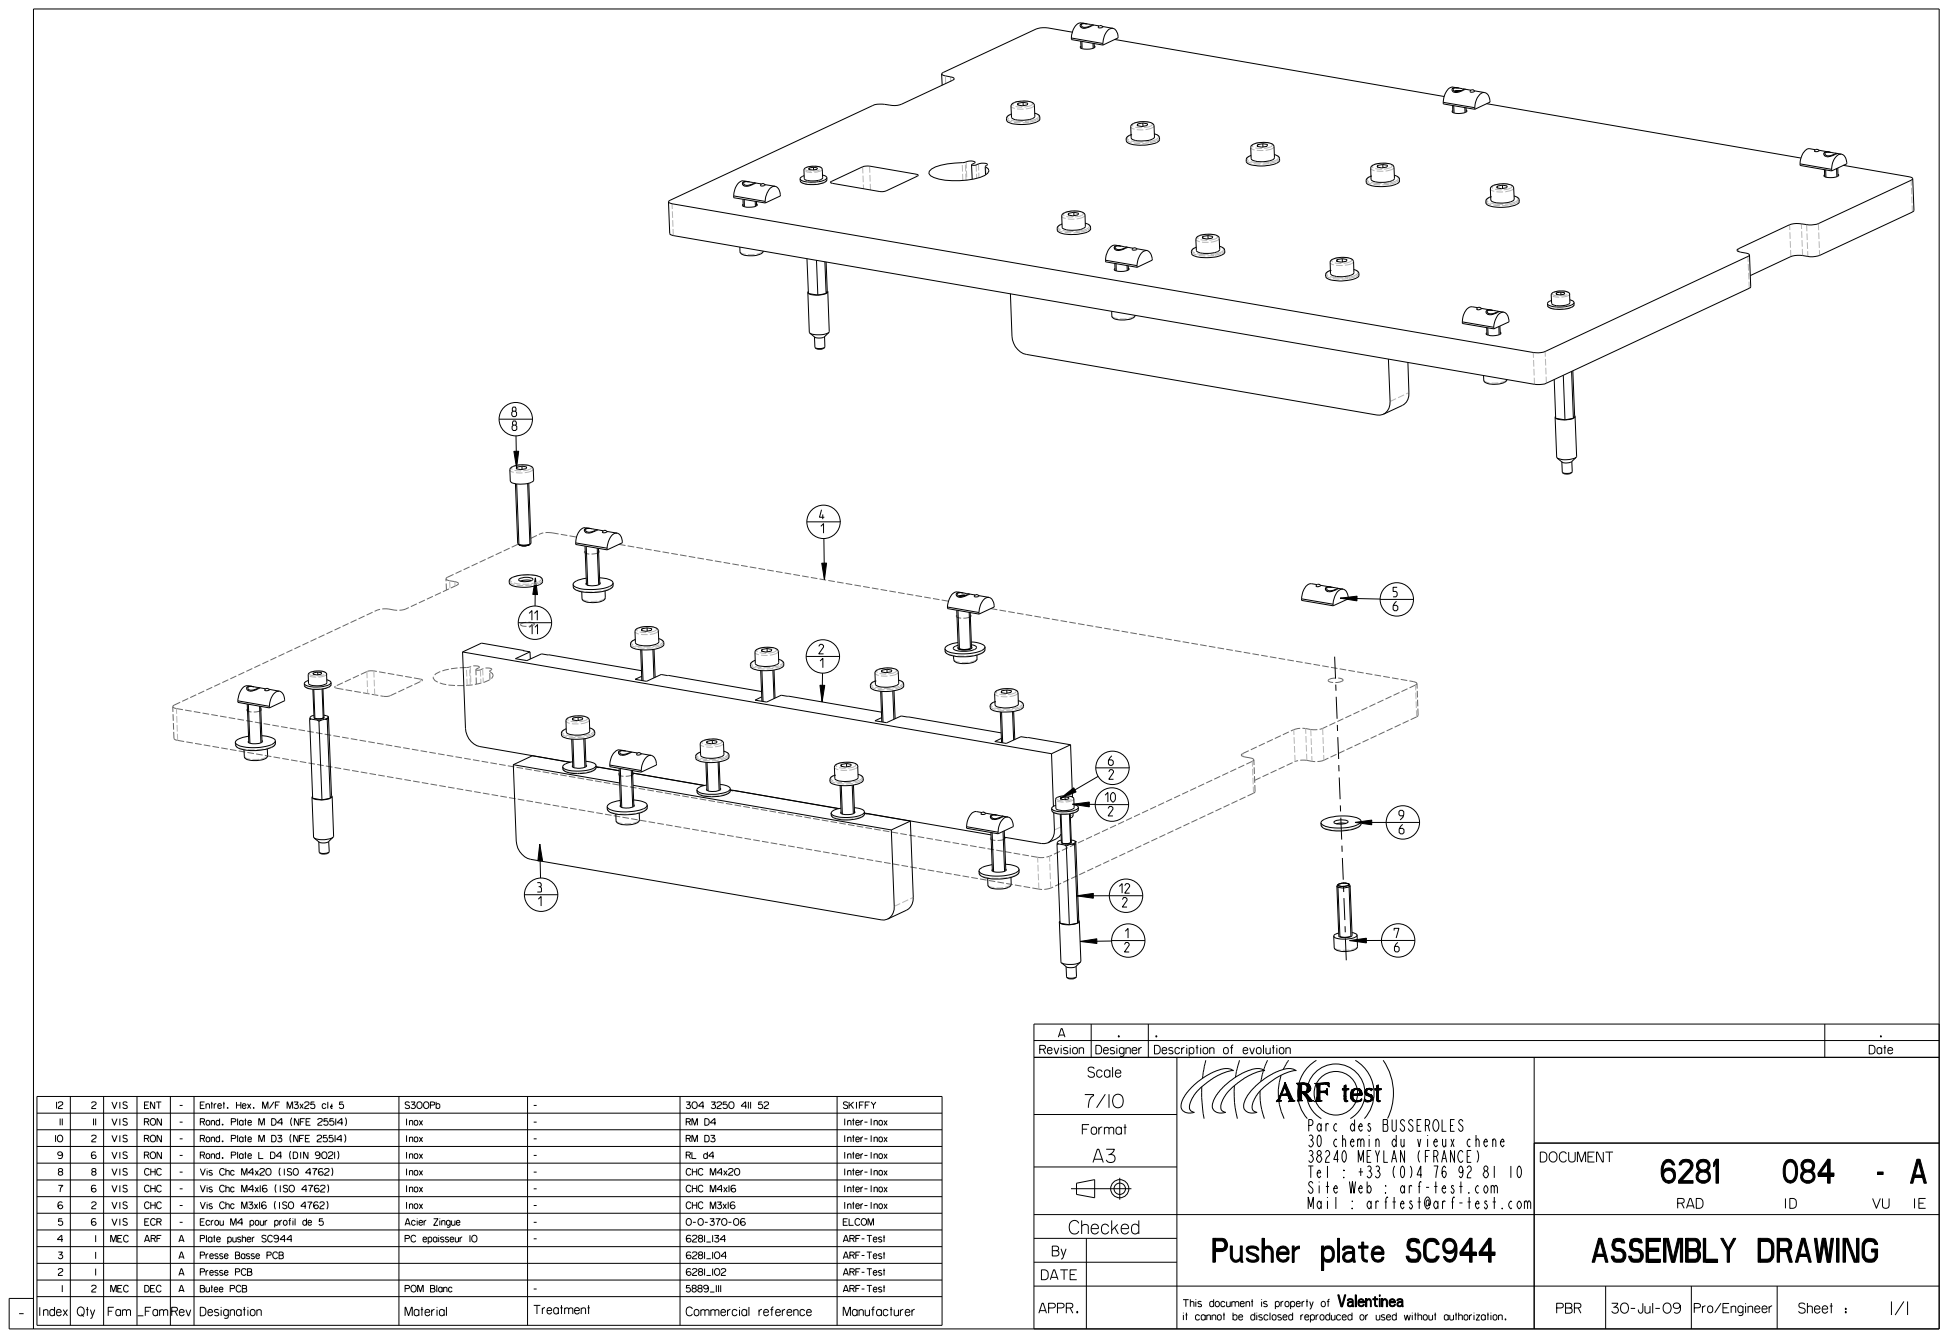
[picture p64: page 1]
