essensys-hub/essensys-test-banc-SC944D/mecanique-arf-test-6281/ASM's Affaire/6281_090 (Appli SC944).pdf

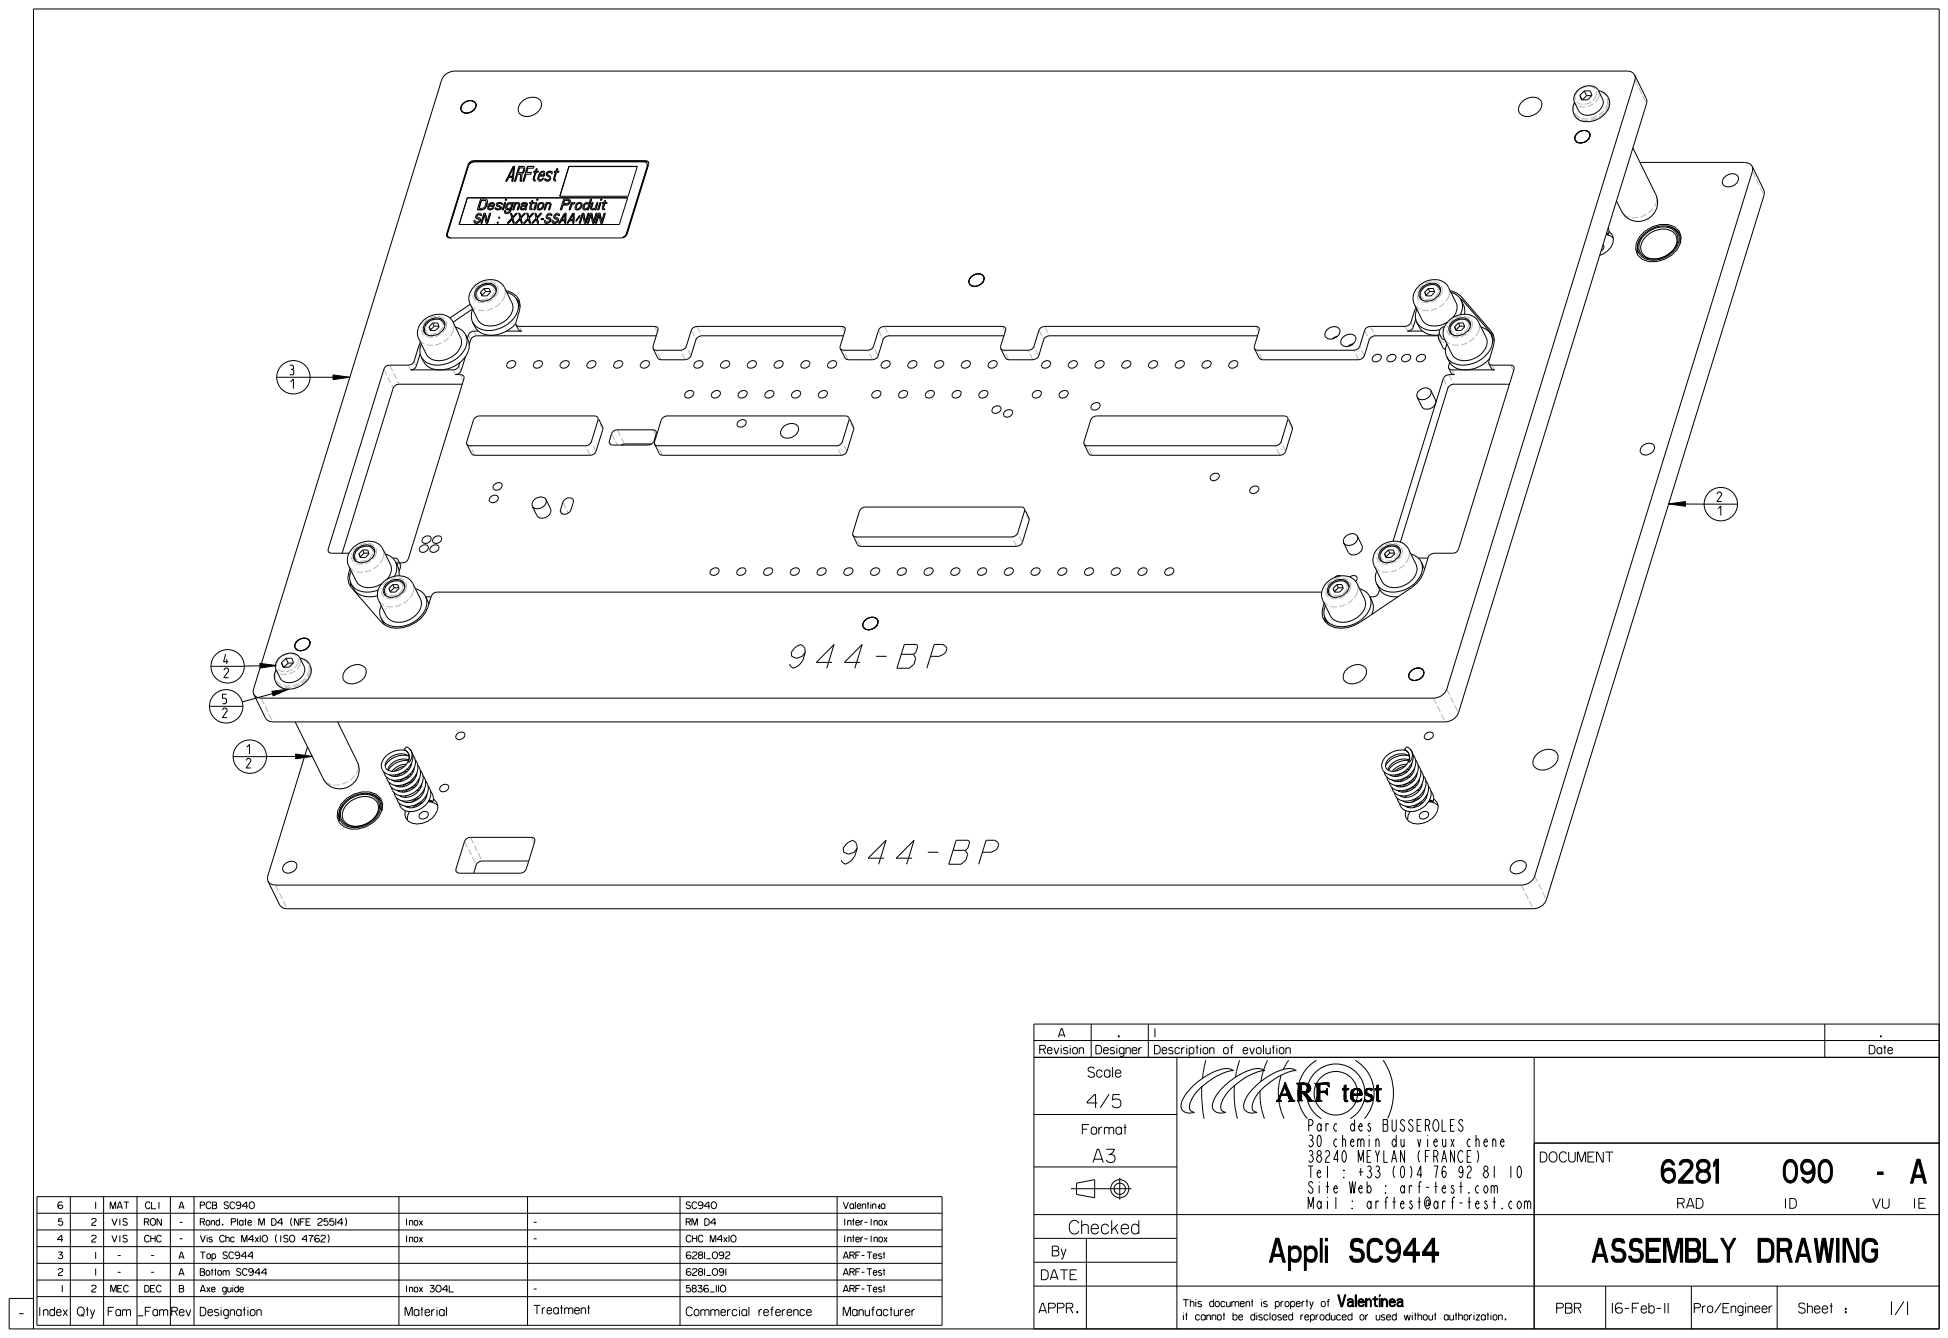
[picture p65: page 1]
