essensys-hub/essensys-test-banc-SC944D/mecanique-arf-test-6281/ASM's Affaire/6281_091 (Bottom SC944).pdf

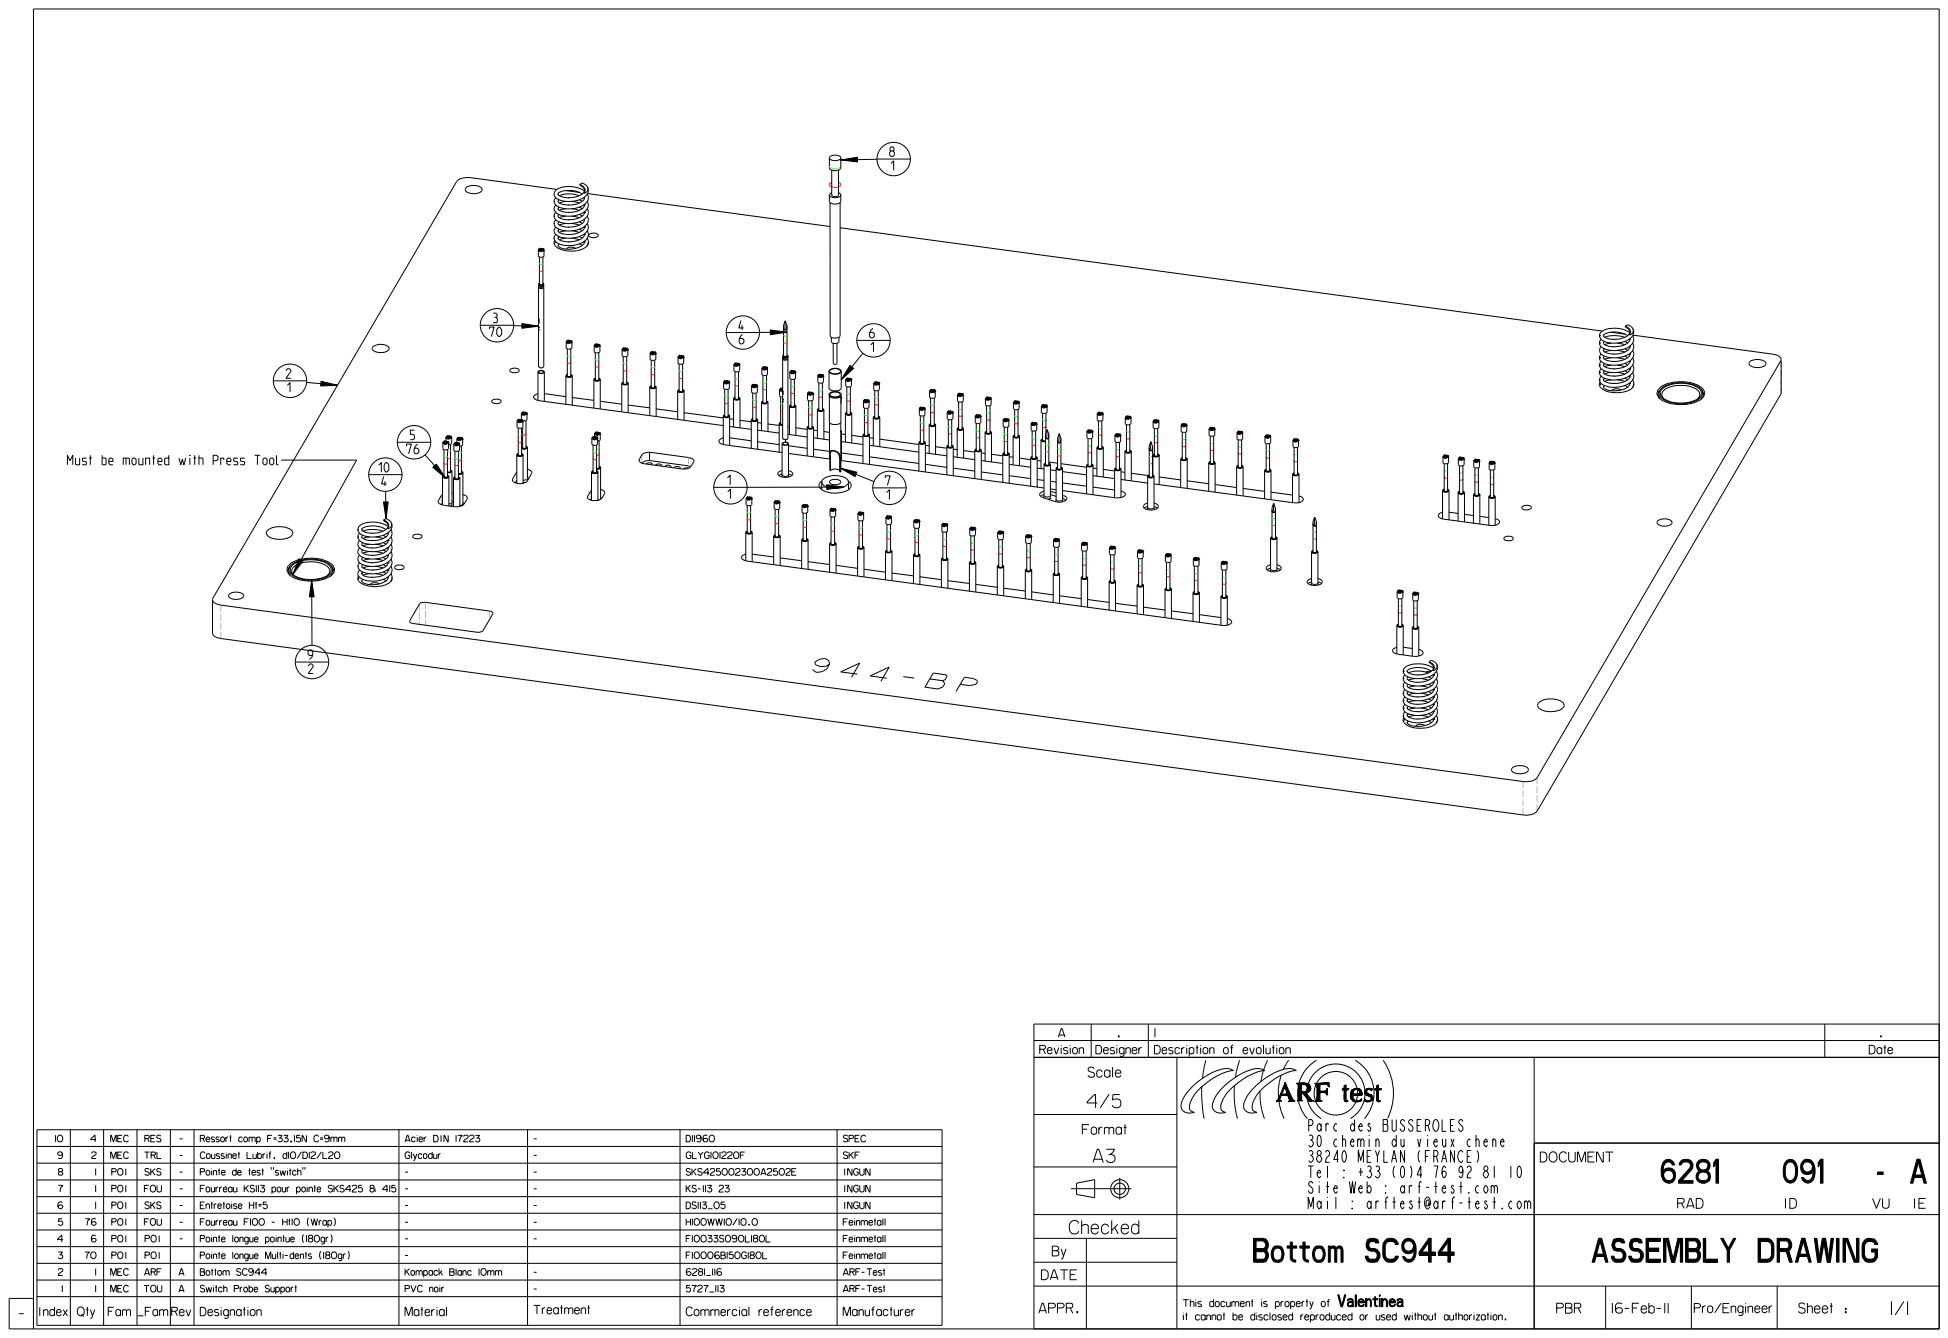
[picture p66: page 1]
