essensys-hub/essensys-test-banc-SC944D/mecanique-arf-test-6281/ASM's Affaire/6281_092 (Top SC944).pdf

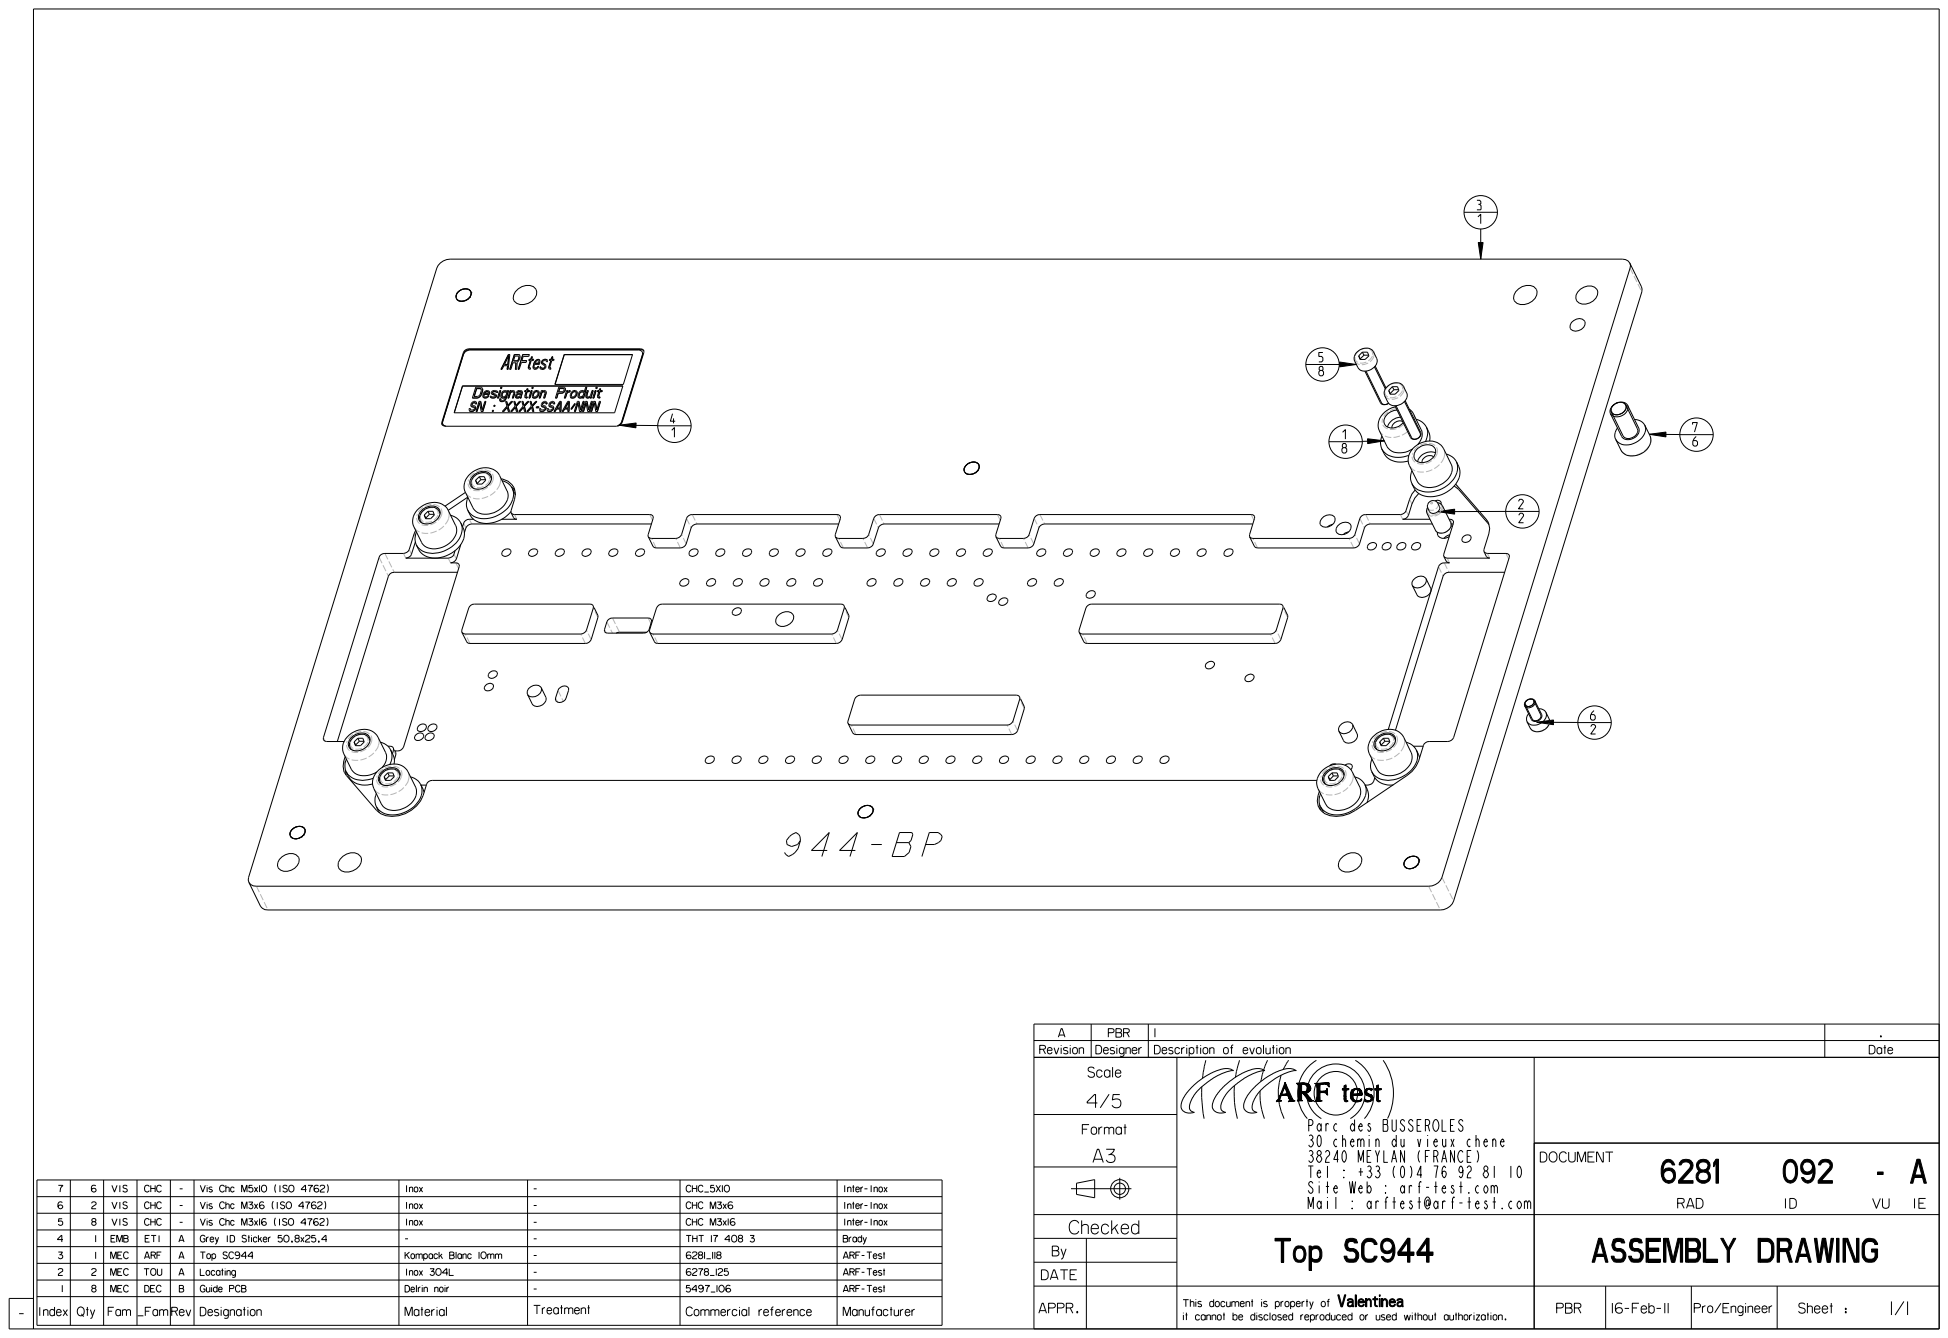
[picture p67: page 1]
