essensys-hub/essensys-test-banc-SC944D/mecanique-arf-test-6281/ASM's Affaire/6281_102 (Presse PCB).pdf

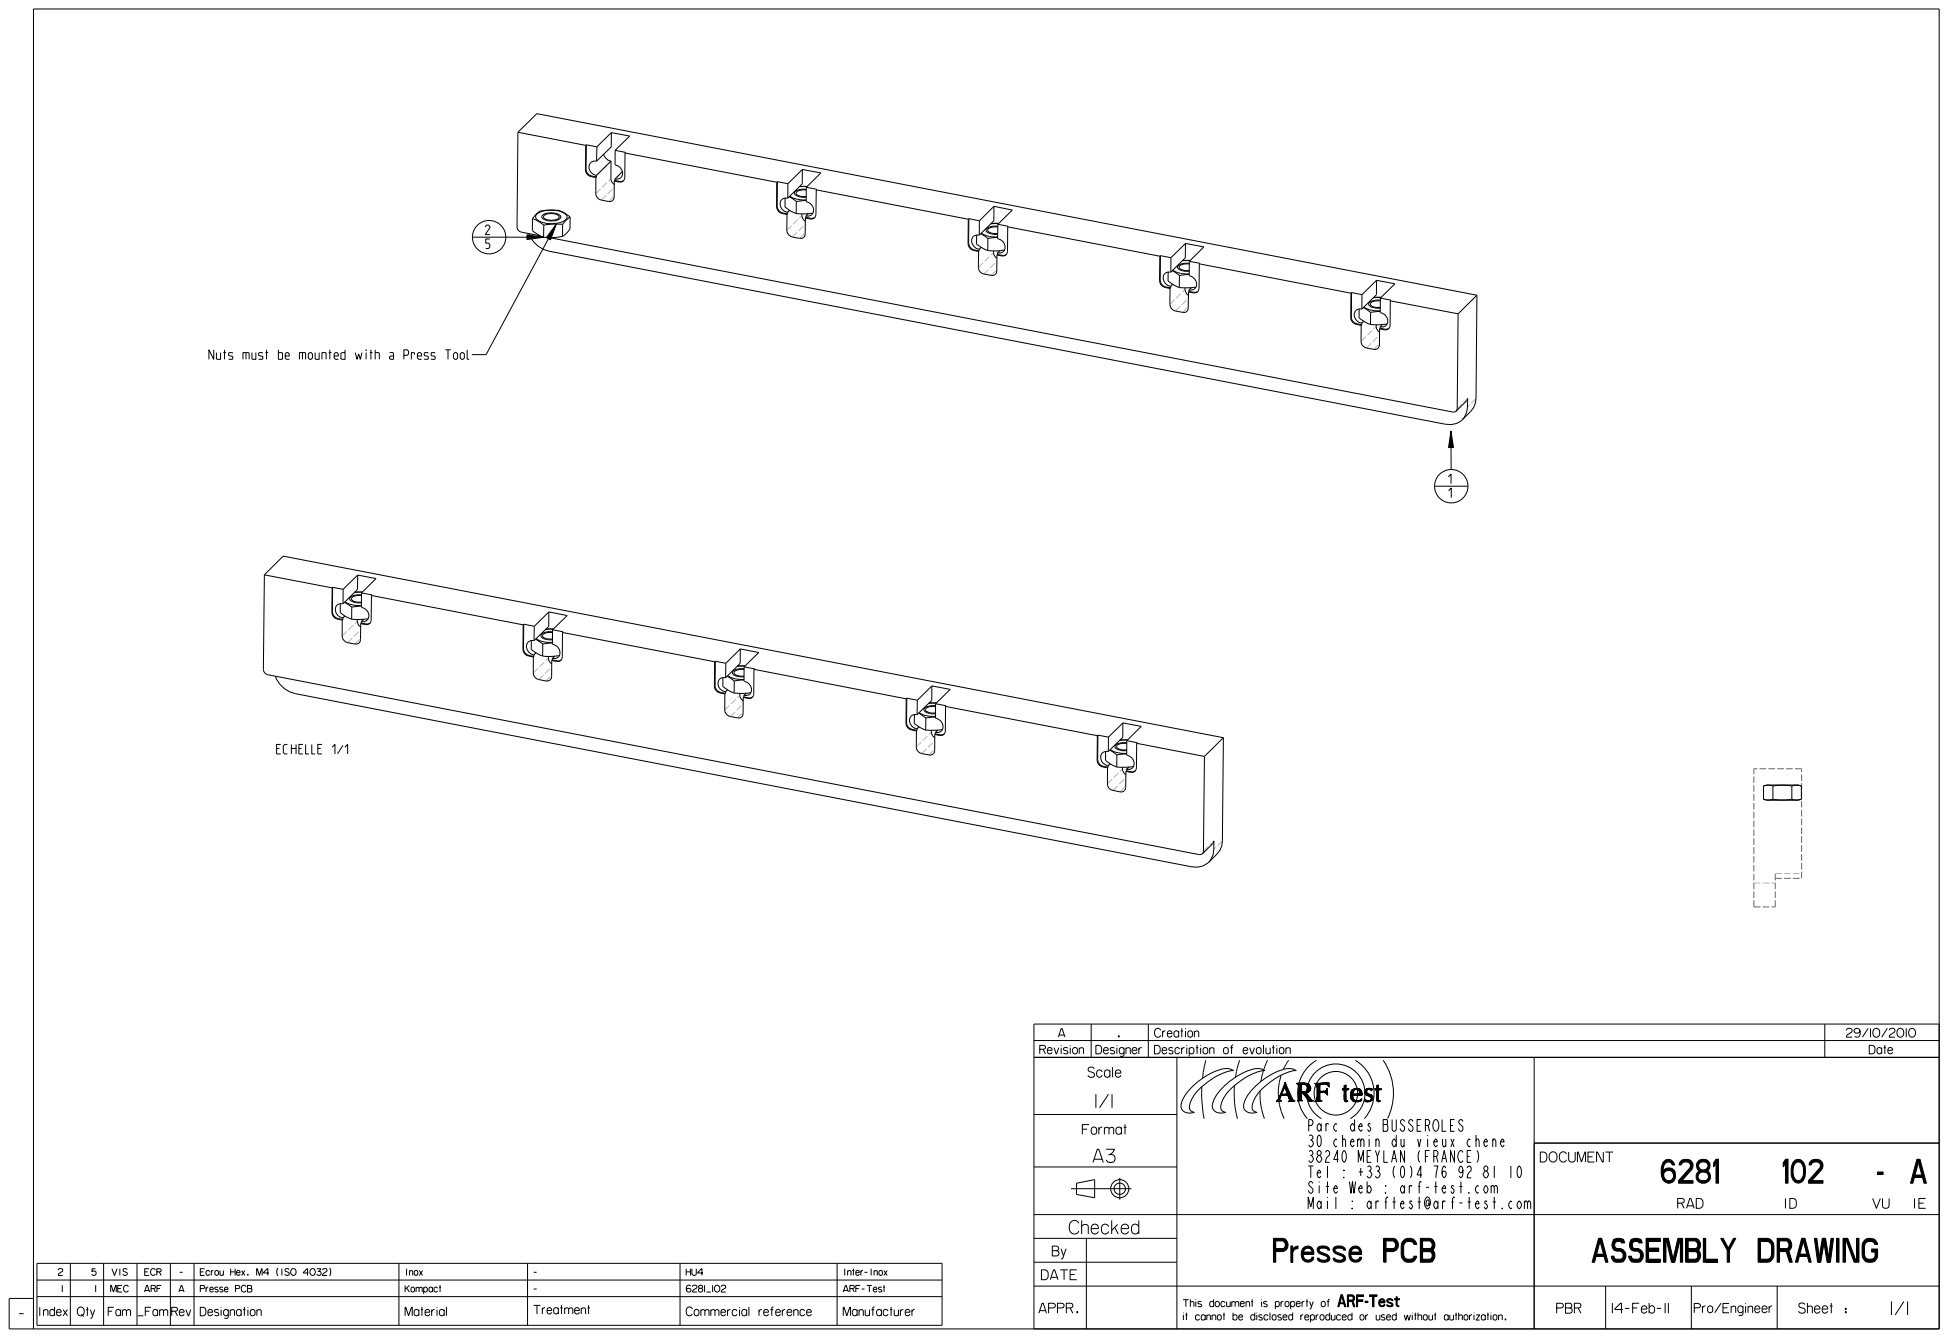
[picture p68: page 1]
