essensys-hub/essensys-test-banc-SC944D/mecanique-arf-test-6281/ASM's Affaire/6281_104 (Presse Basse PCB).pdf

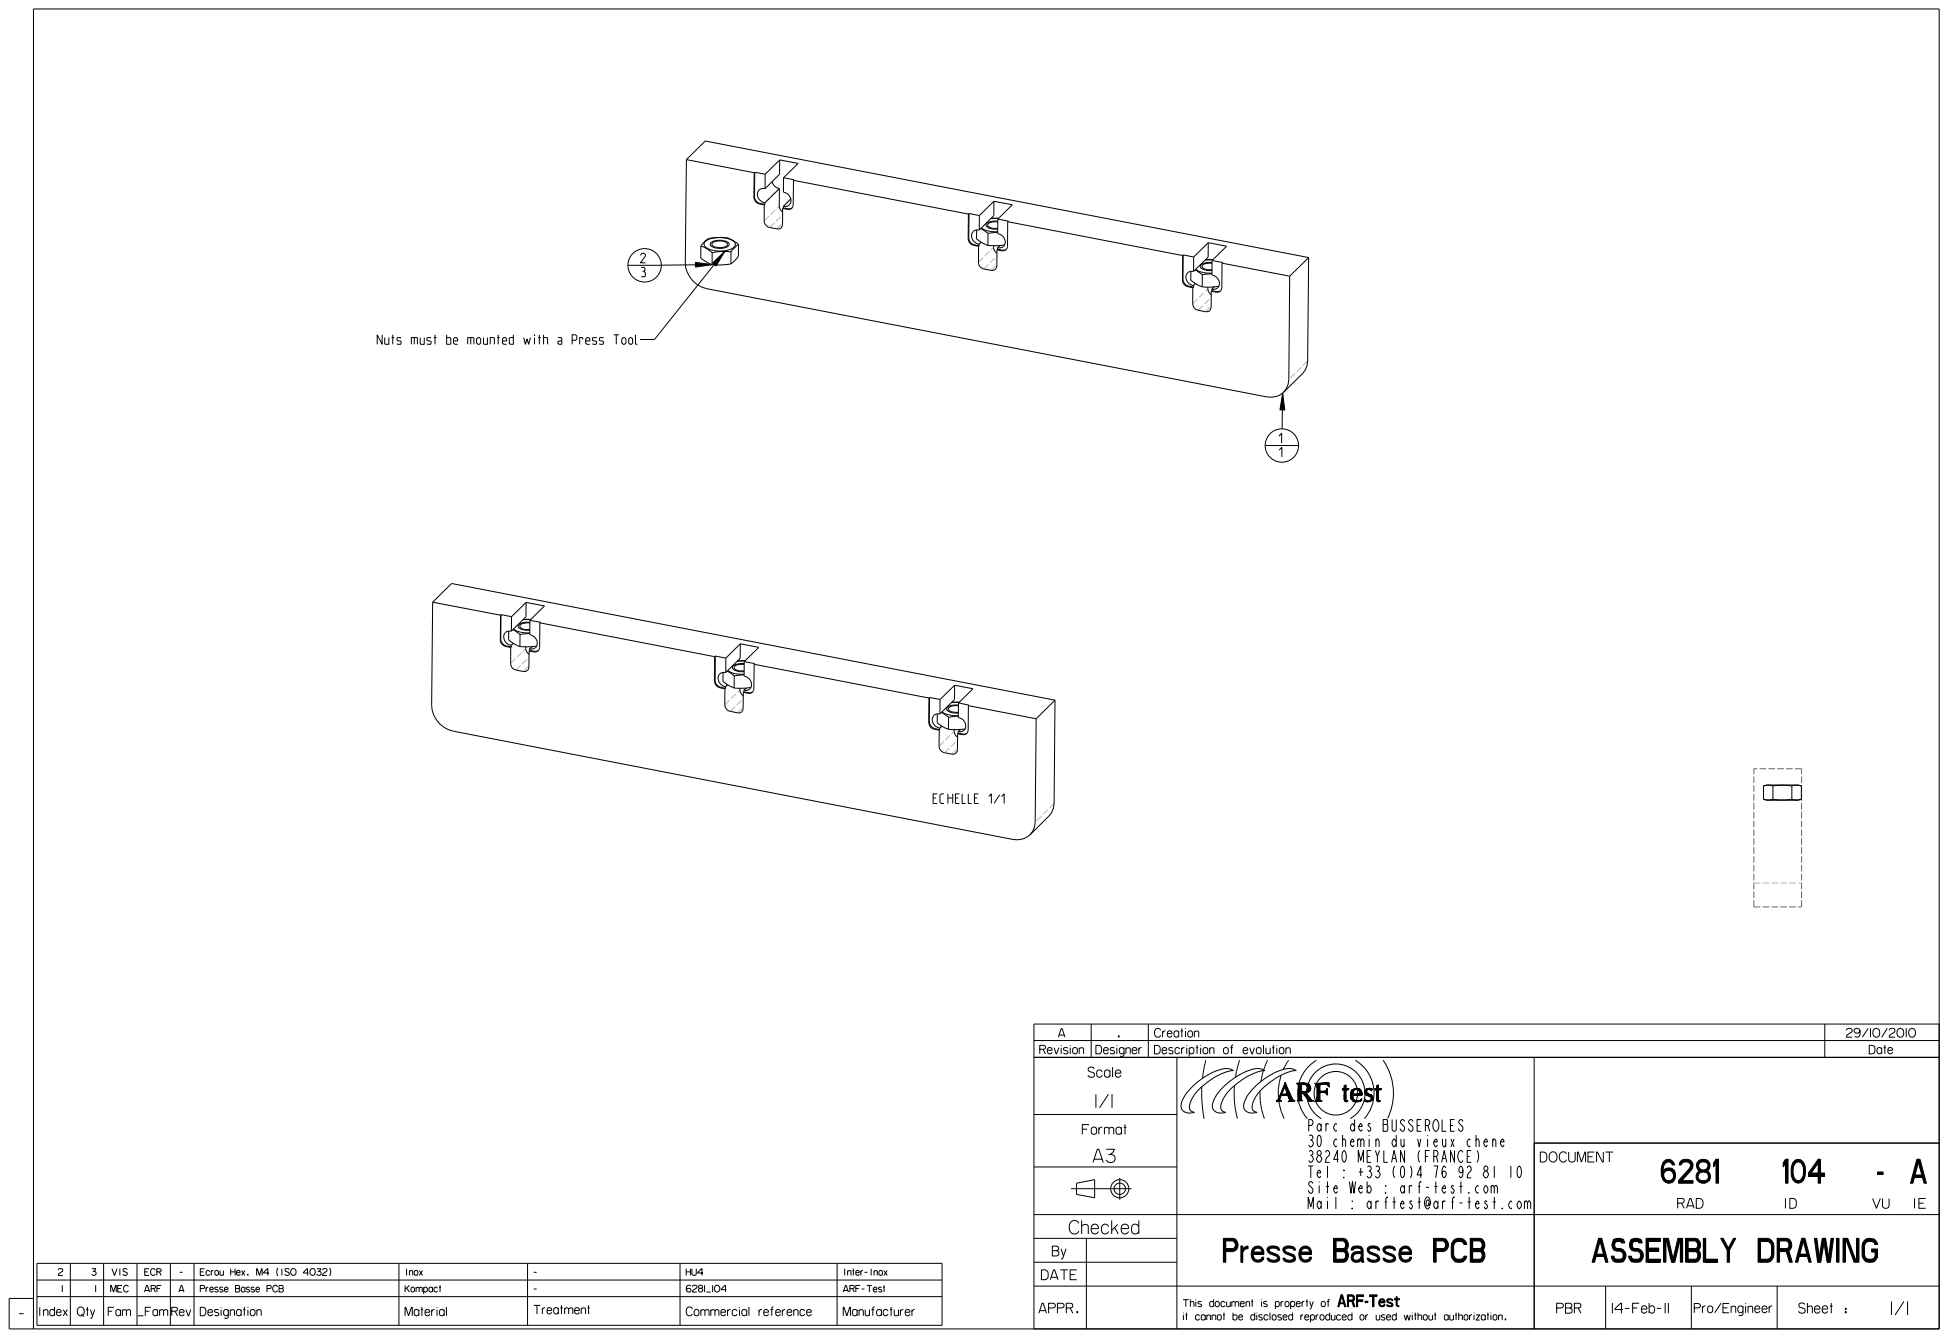
[picture p69: page 1]
