essensys-hub/essensys-test-banc-SC944D/mecanique-arf-test-6281/ASM's Affaire/6281_111 (Right Panel - V2).pdf

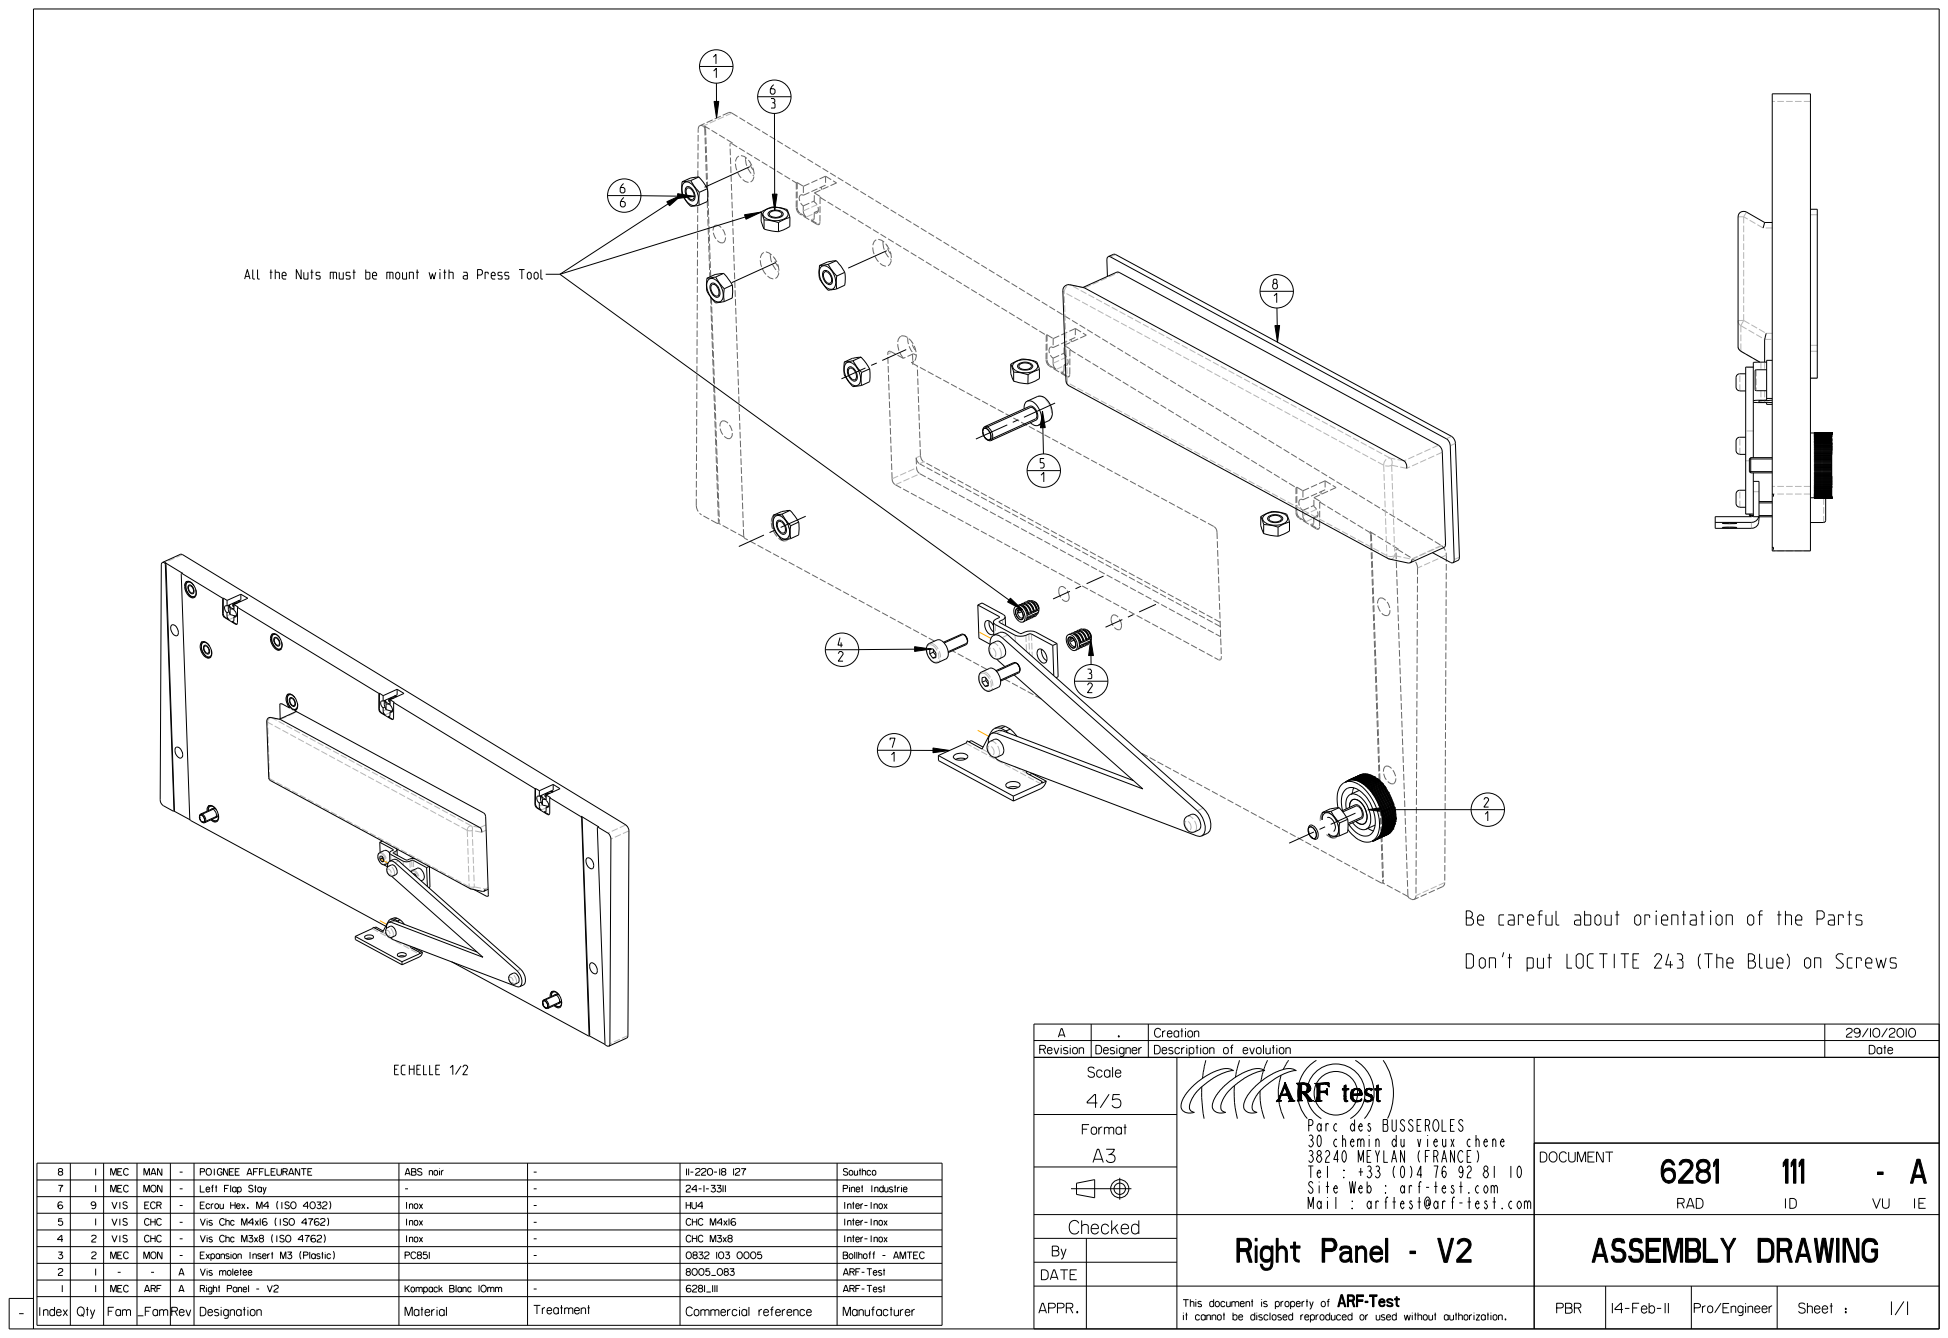
[picture p70: page 1]
