essensys-hub/essensys-test-banc-SC944D/mecanique-arf-test-6281/ASM's Affaire/6281_117 (Left Panel - V2).pdf

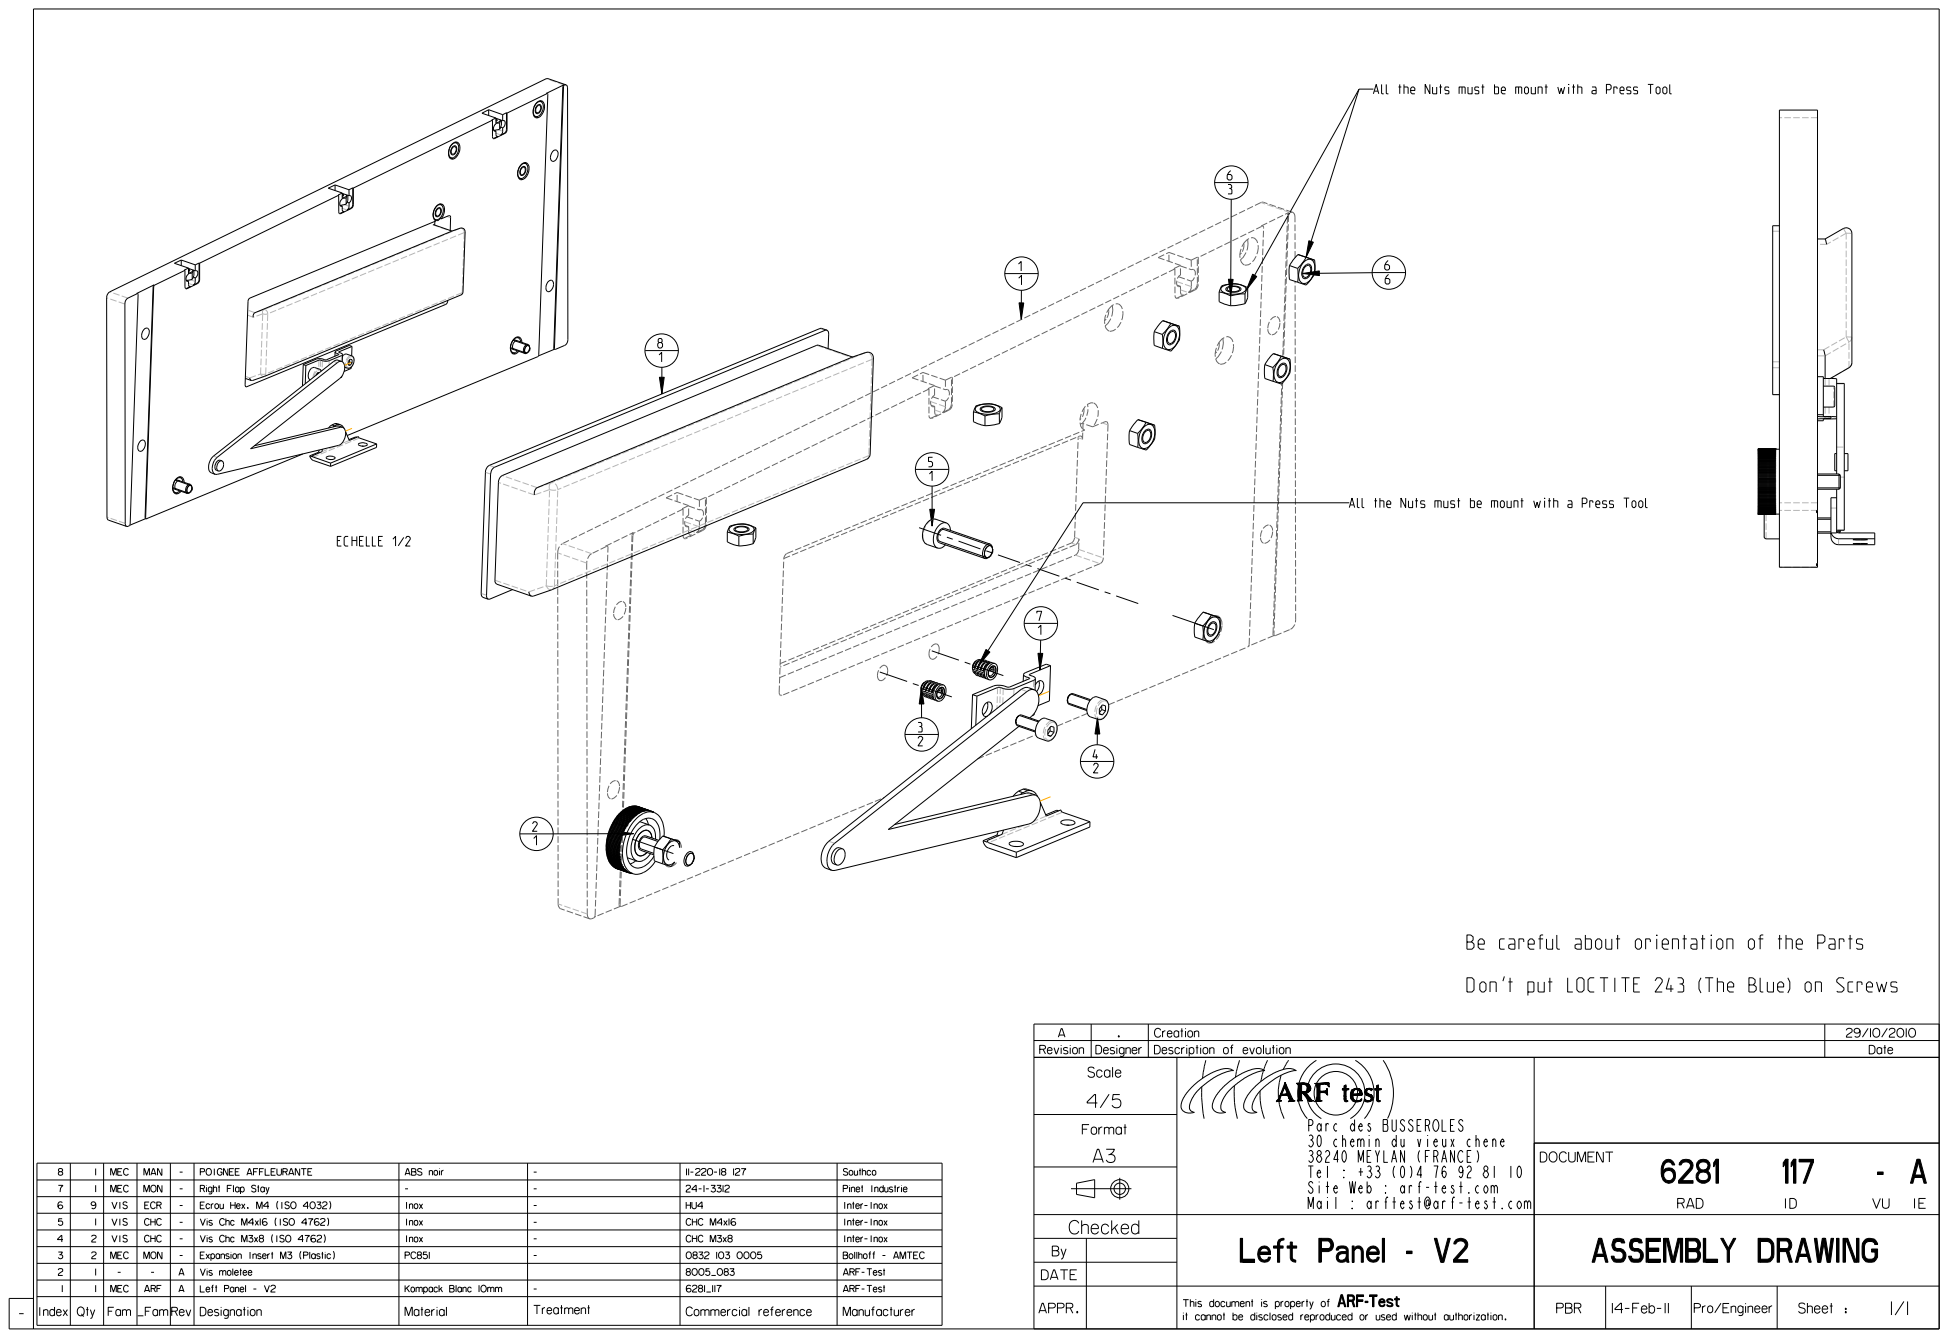
[picture p71: page 1]
