essensys-hub/essensys-test-banc-SC944D/mecanique-arf-test-6281/ASM's Affaire/6281_158 (Bottom Plate (320) SC944).pdf

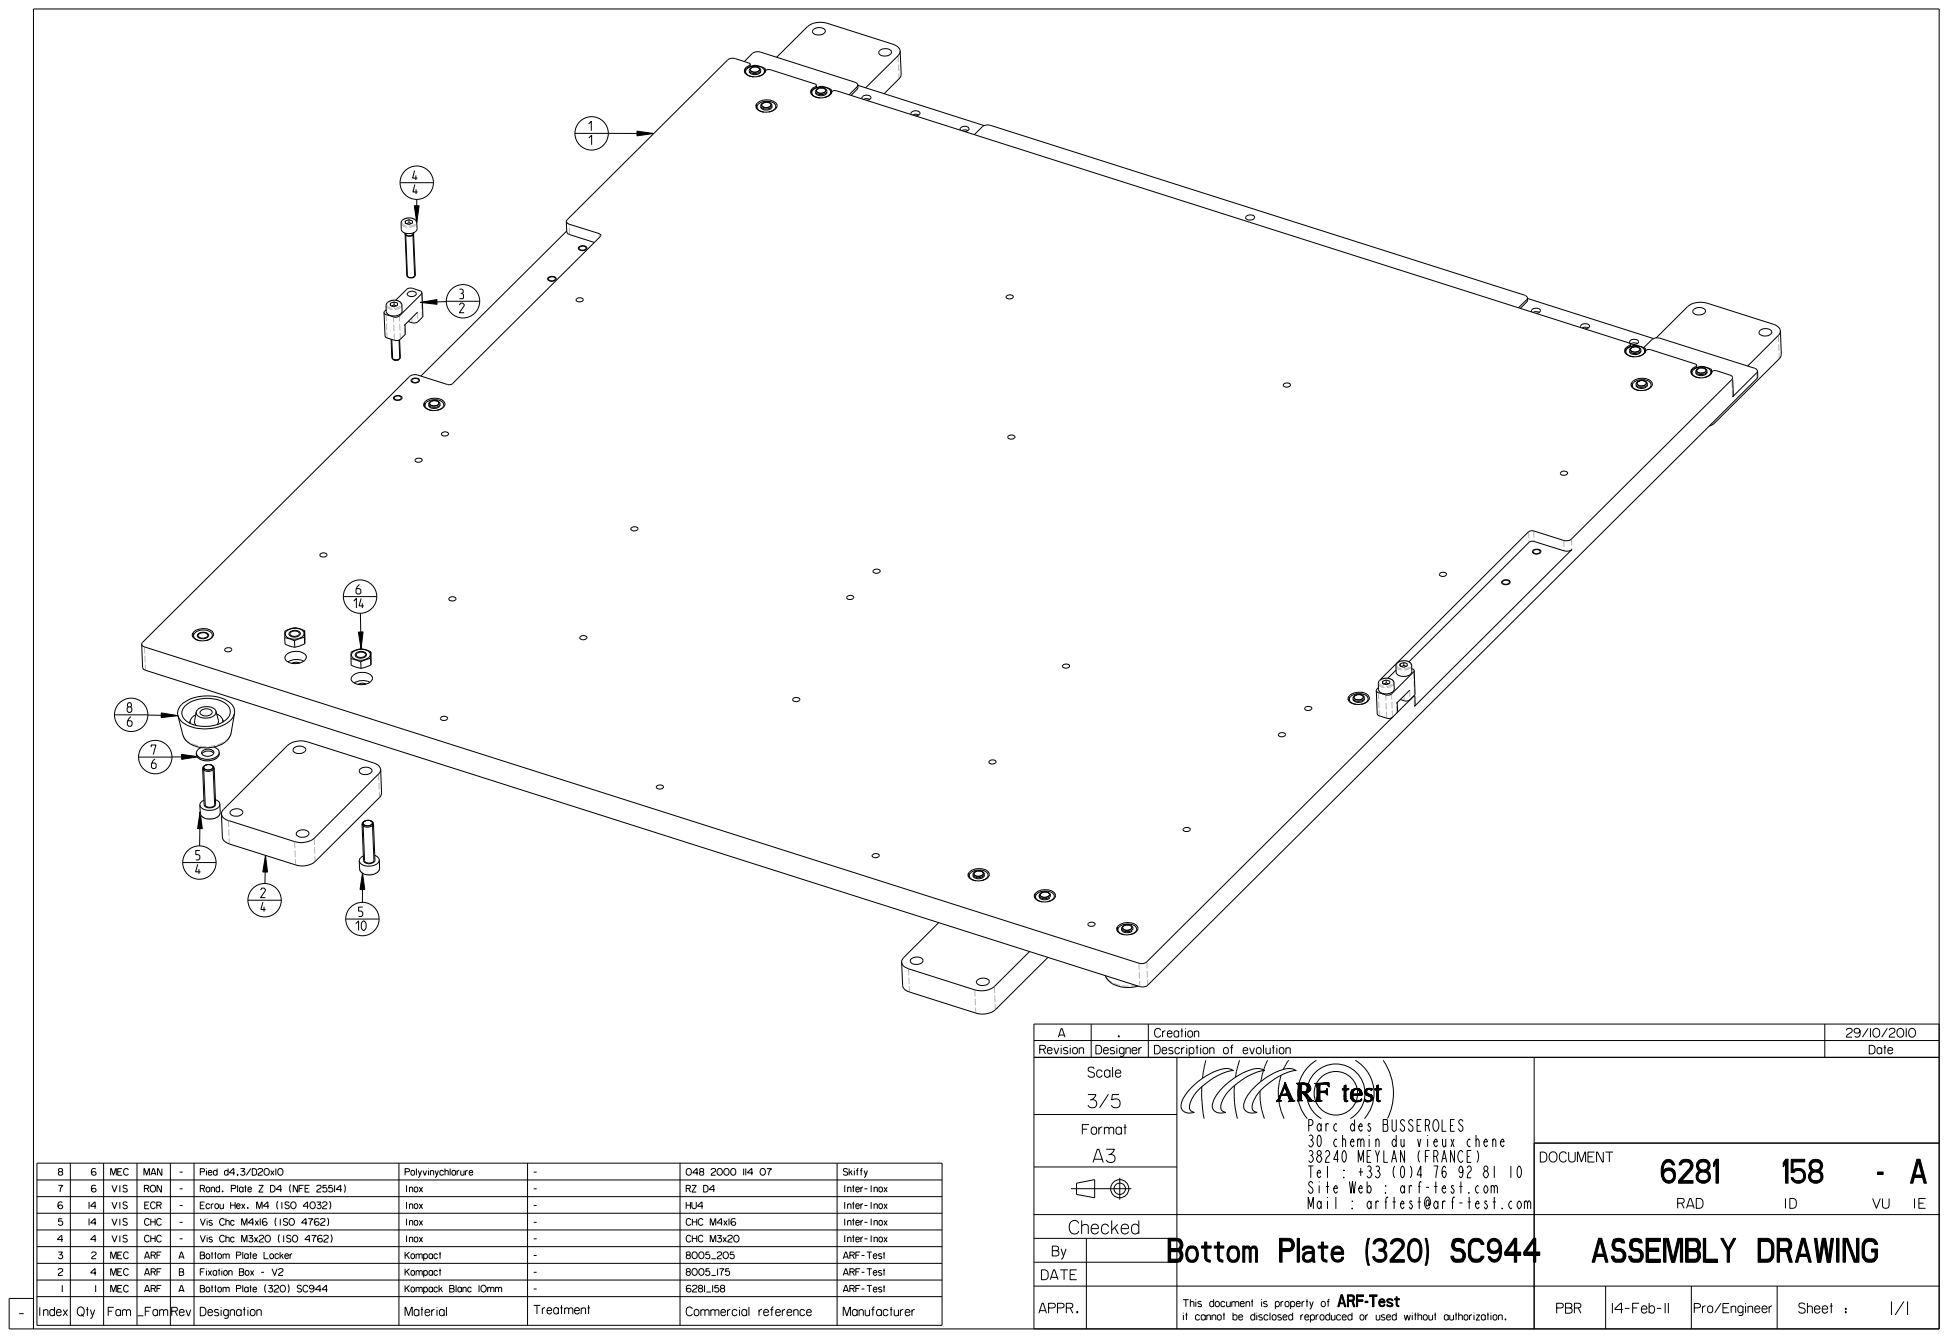
[picture p72: page 1]
