essensys-hub/essensys-test-banc-SC944D/mecanique-arf-test-6281/ASM's Commun/6278_058 (Std Presser - 320 V2).pdf

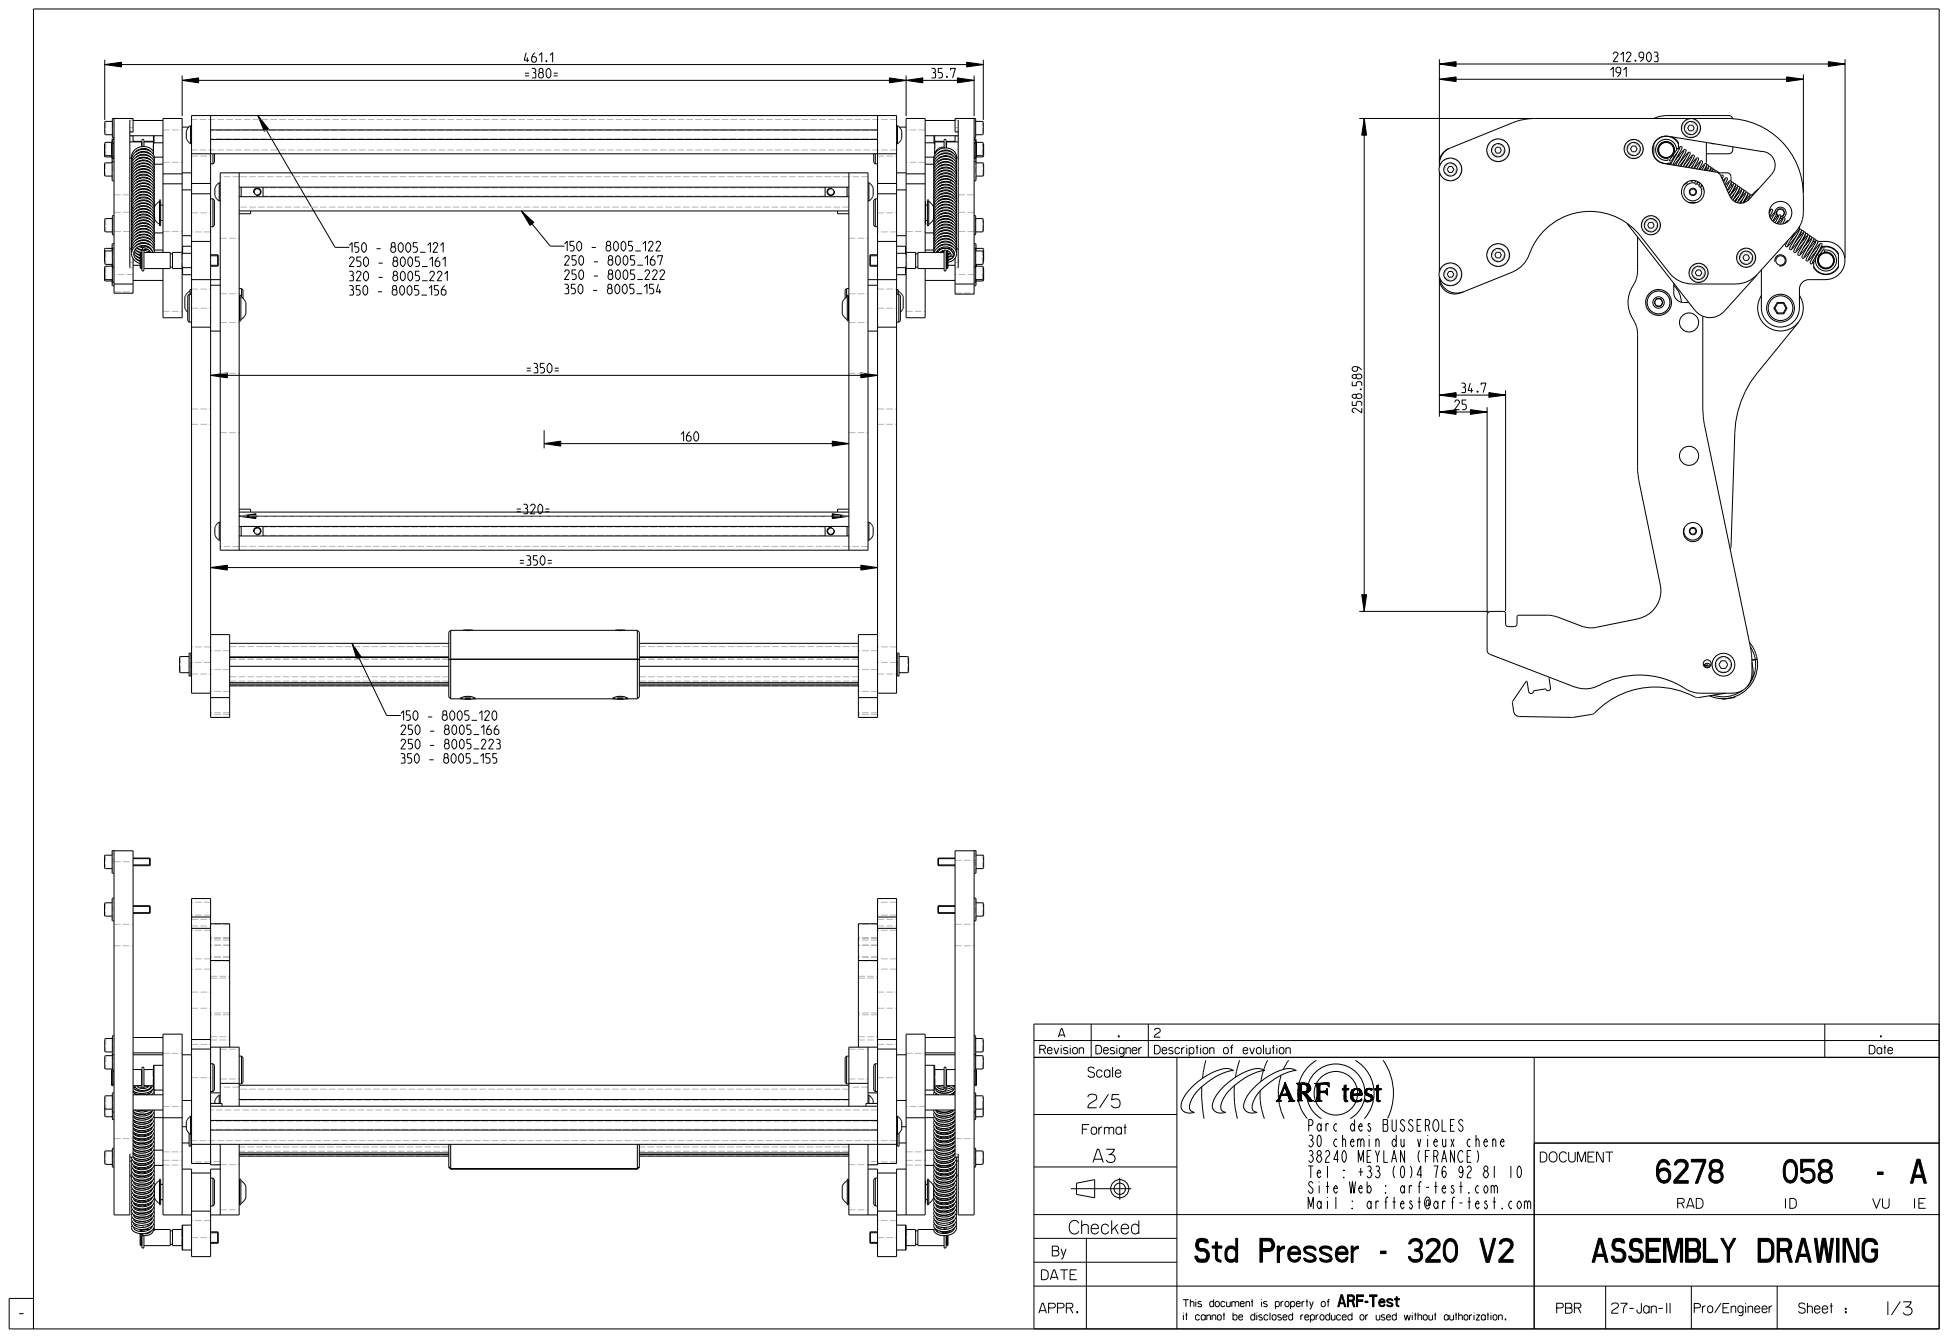
[picture p73: page 1]

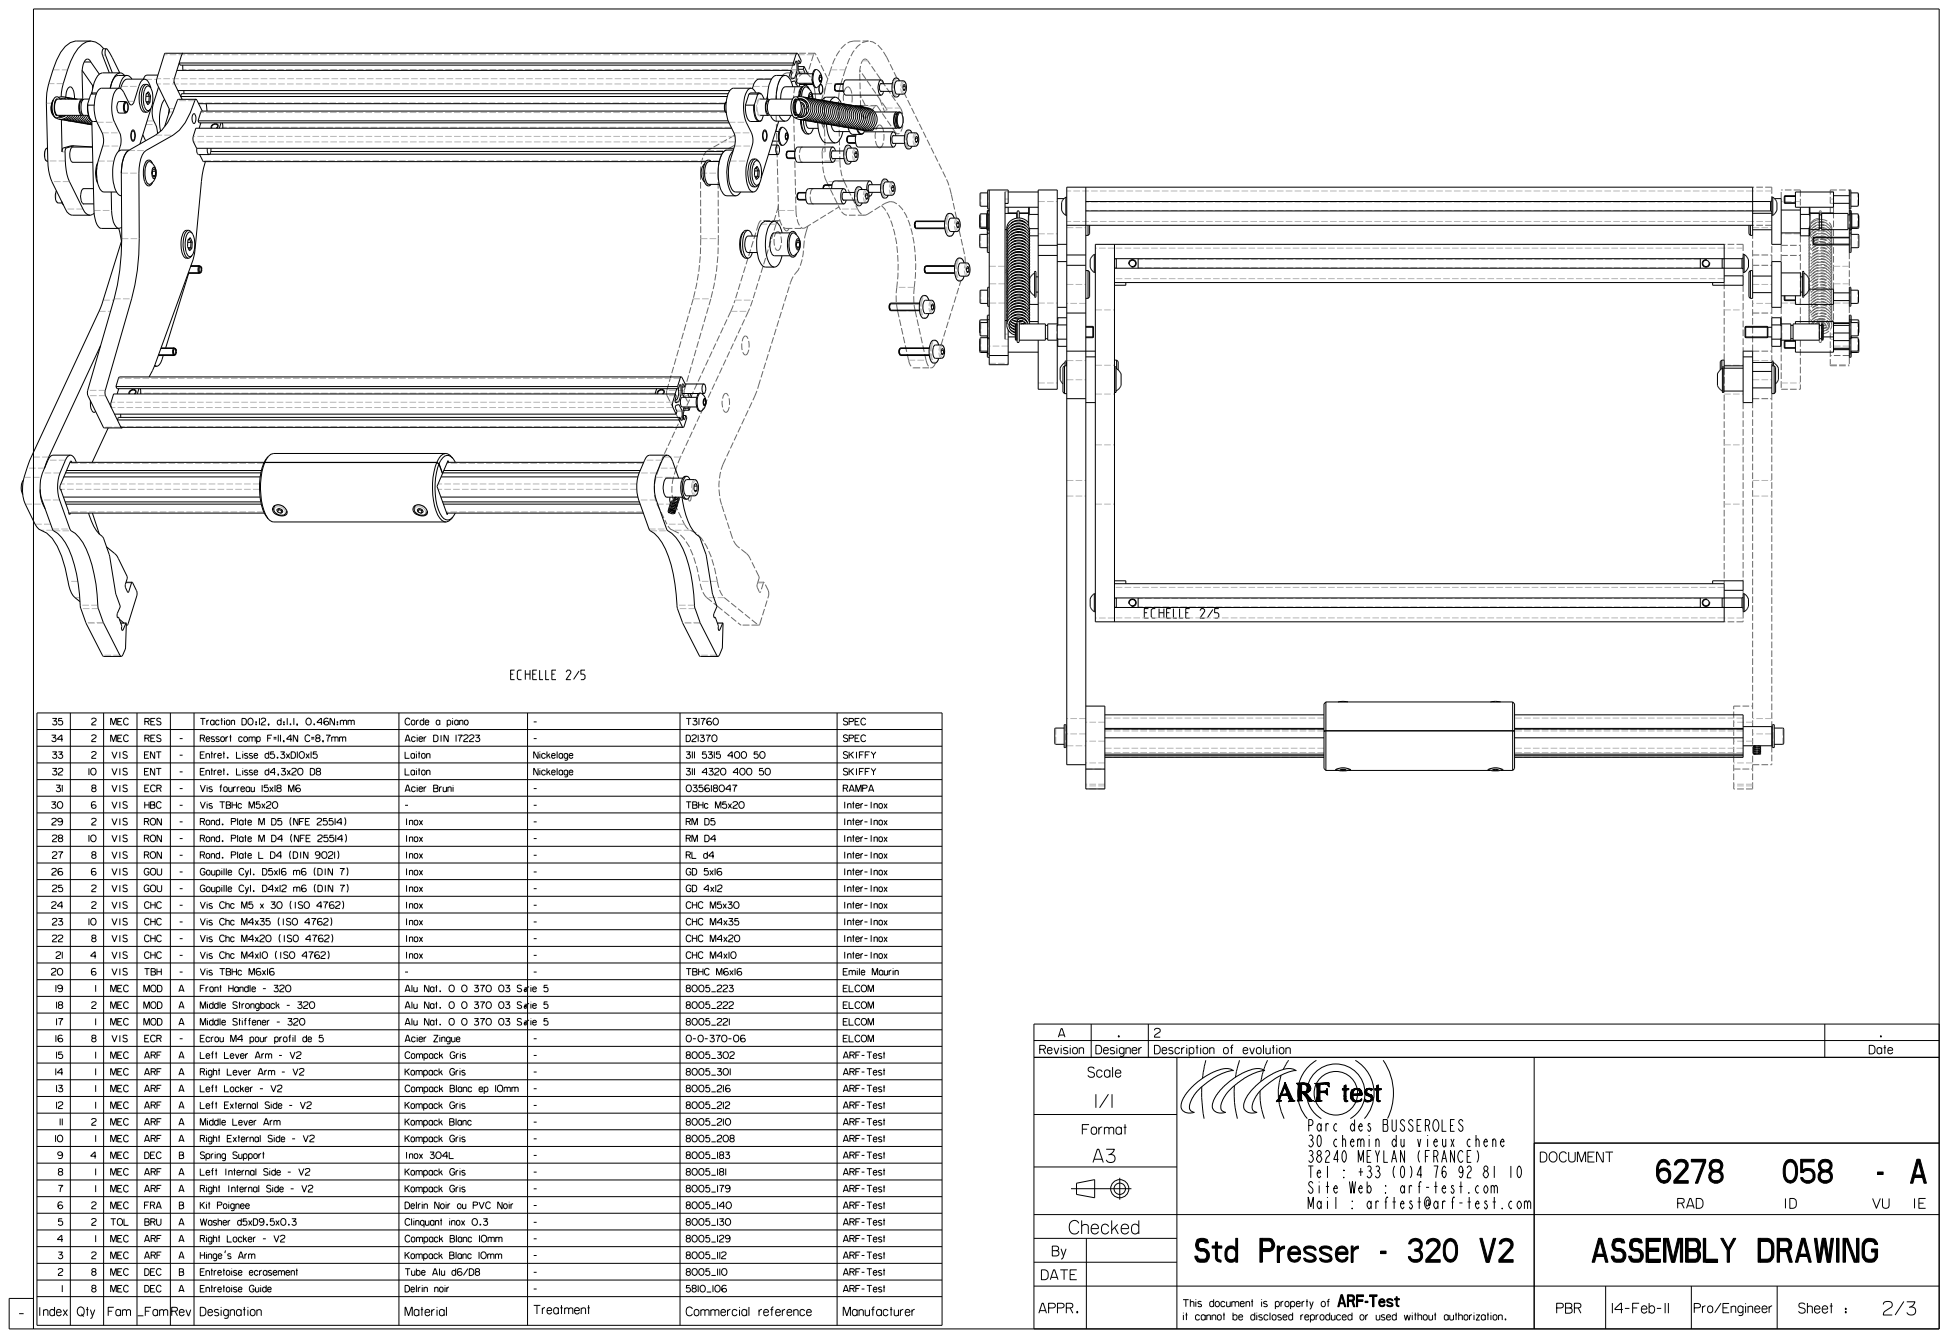
[picture p74: page 2]

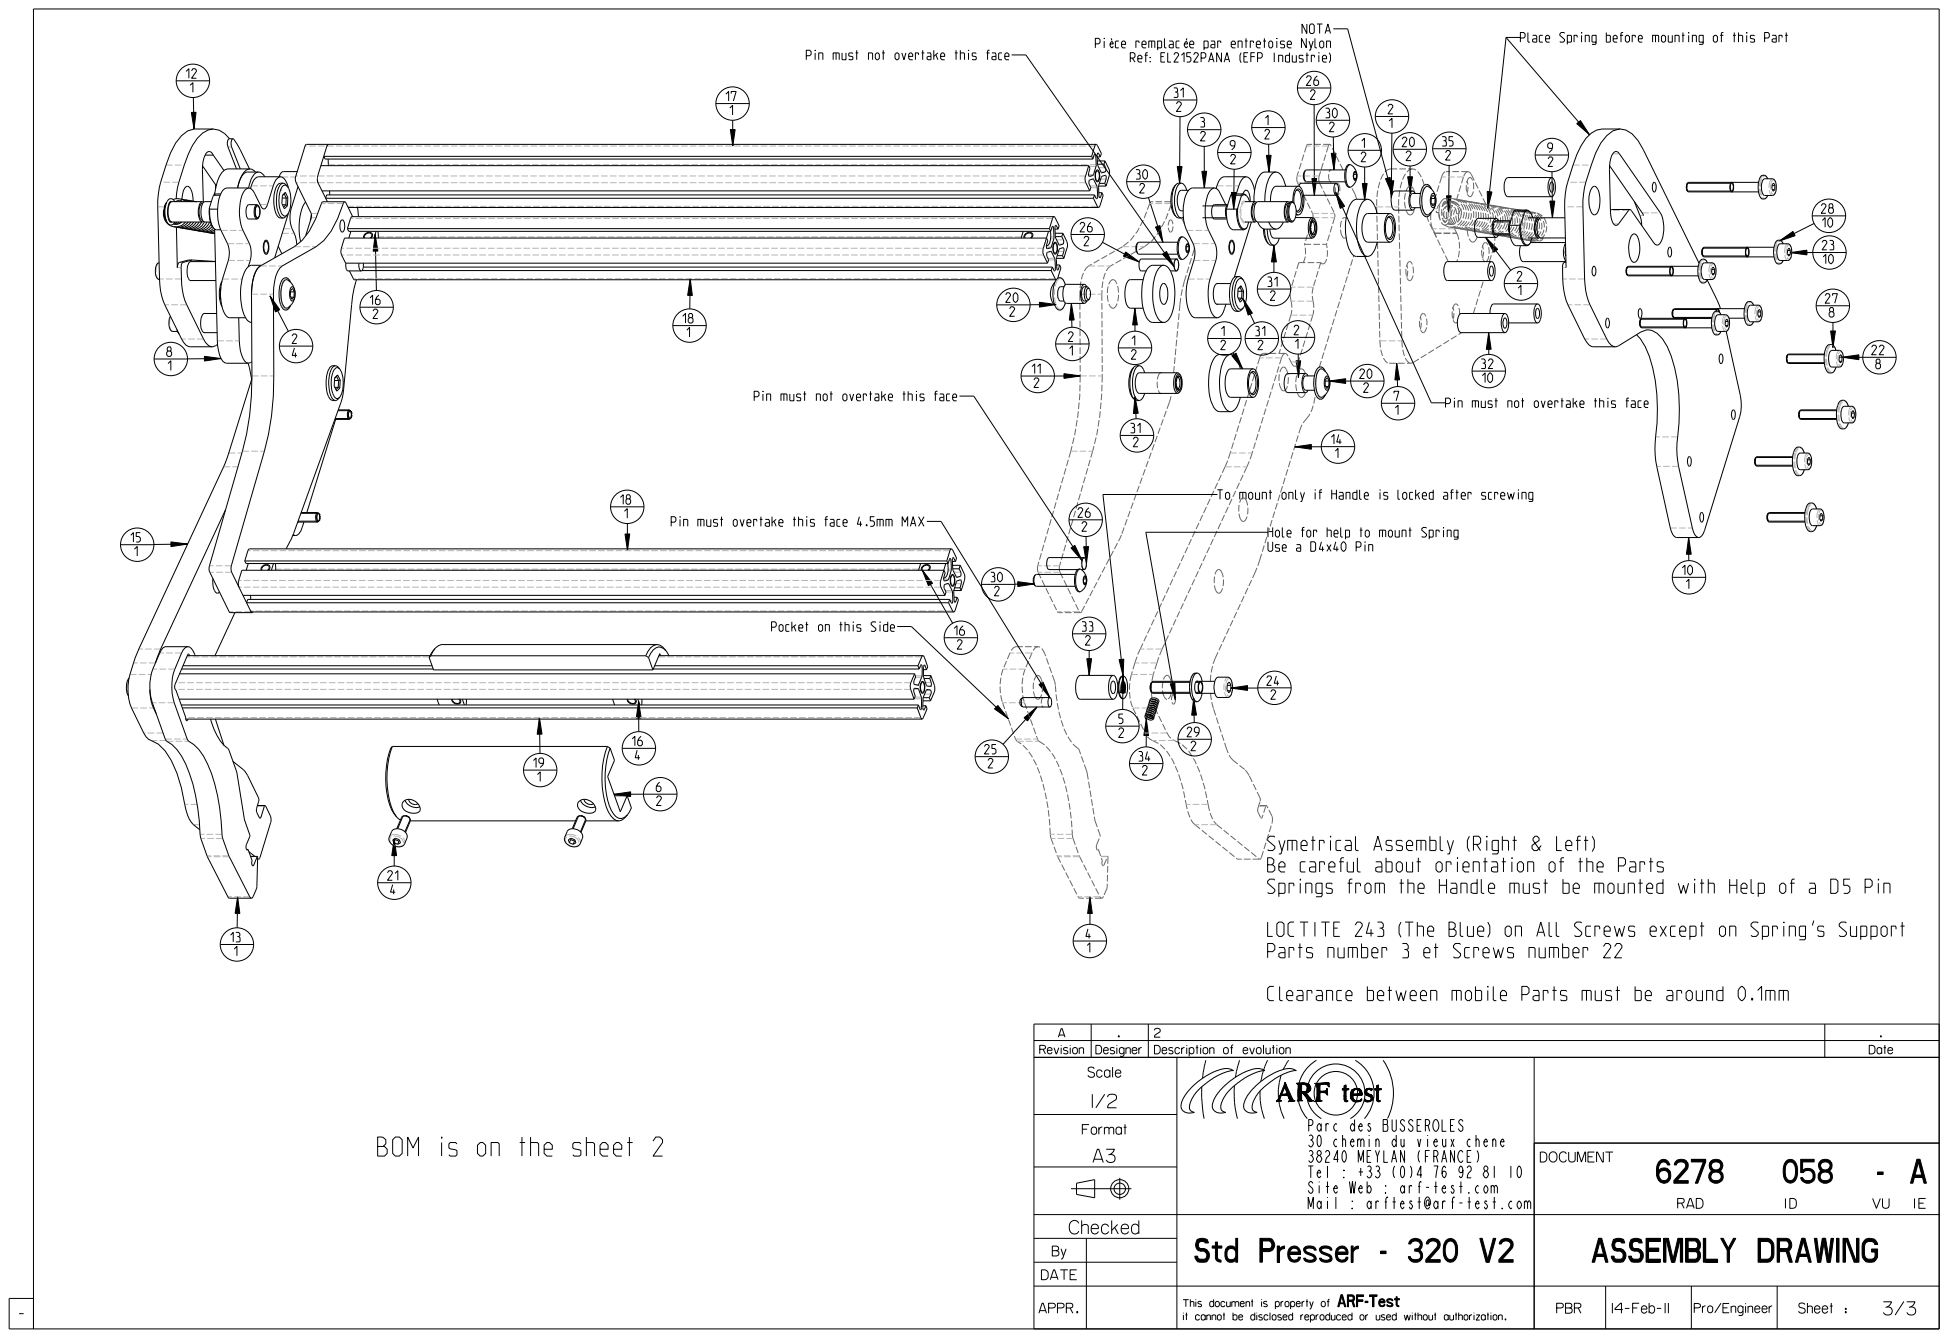
[picture p75: page 3]
