essensys-hub/essensys-test-banc-SC944D/mecanique-arf-test-6281/ASM's Commun/6278_125 (Locating).pdf

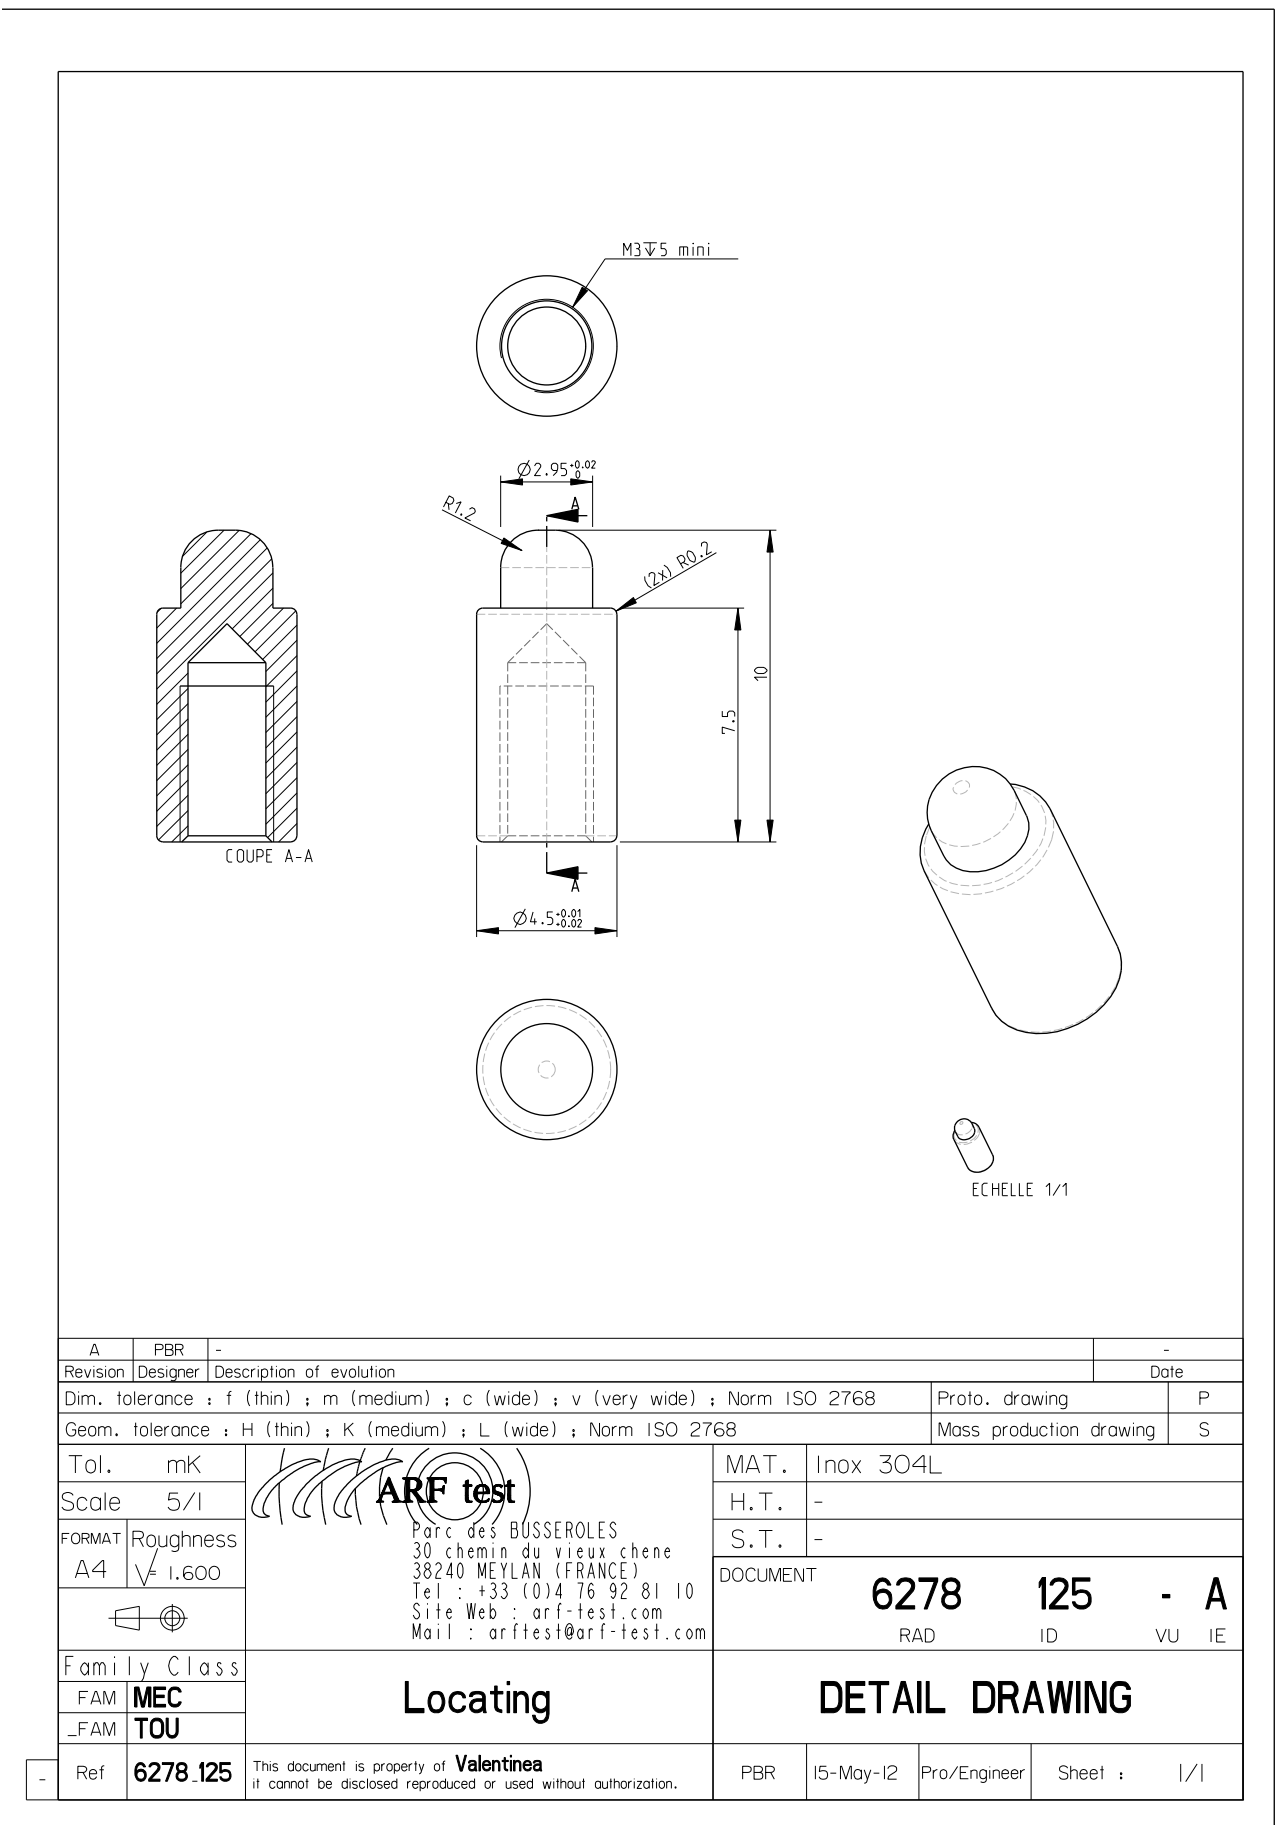
[picture p76: page 1]
