essensys-hub/essensys-test-banc-SC944D/mecanique-arf-test-6281/ASM's Commun/8005_016 (Switch PLC_V2).pdf

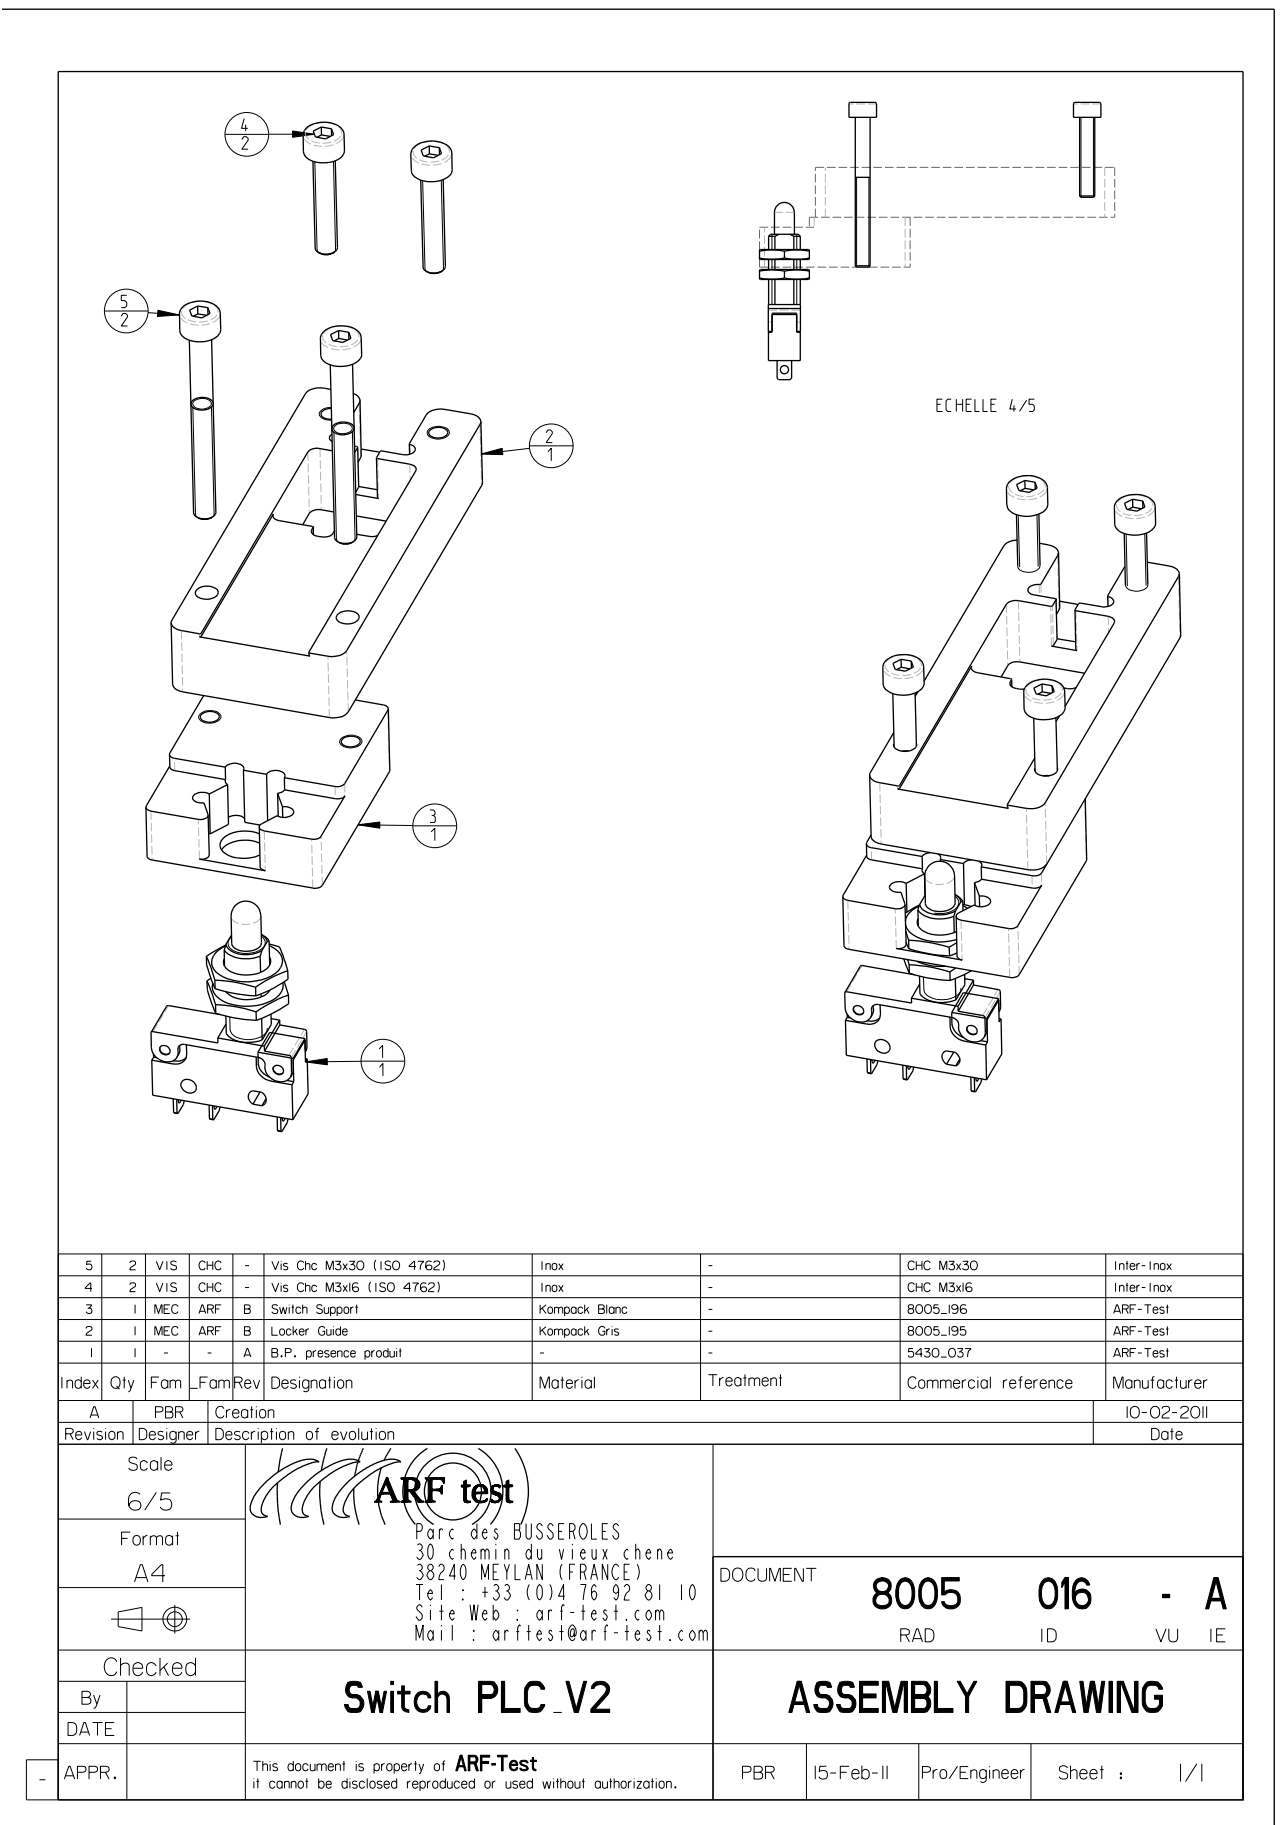
[picture p77: page 1]
