essensys-hub/essensys-test-banc-SC944D/mecanique-arf-test-6281/ASM's Commun/8005_083 (Vis moletee).pdf

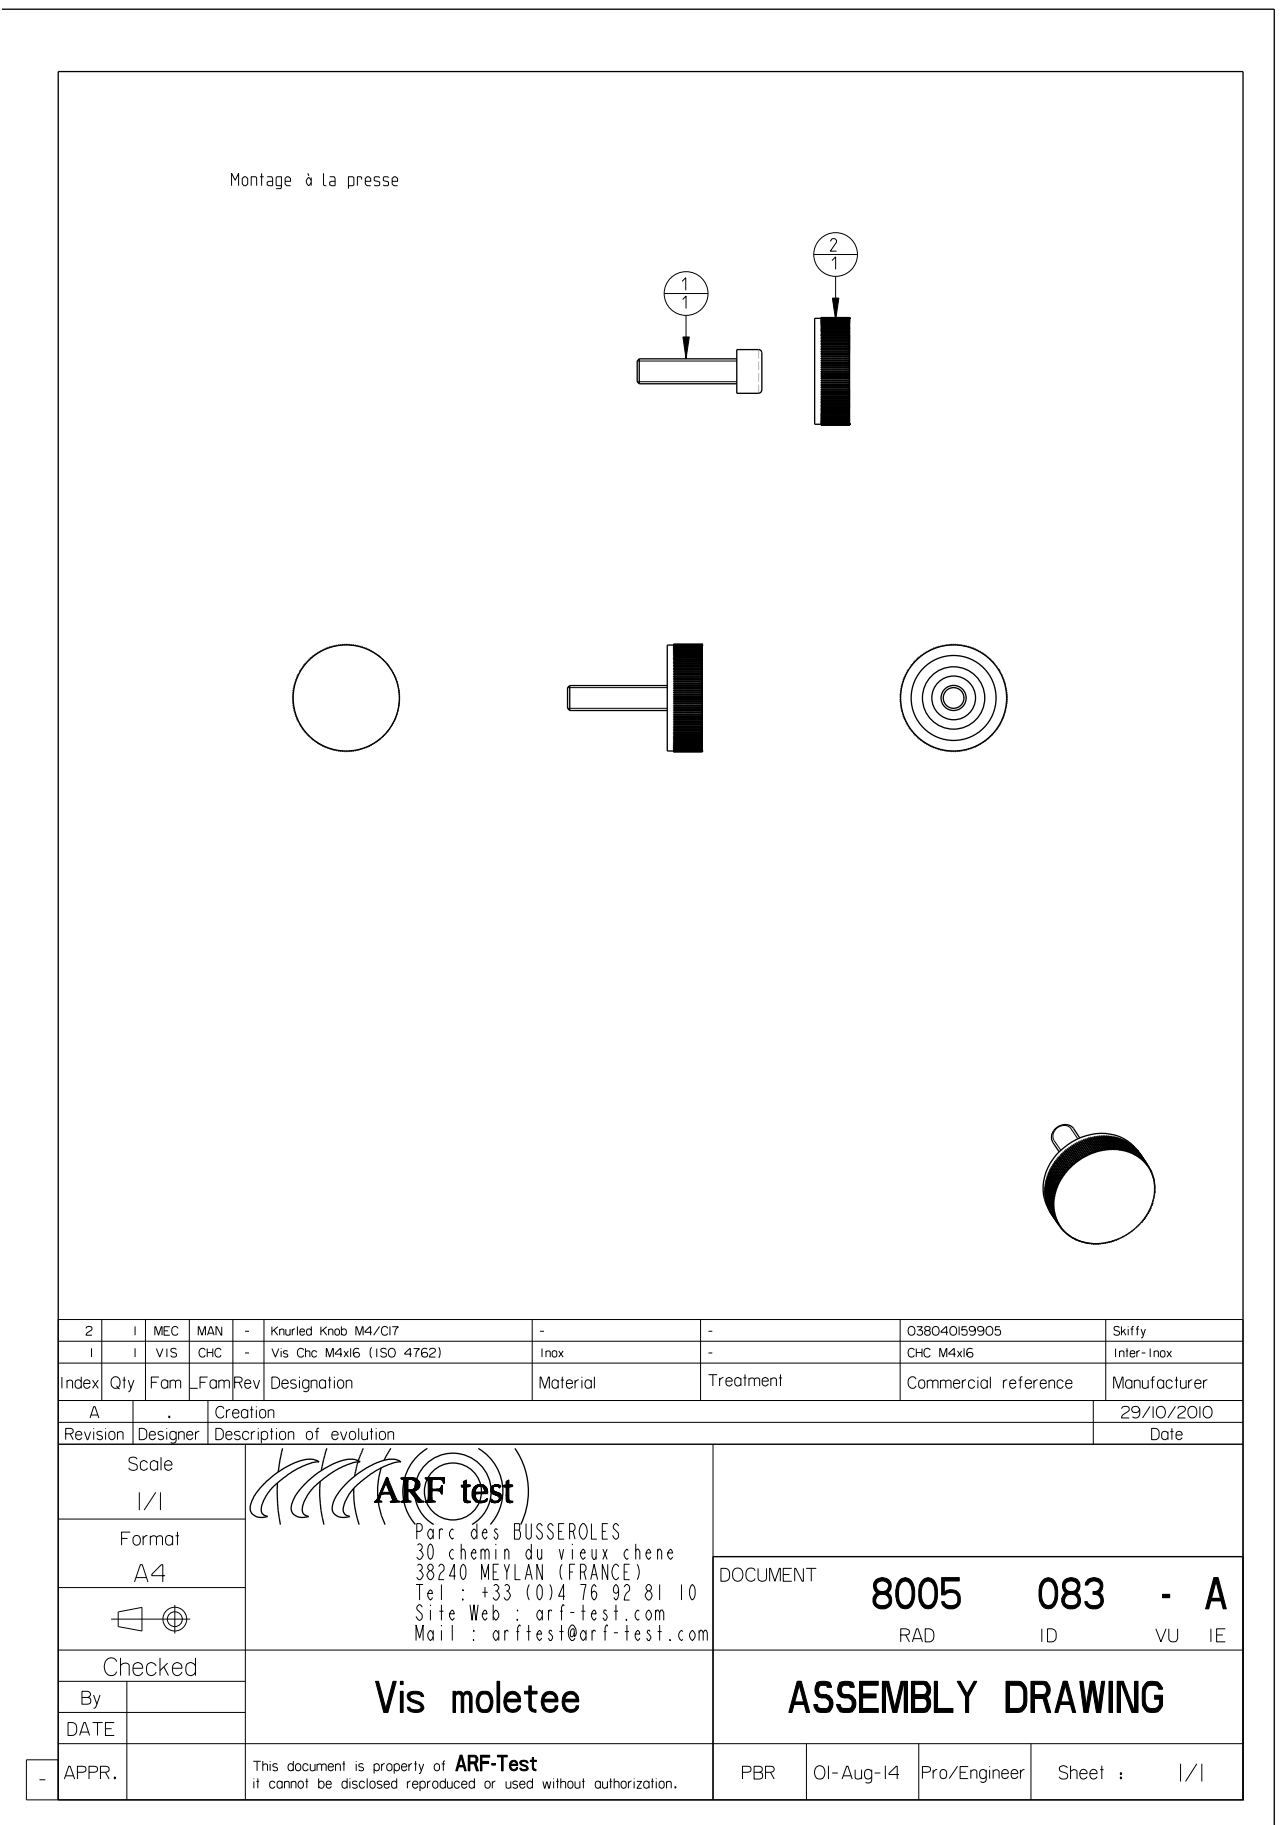
[picture p78: page 1]
