essensys-hub/essensys-test-banc-SC944D/carte-interface-SI841A/face-avant/ci-plan-mecanique-v1.pdf

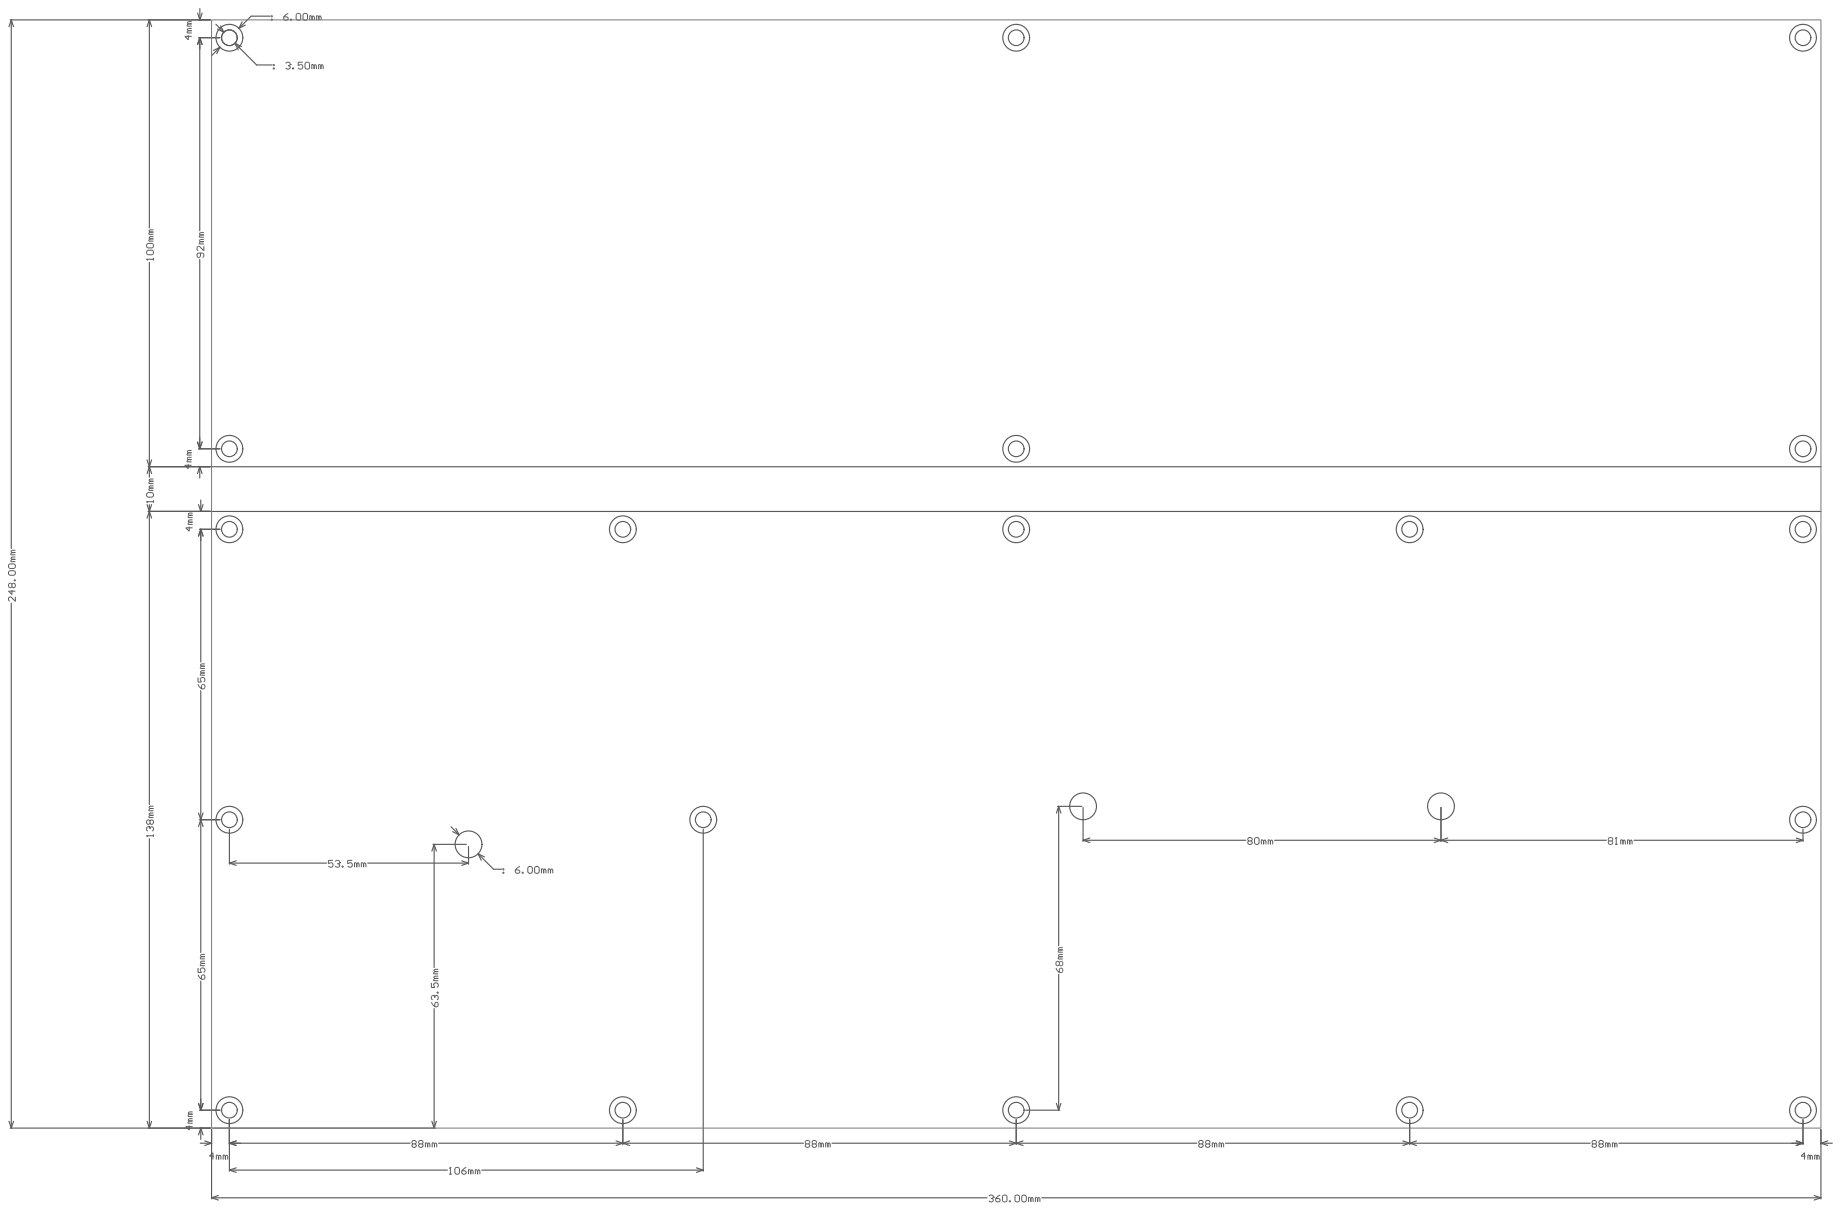
[picture p79: page 1]
