essensys-hub/essensys-test-banc-SC944D/carte-interface-SI841A/face-avant/ci-v5.pdf

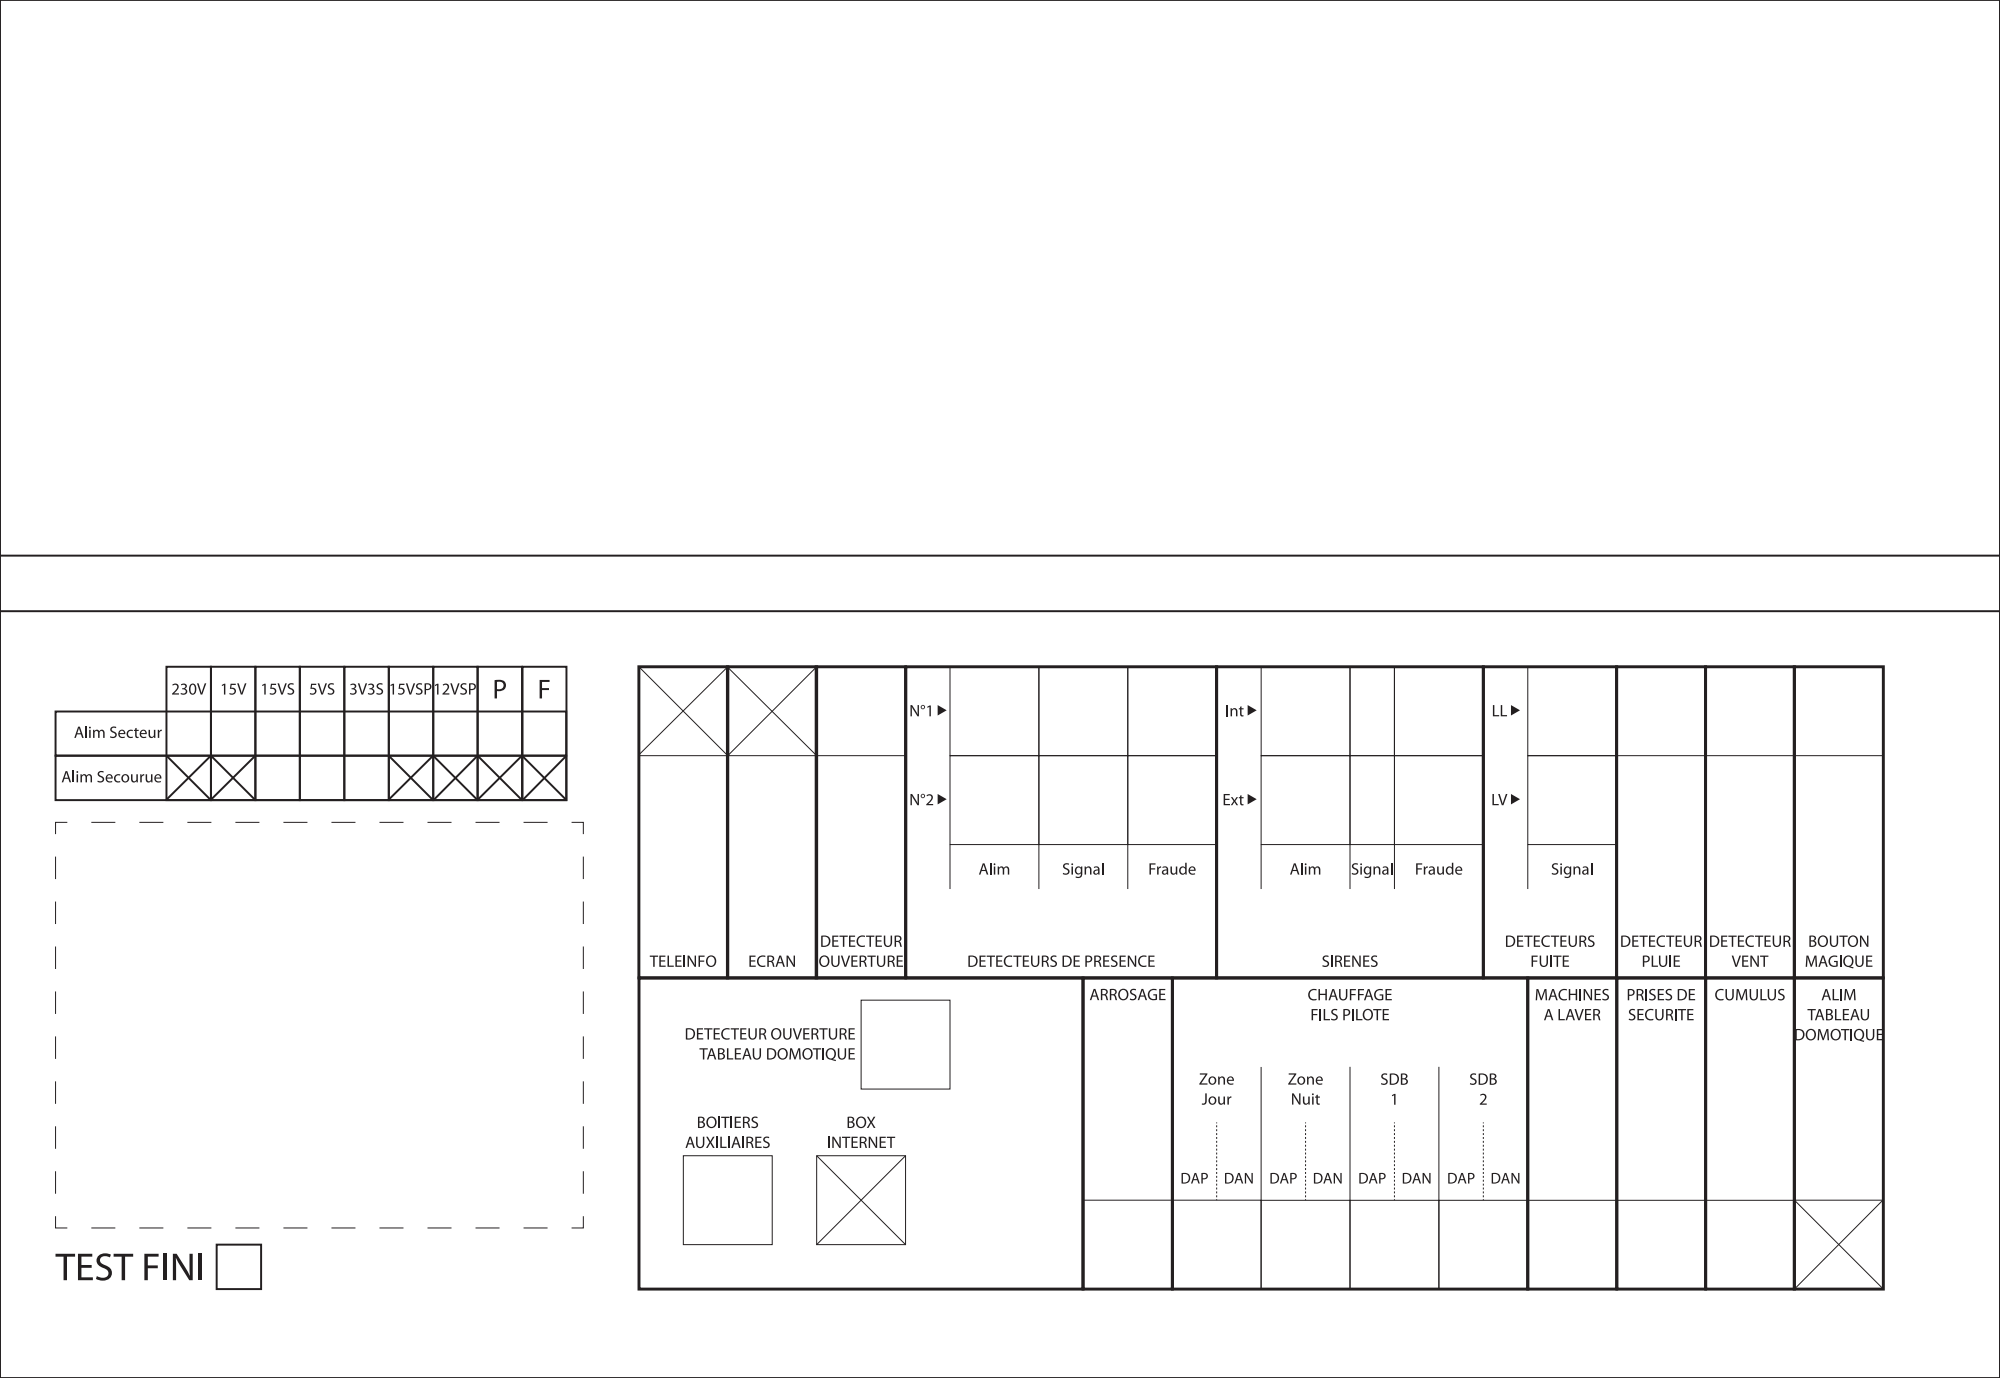
[picture p80: page 1]
