essensys-hub/essensys-test-banc-SC944D/carte-interface-SI841A/schema/archives/schema-banc-bp-v1.pdf

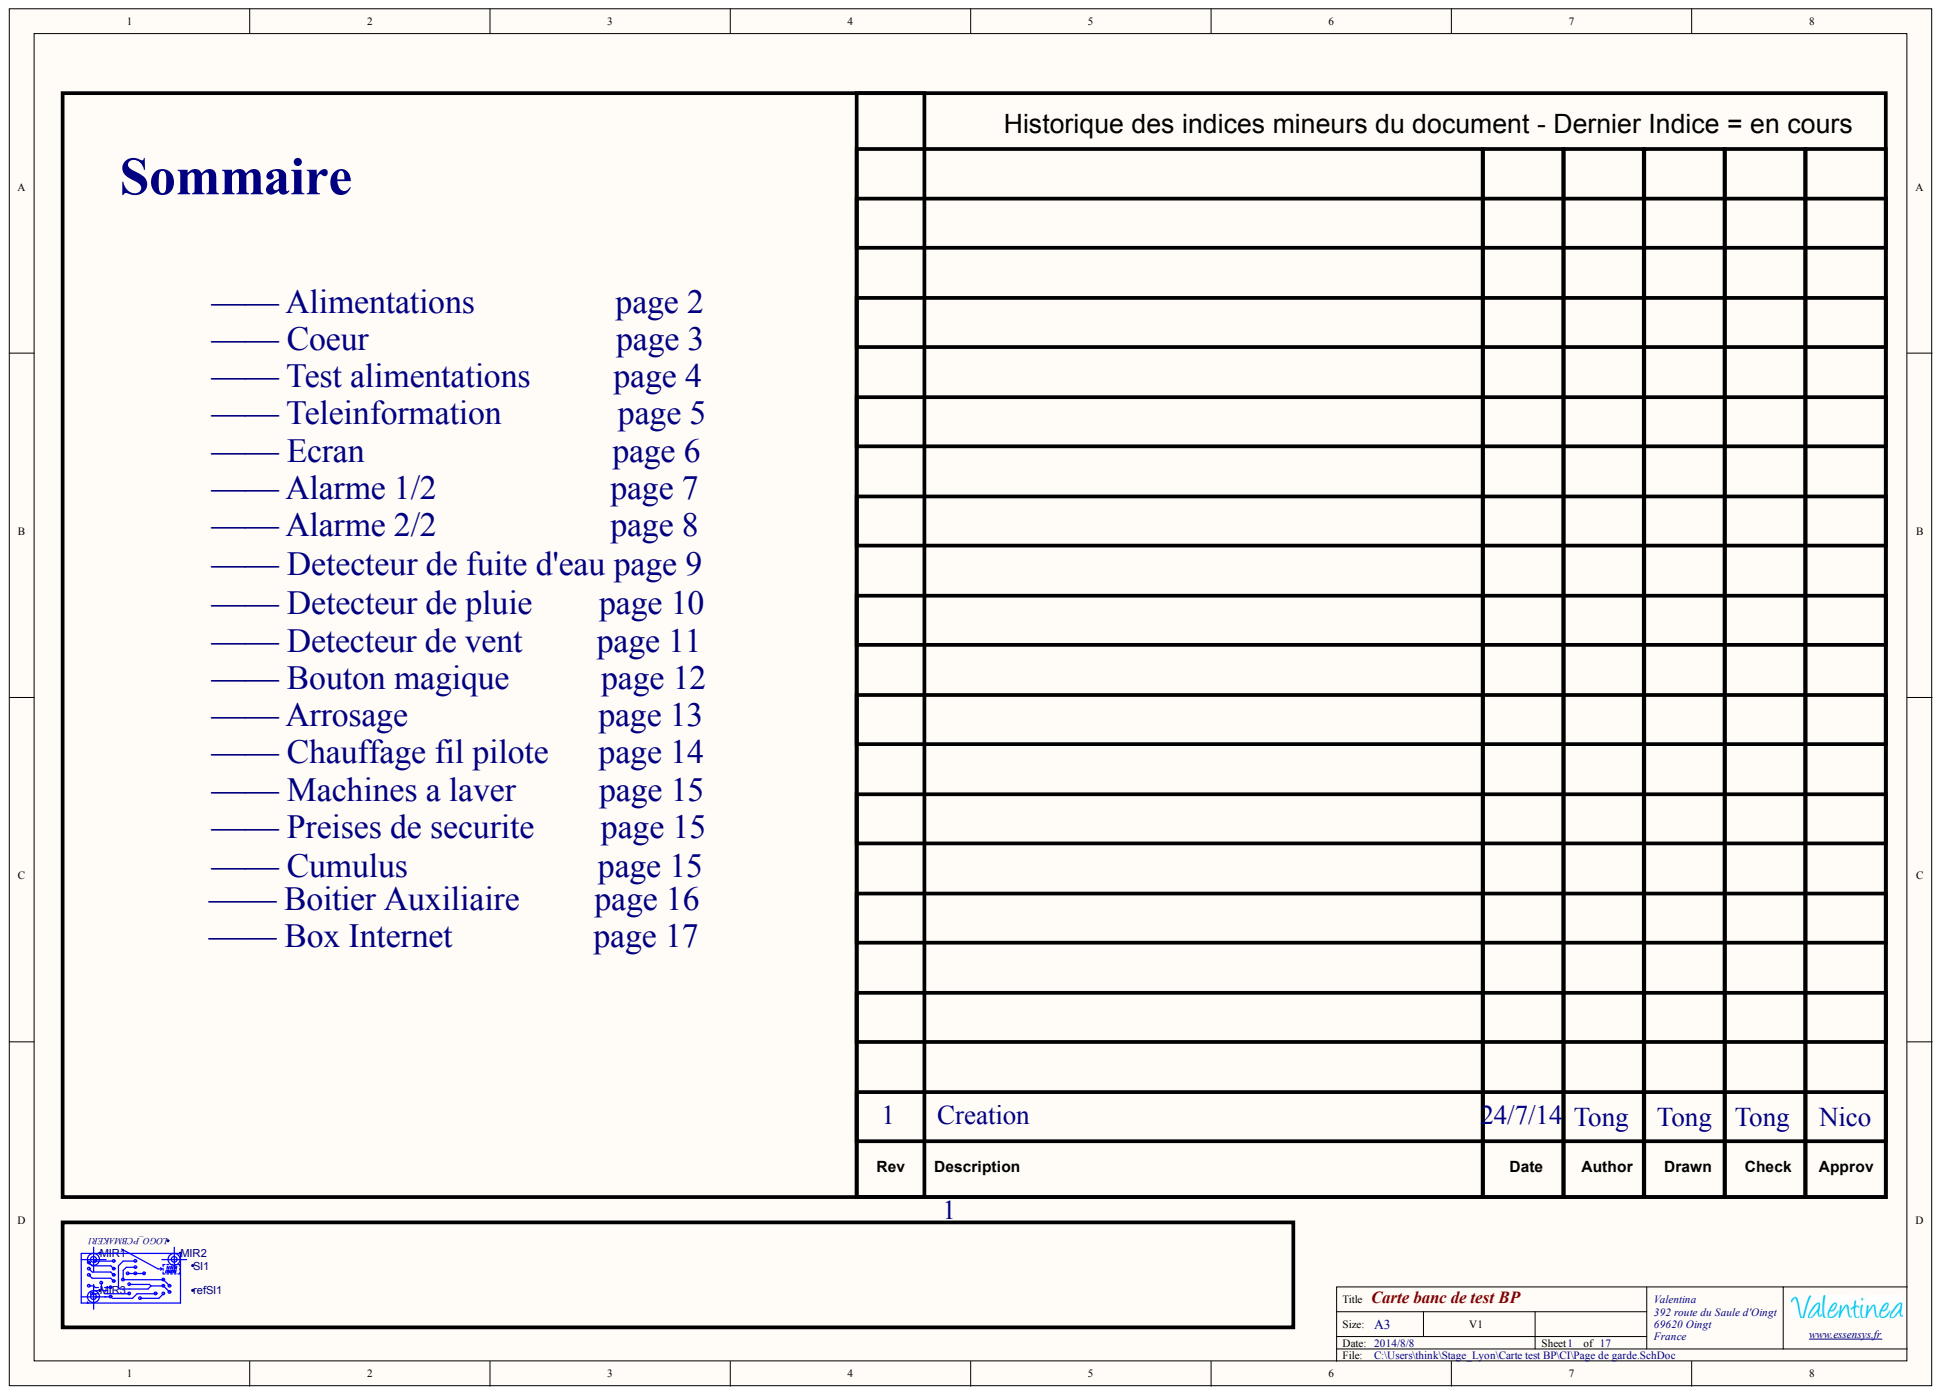
[picture p81: page 1]

Historique des indices mineurs du document - Dernier Indice = en cours

—— Detecteur de fuite d'eau page 9

1 | Creation | 24/7/14 | Tong | Tong | Tong | Nico

Rev | Description | Date | Author | Drawn | Check | Approv

Title Carte banc de test BP | Valentin¨ ¦ a 392 route du Saule d'Oingt 69620 Oingt France | www.essensys.fr 17

Size: A3 | V1

Date: | | Sheet of

C:\Users\think\Stage_Lyon\Carte test BP\CI\Page de garde.SchDoc

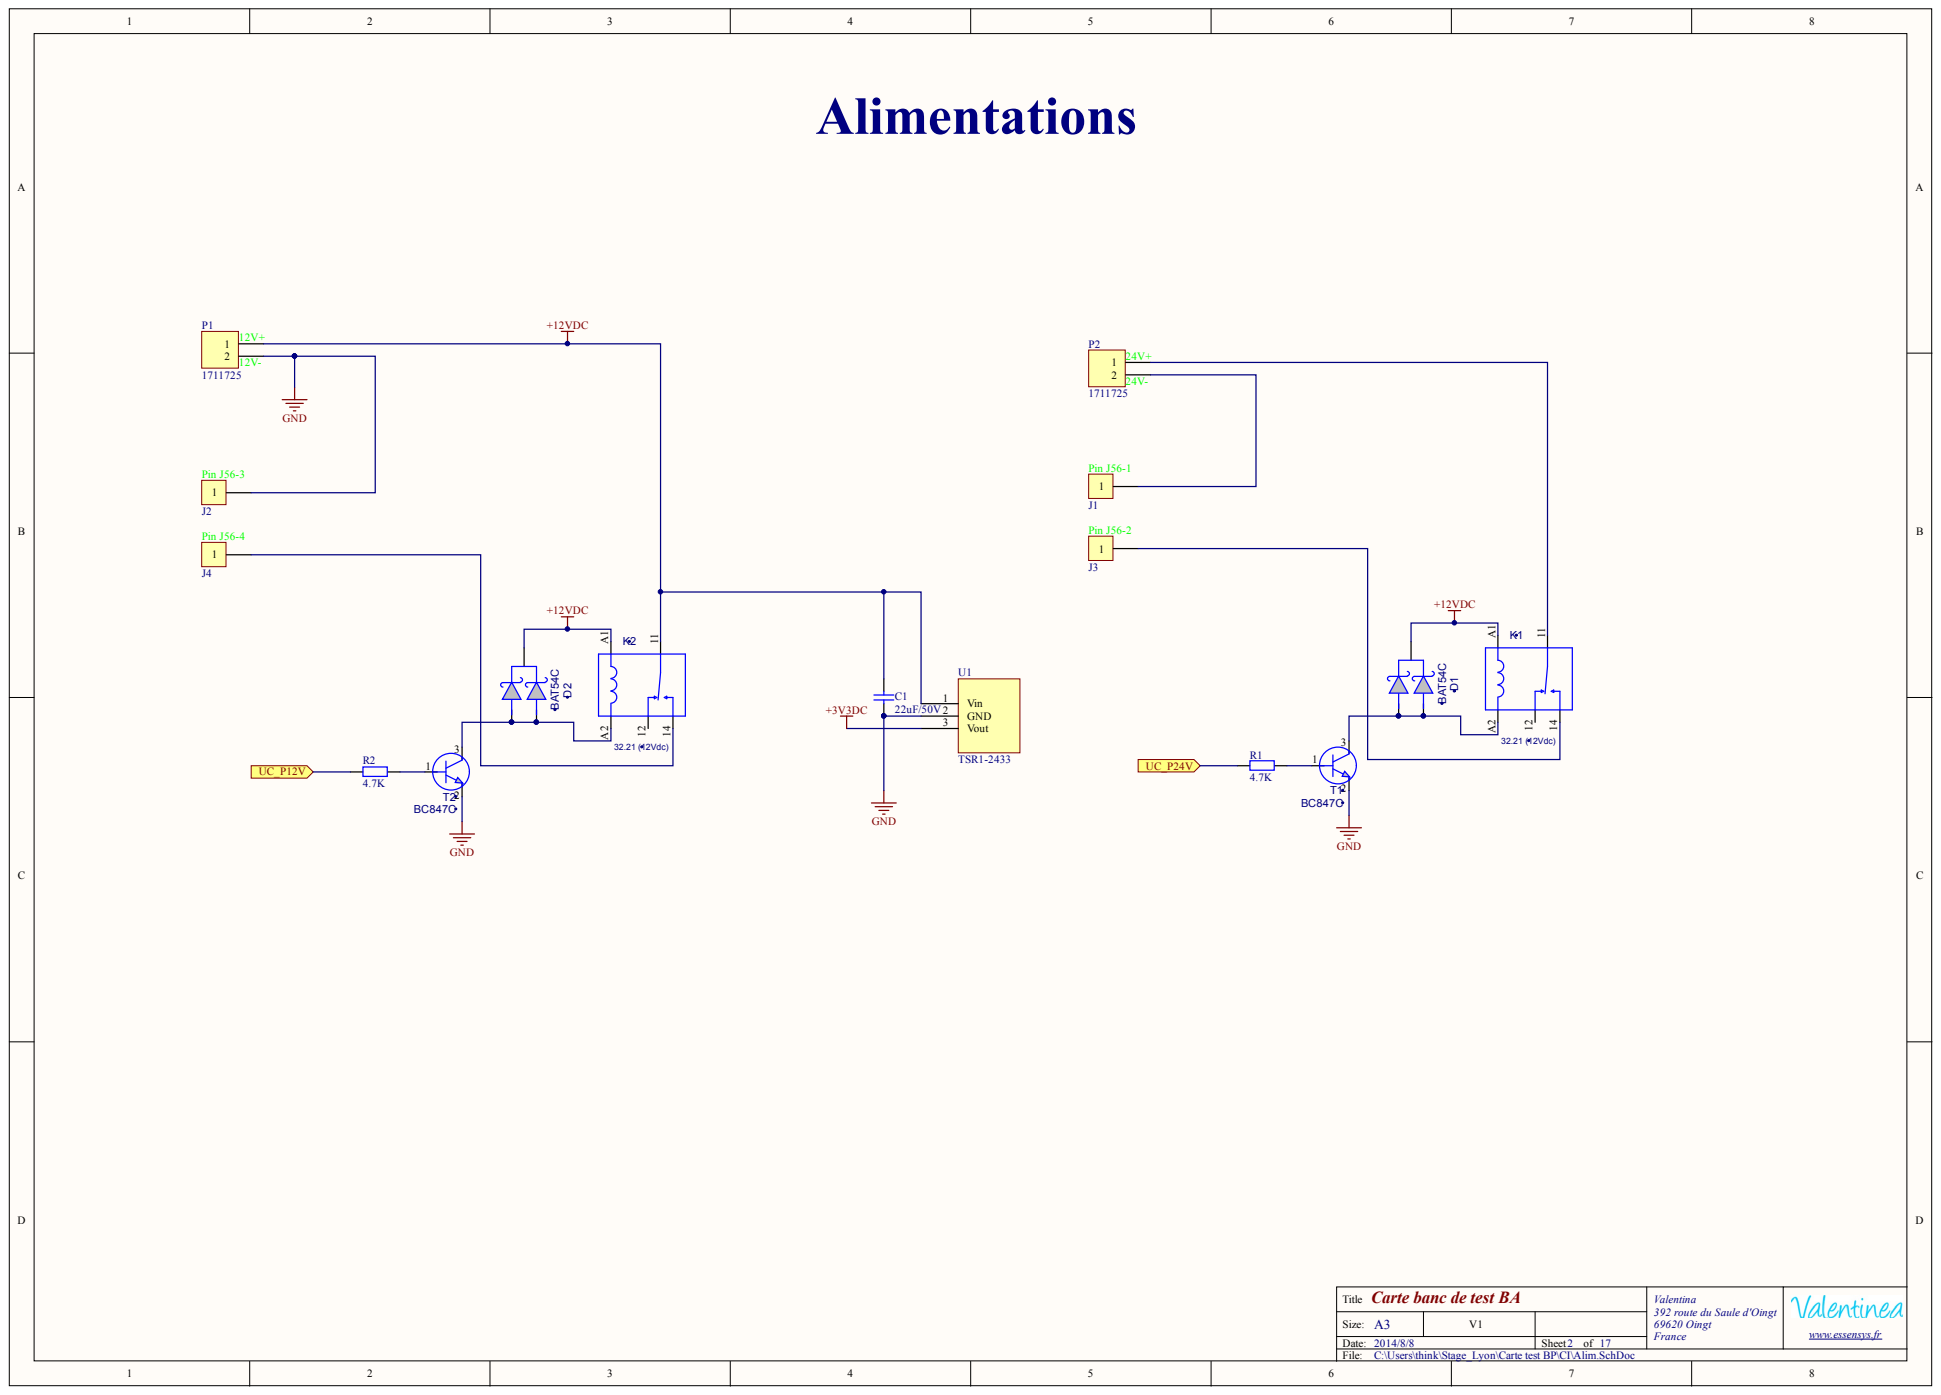
[picture p82: page 2]
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

Size: | V

/ / | | Sheet o f

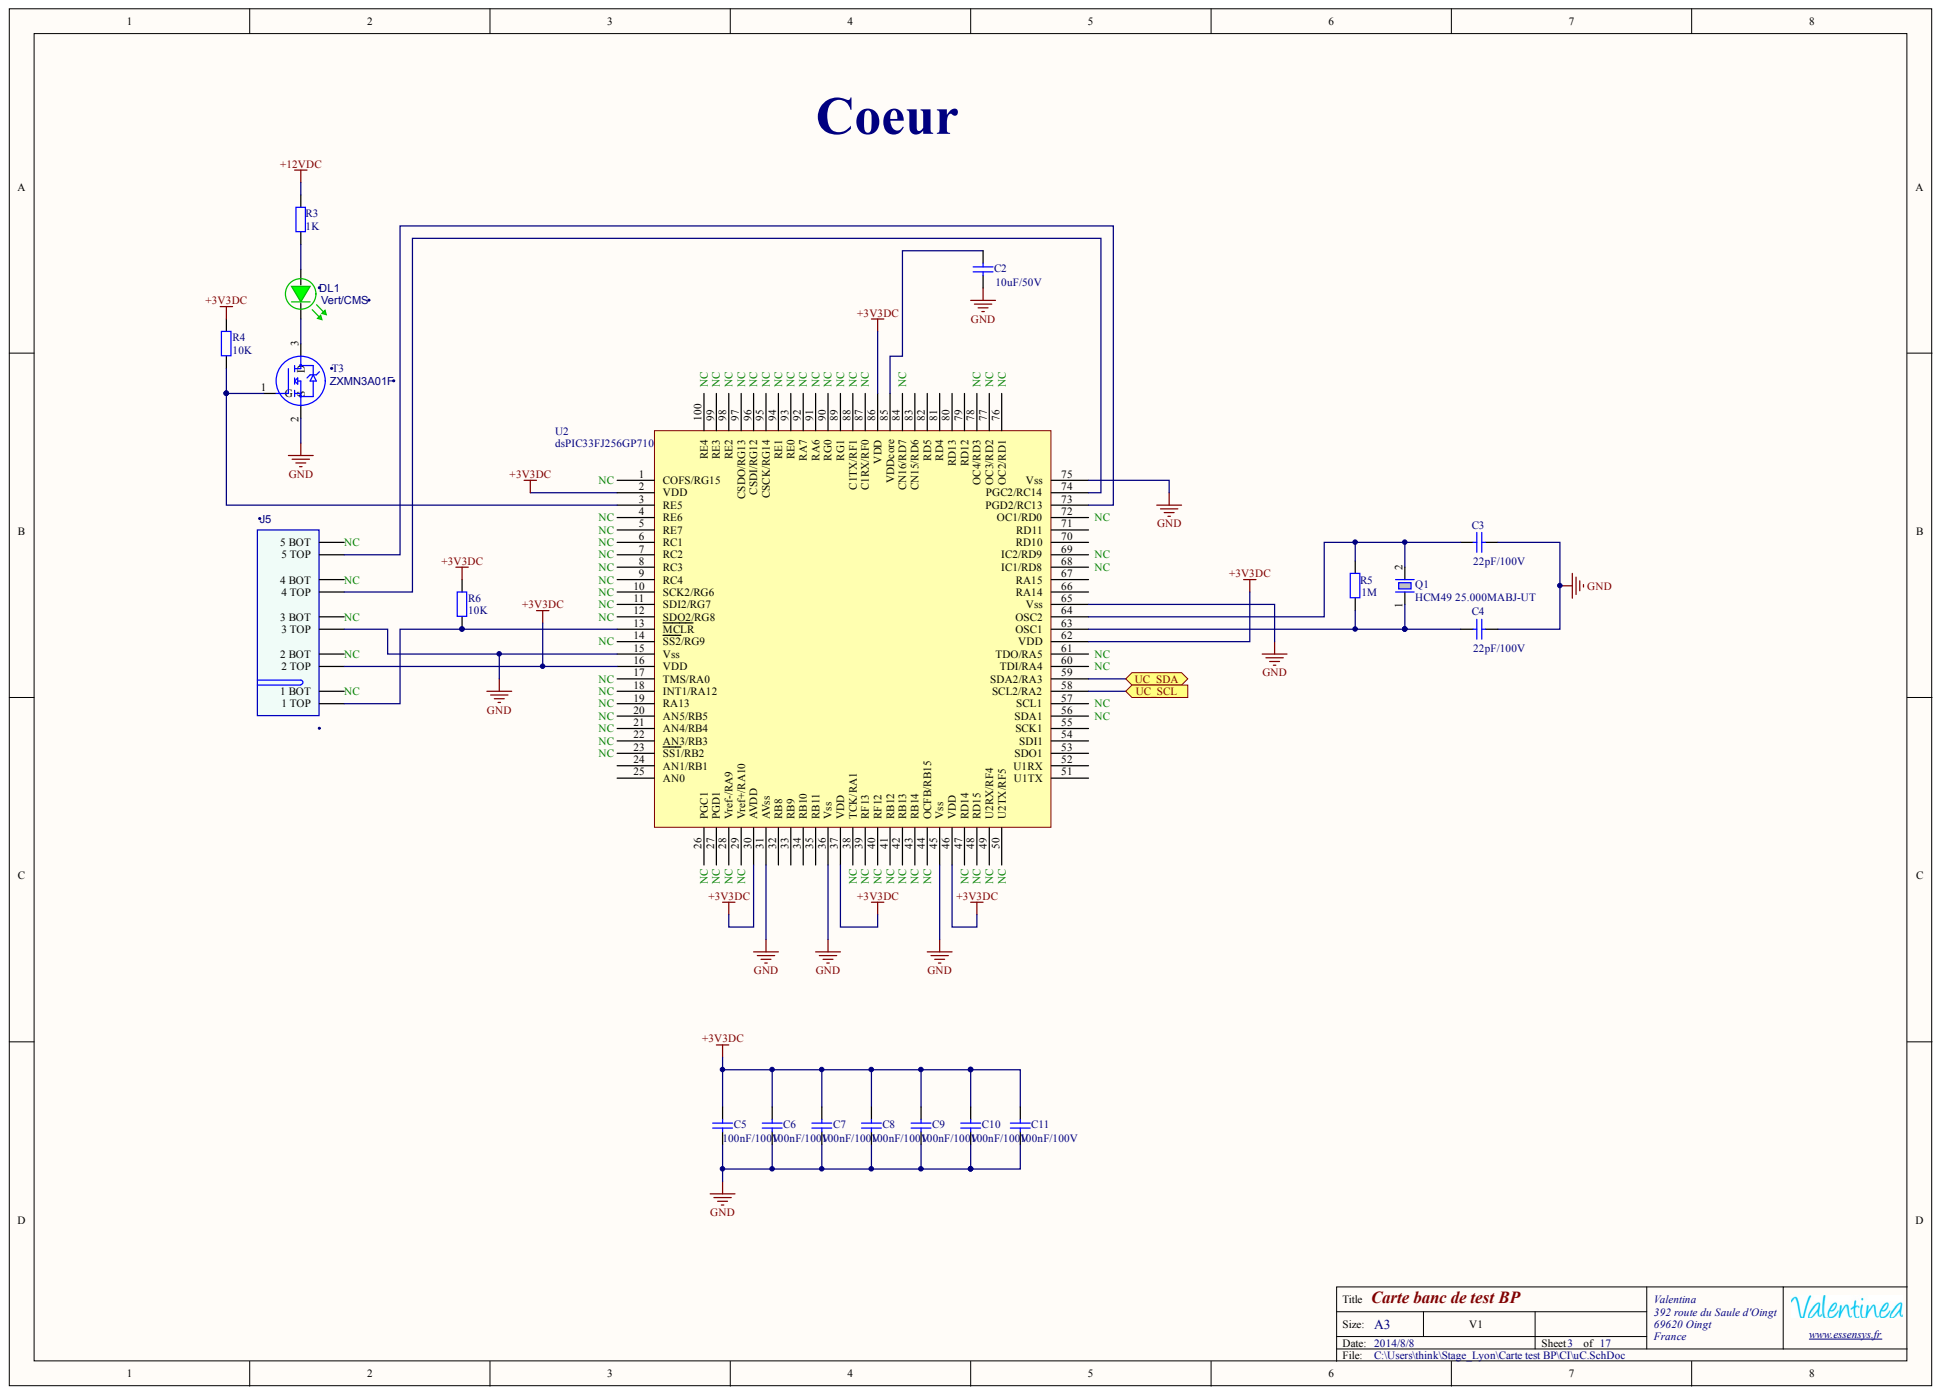
[picture p83: page 3]
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

Size: | V

/ / | | Sheet o f

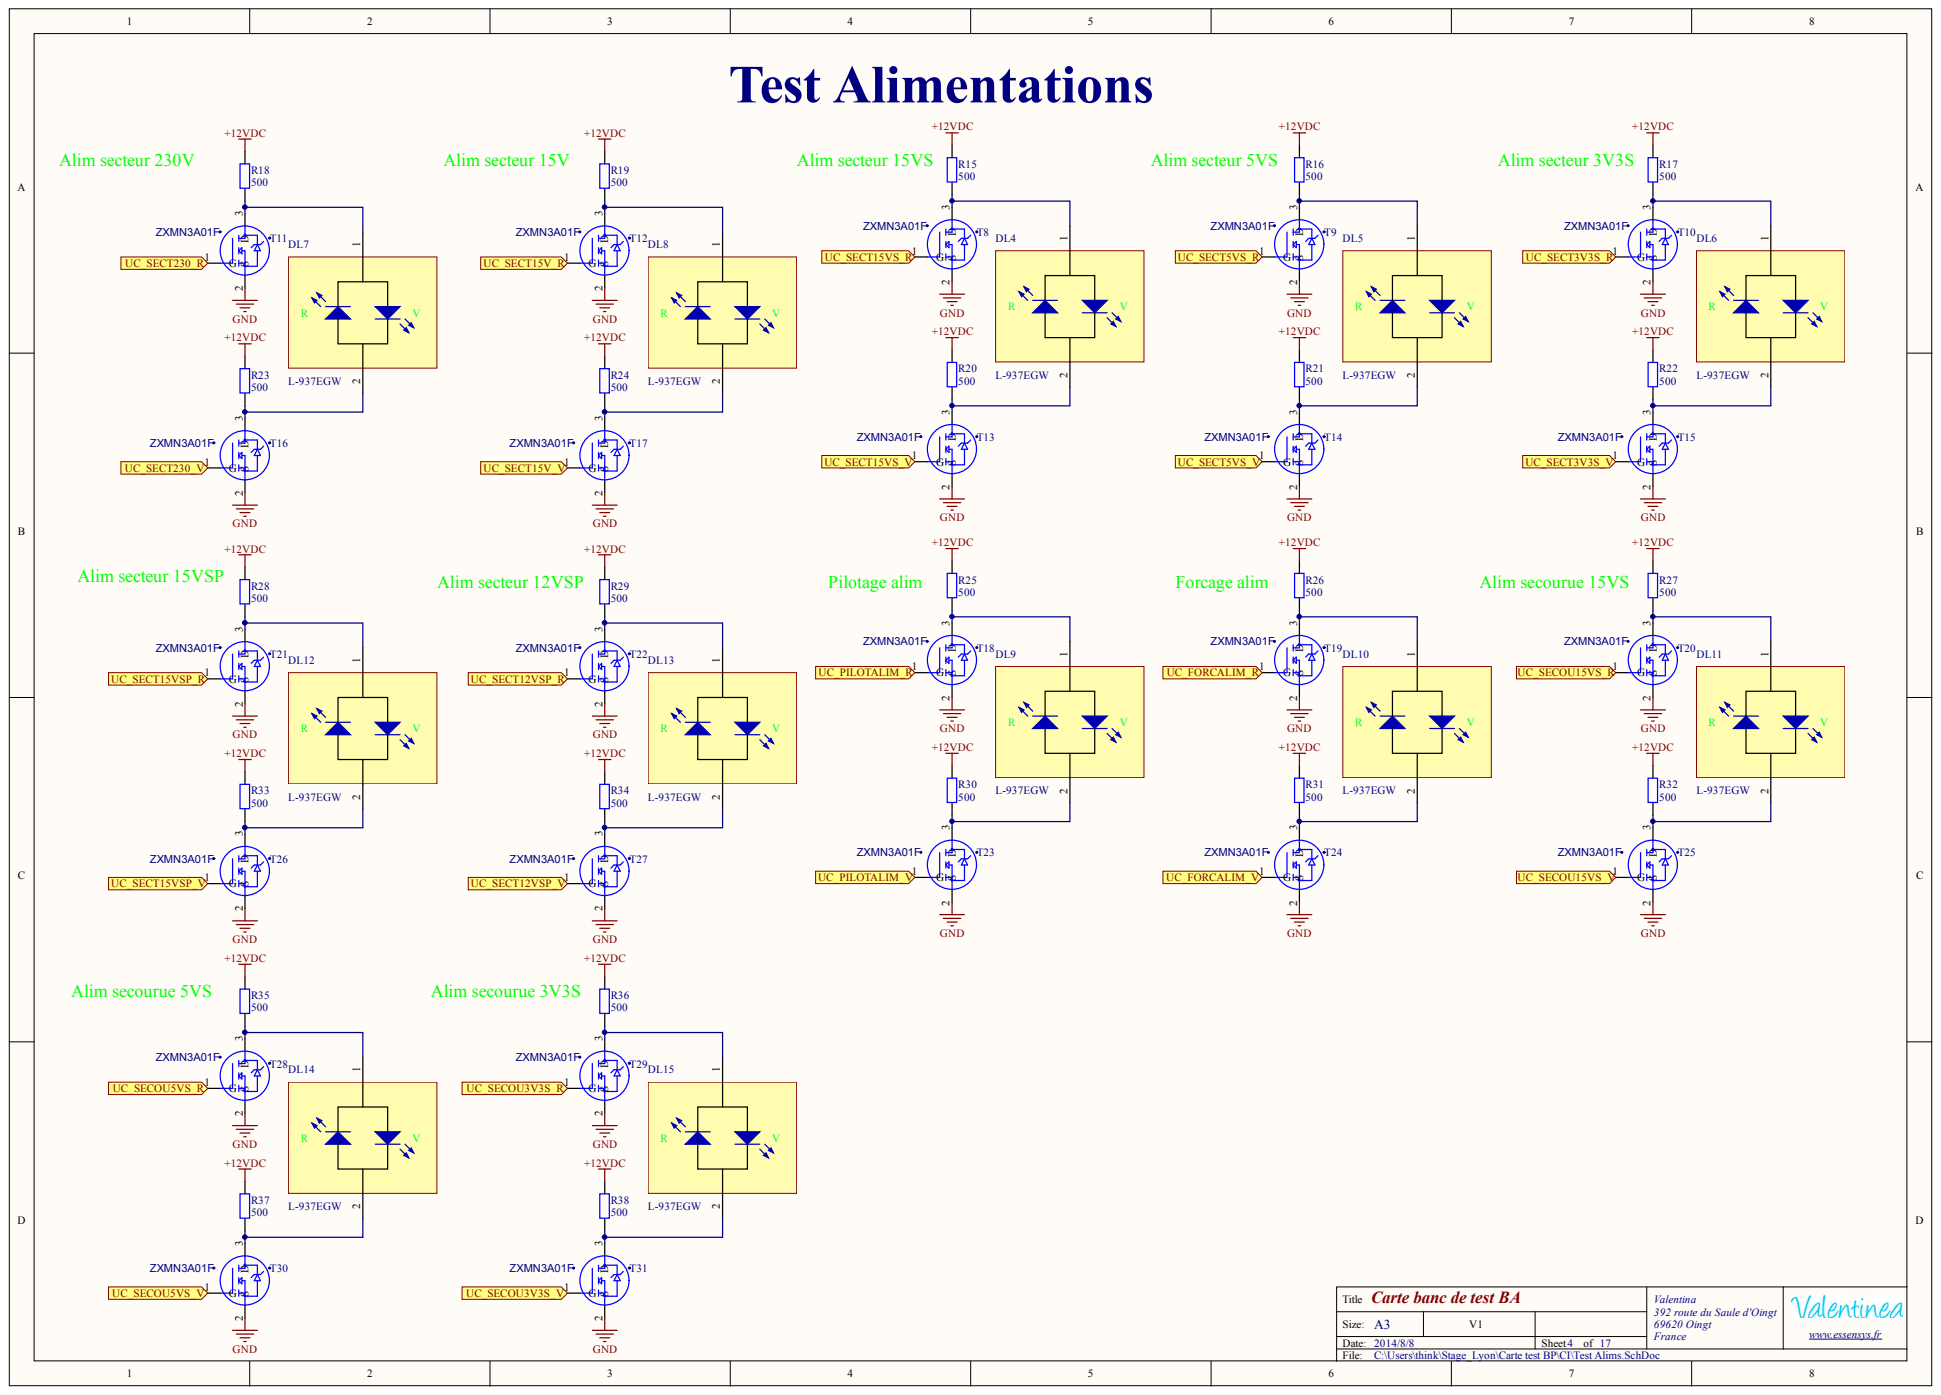
[picture p84: page 4]
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

Size: | V

/ / | | Sheet o f

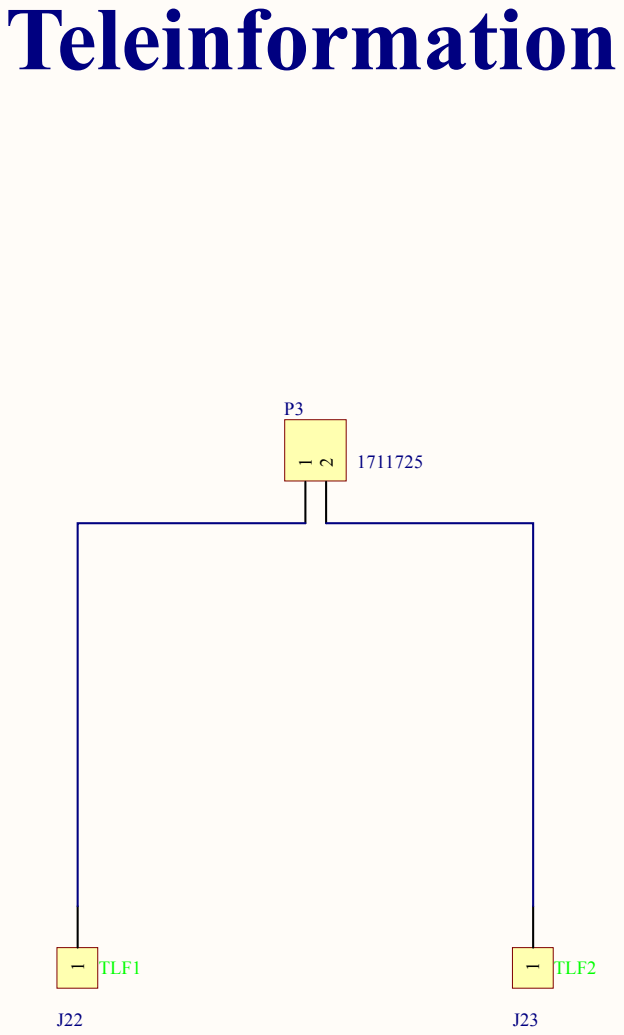
[picture p85: page 5]

Carte banc de test BA

C:\Users\think\Stage_Lyon\Carte test BP\CI\Teleinfo.SchDoc

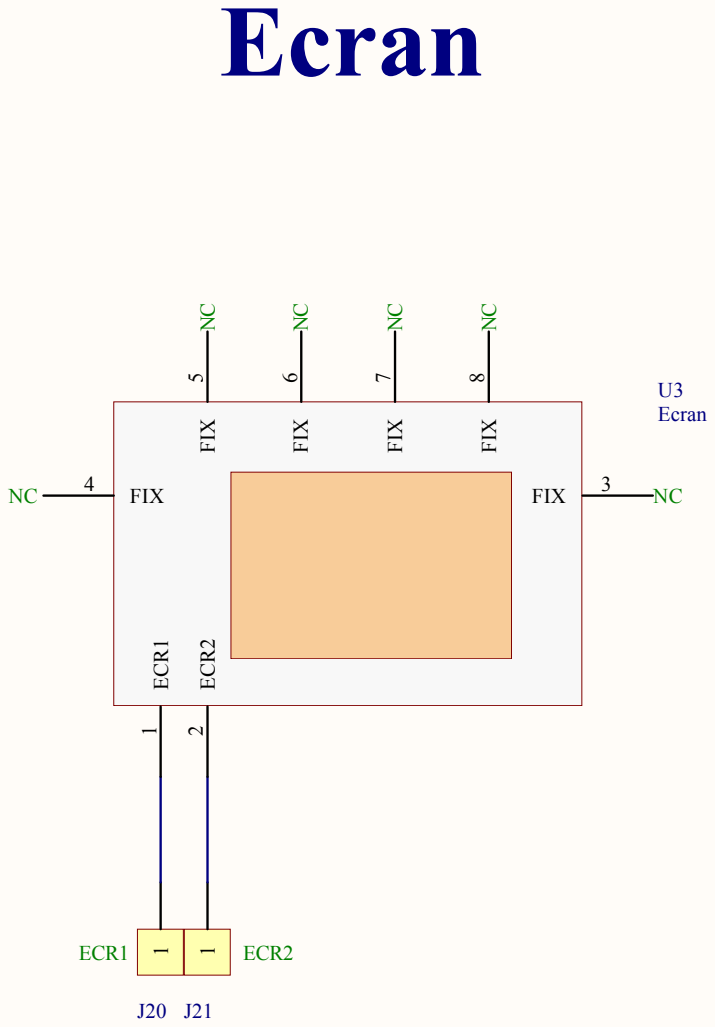
[picture p86: page 6]

C:\Users\think\Stage_Lyon\Carte test BP\CI\Ecran.SchDoc

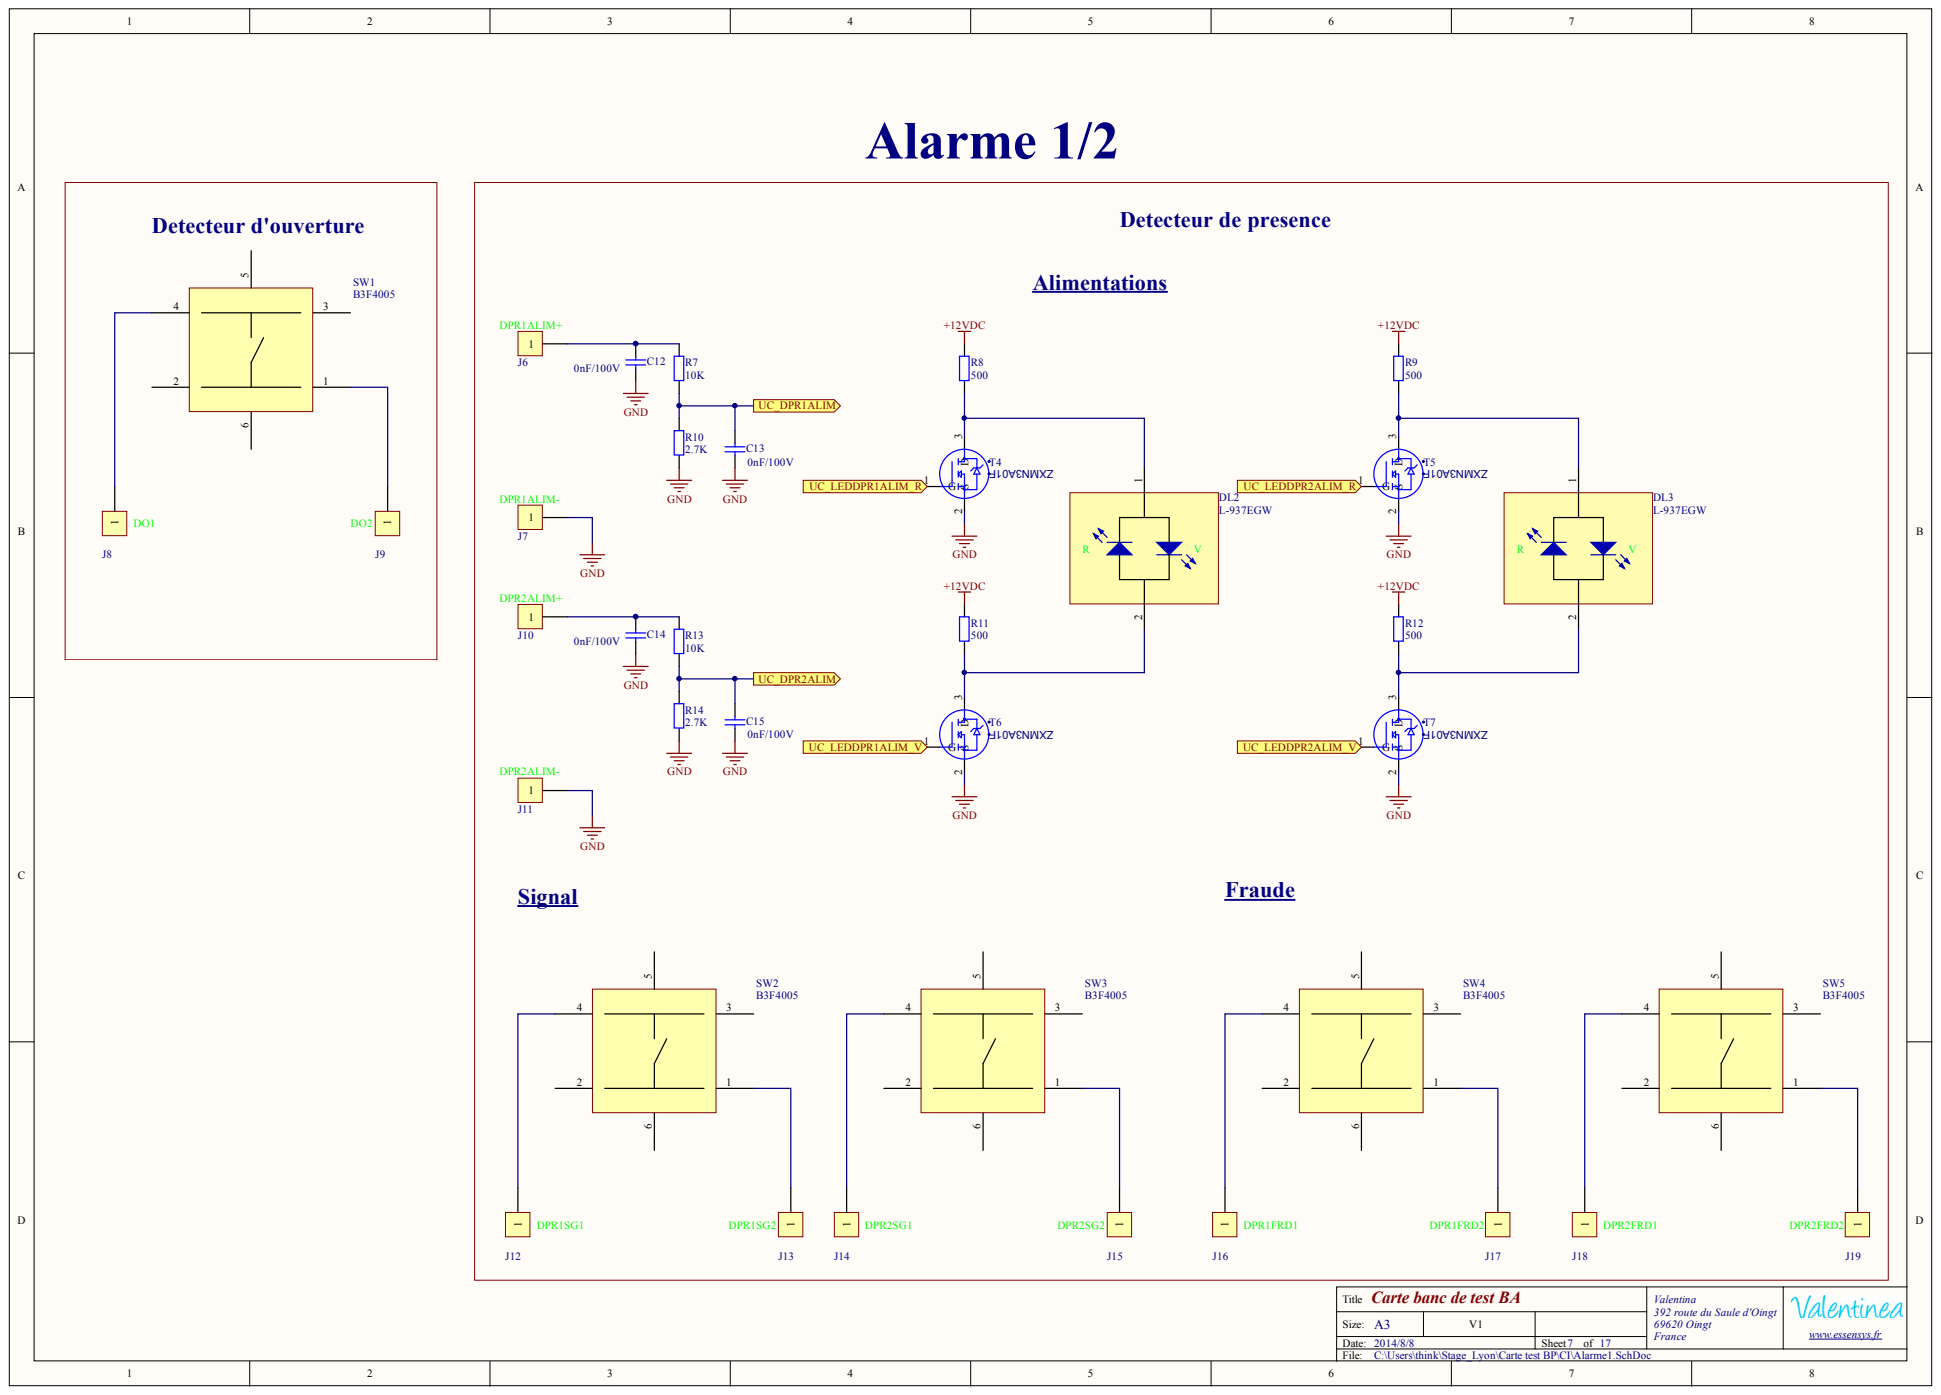
[picture p87: page 7]

C:\Users\think\Stage_Lyon\Carte test BP\CI\Alarme1.SchDoc

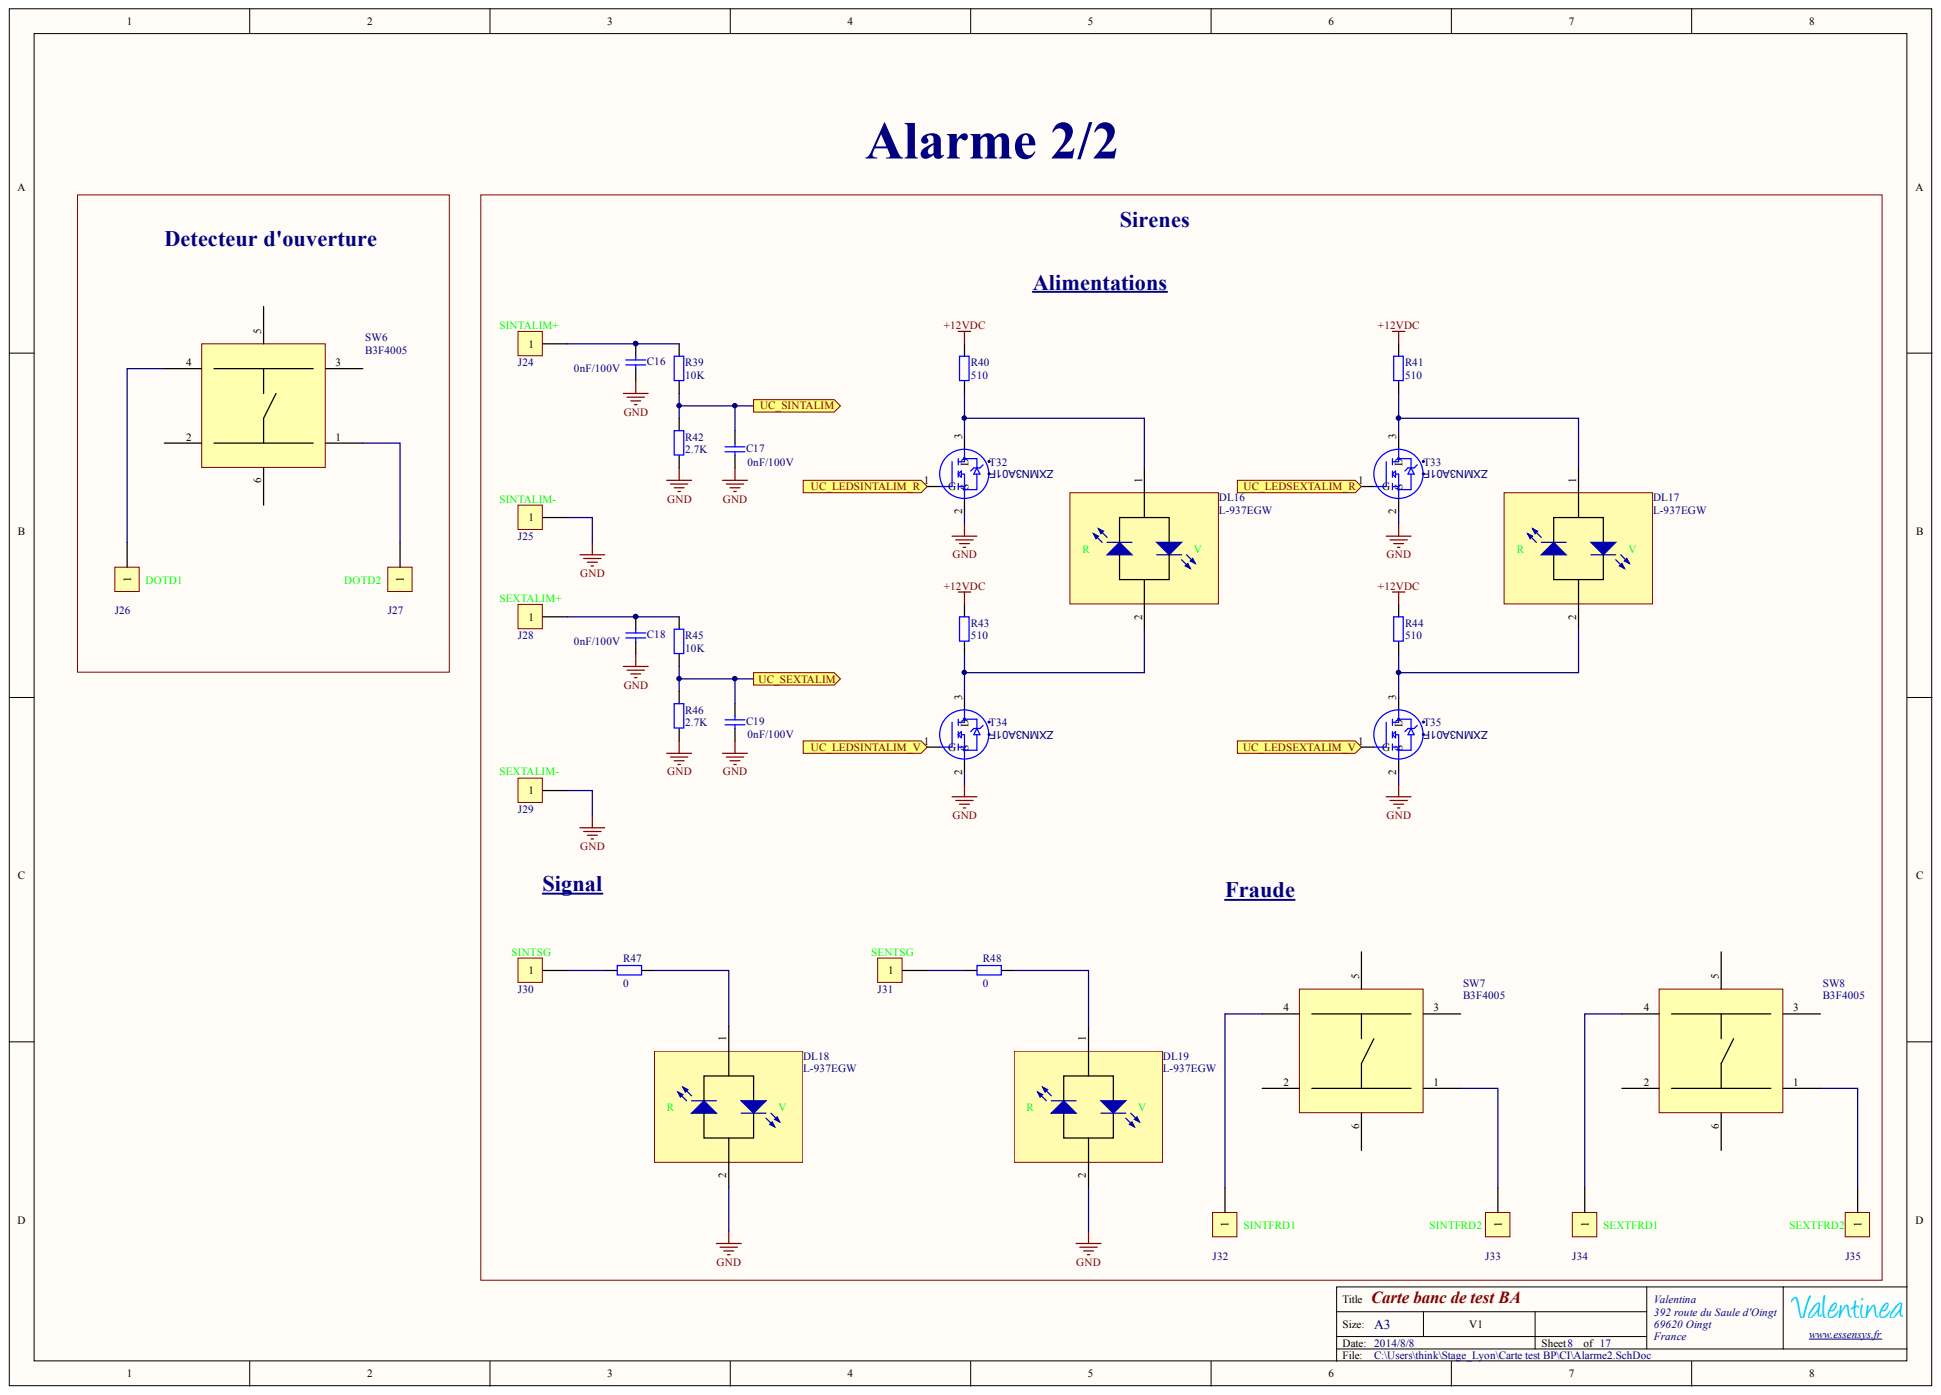
[picture p88: page 8]

C:\Users\think\Stage_Lyon\Carte test BP\CI\Alarme2.SchDoc

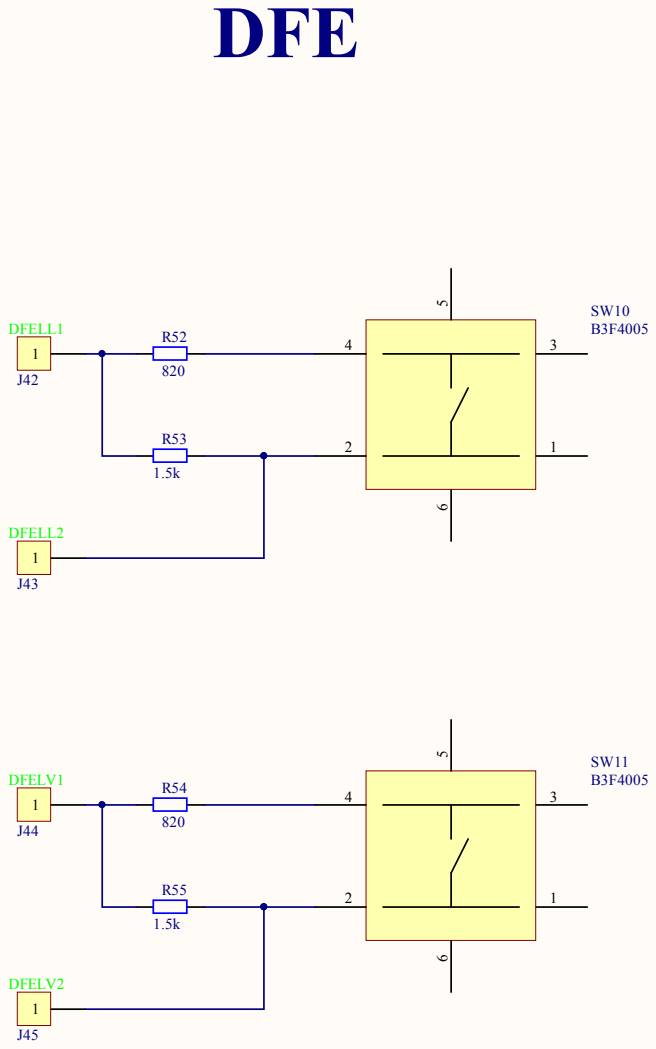
[picture p89: page 9]

C:\Users\think\Stage_Lyon\Carte test BP\CI\DFE.SchDoc

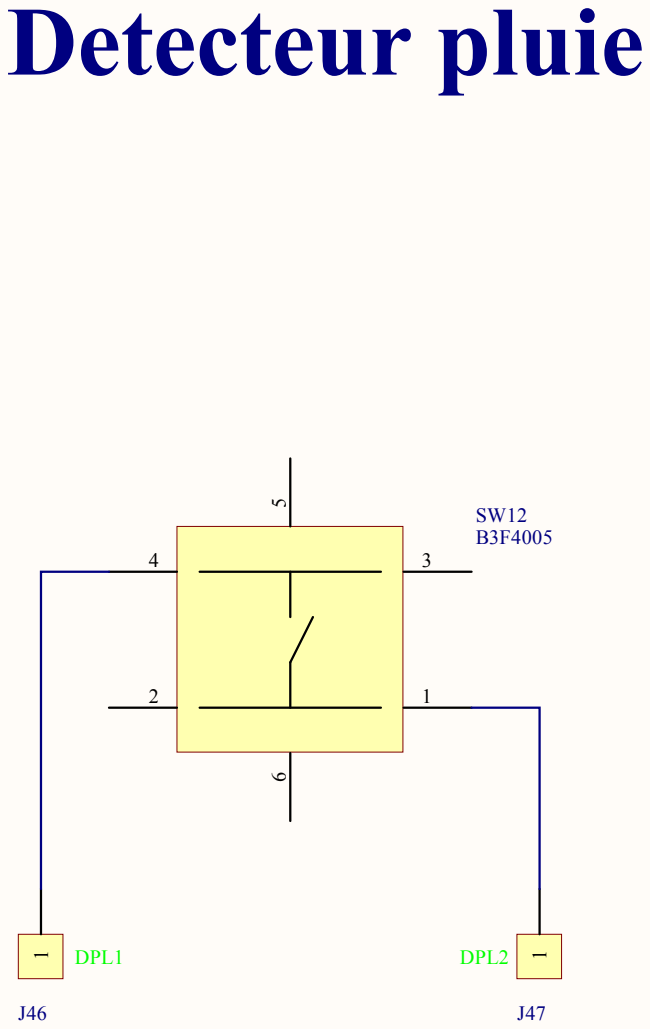
[picture p90: page 10]

C:\Users\think\Stage_Lyon\Carte test BP\CI\DPL.SchDoc

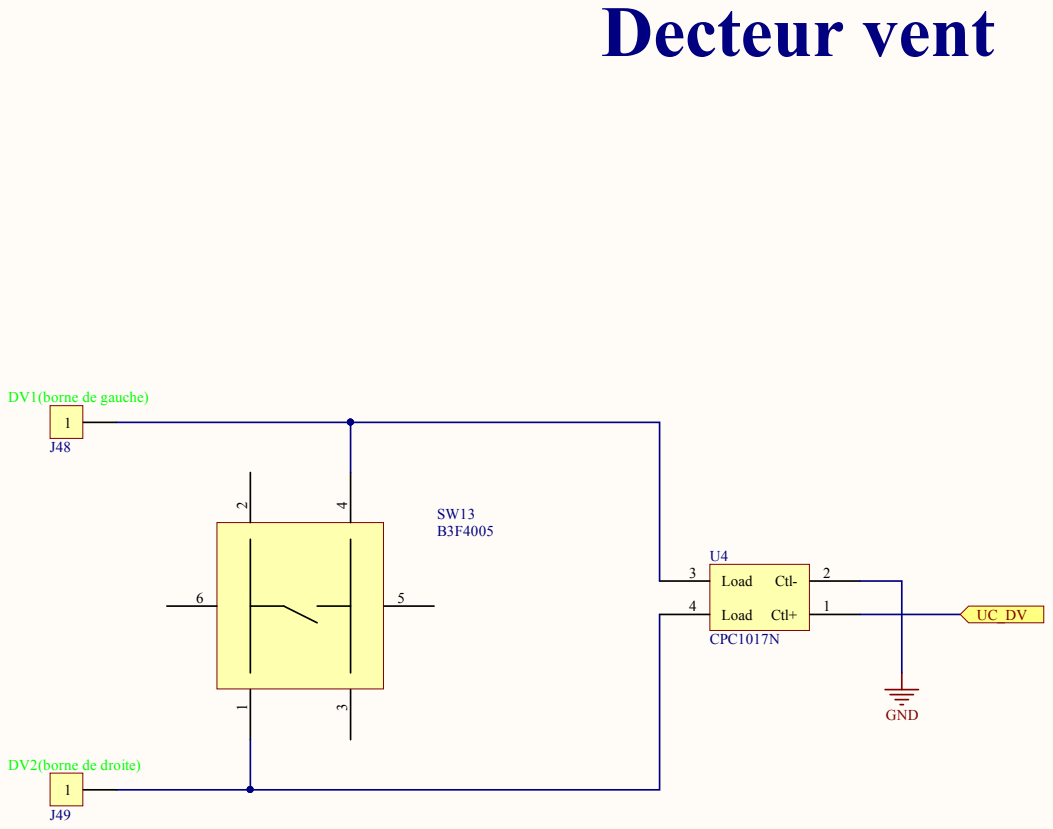
[picture p91: page 11]

C:\Users\think\Stage_Lyon\Carte test BP\CI\DV.SchDoc

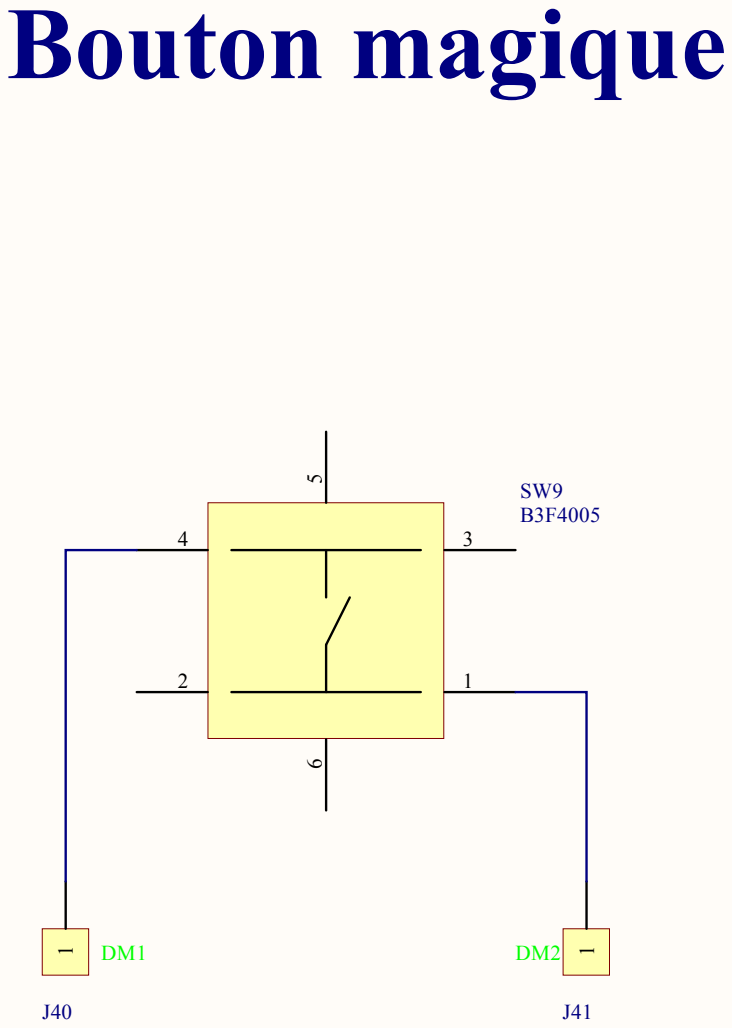
[picture p92: page 12]

C:\Users\think\Stage_Lyon\Carte test BP\CI\BM.SchDoc

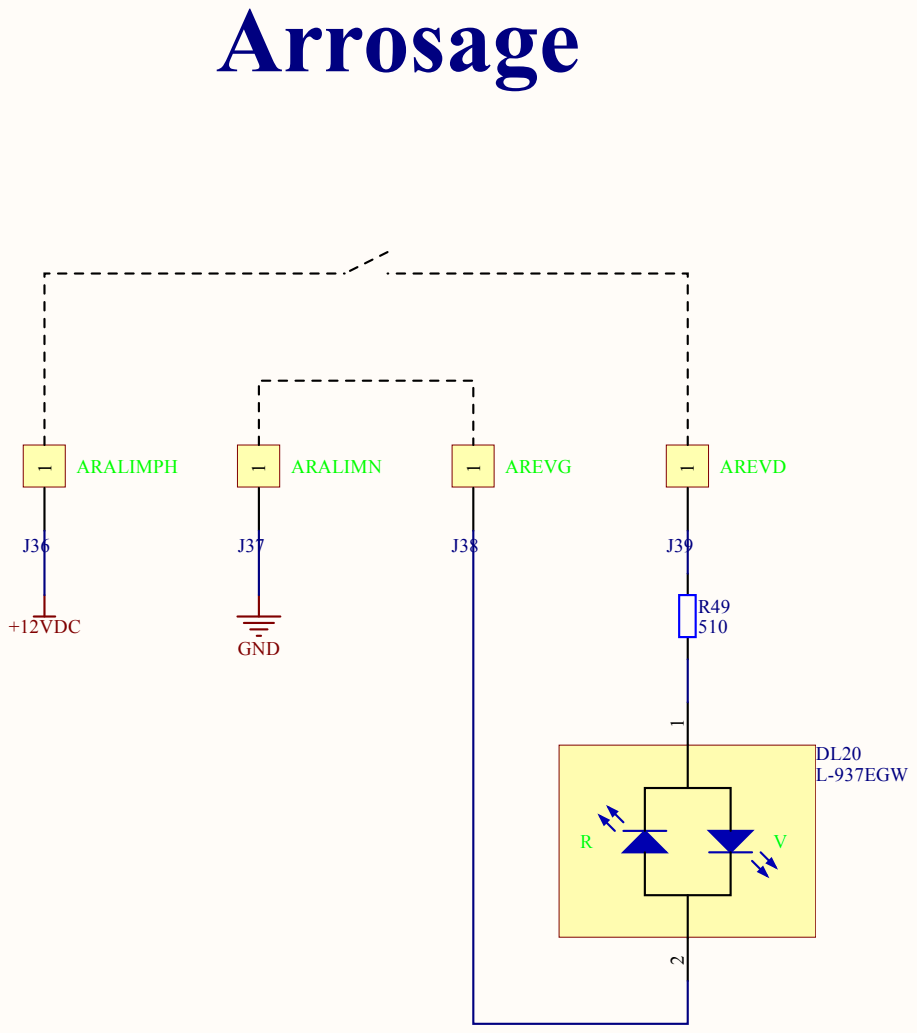
[picture p93: page 13]
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

Size: | V

/ / | | Sheet o f

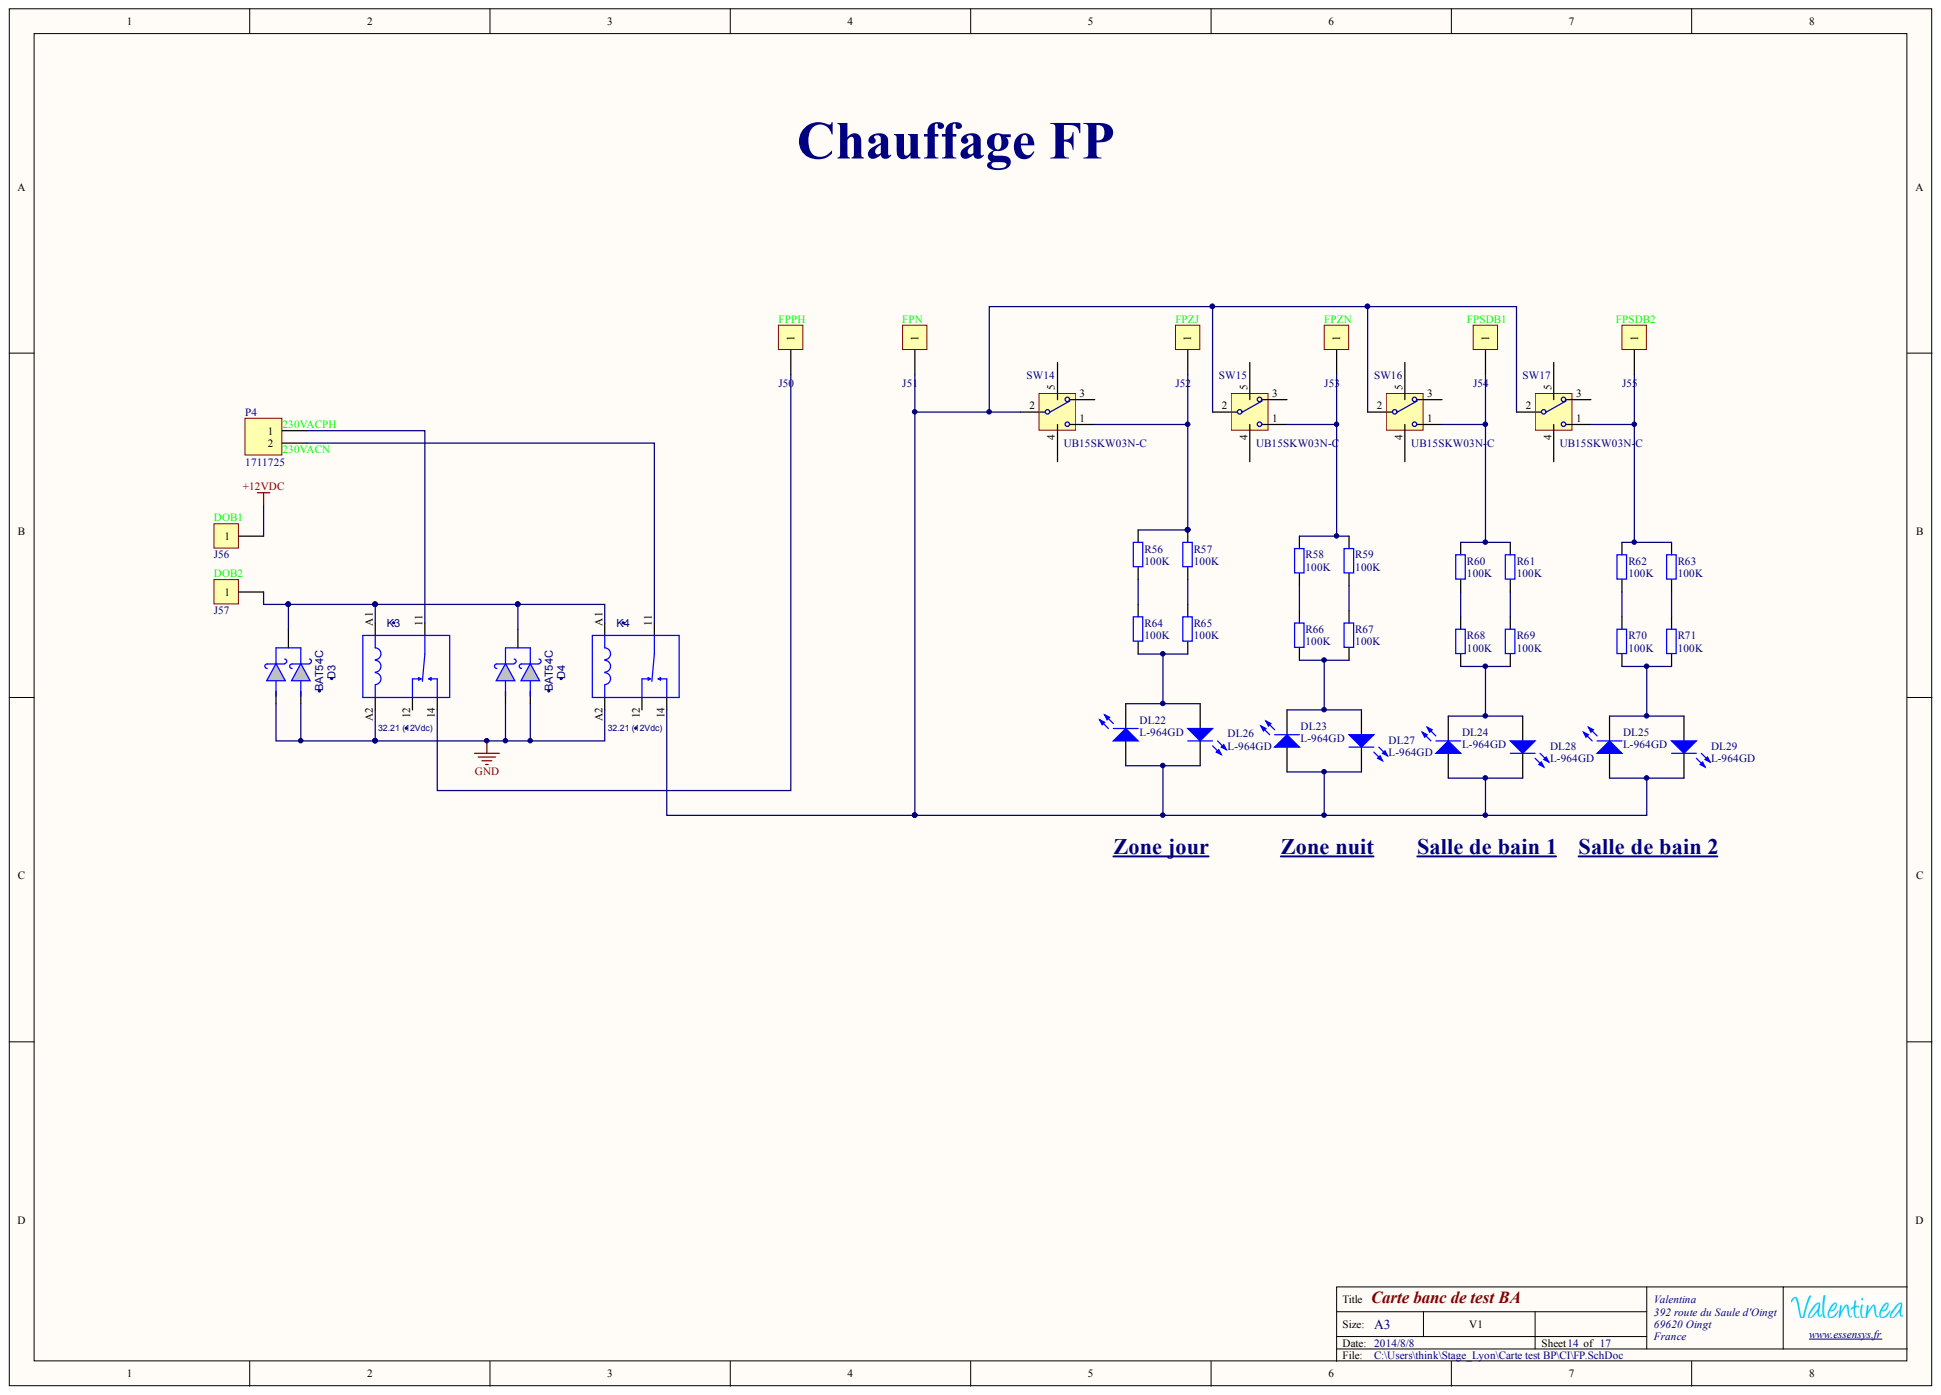
[picture p94: page 14]

C NBAT54C D3

32.21 (12Vdc)

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

Size: | V

/ / | | Sheet o f

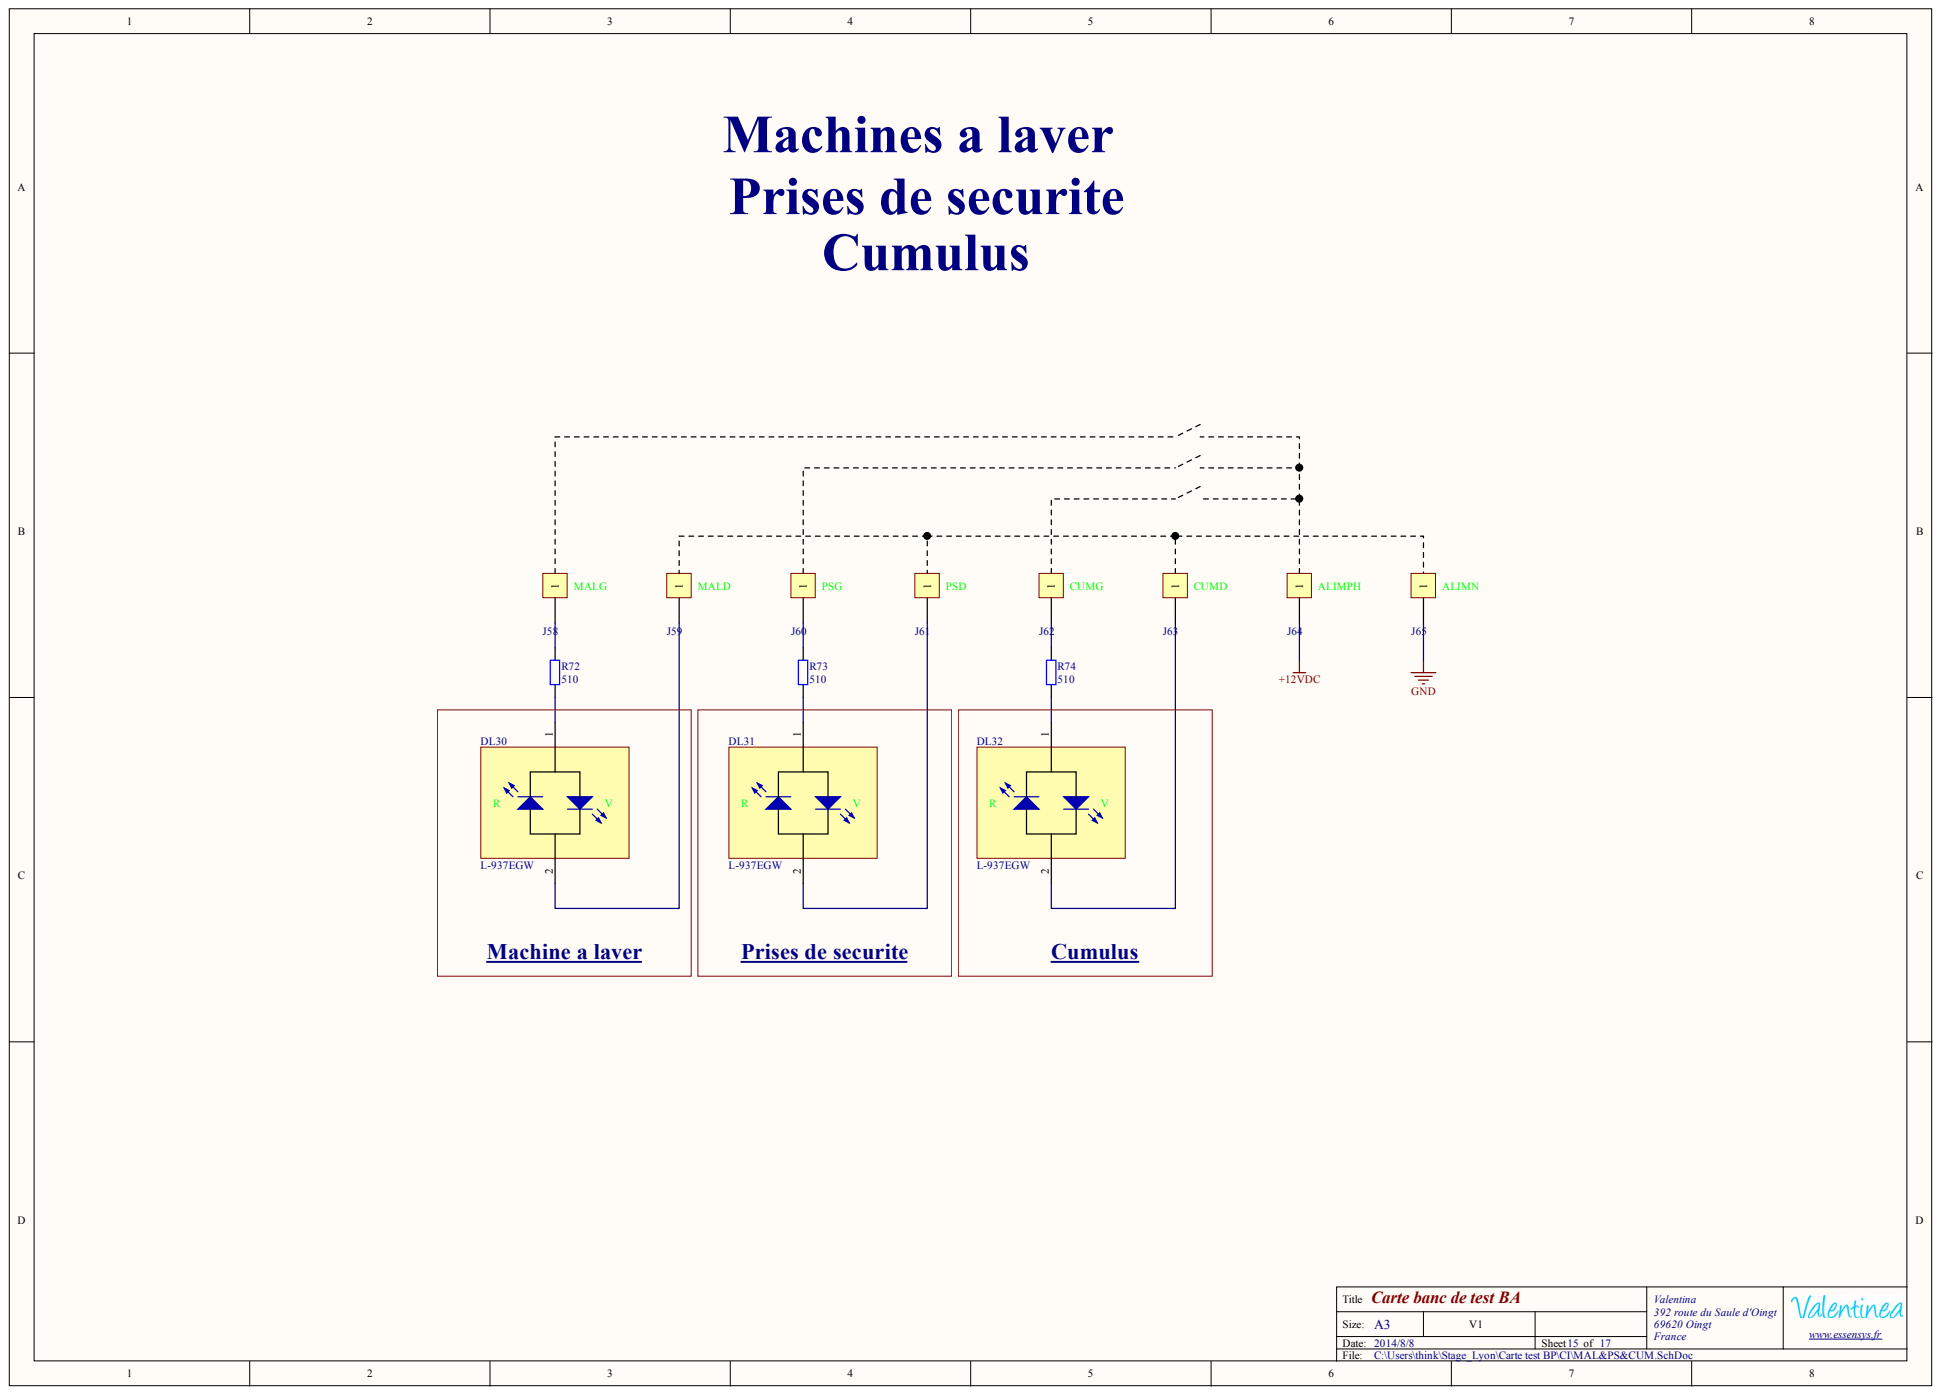
[picture p95: page 15]
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

Size: | V

/ / | | Sheet o f

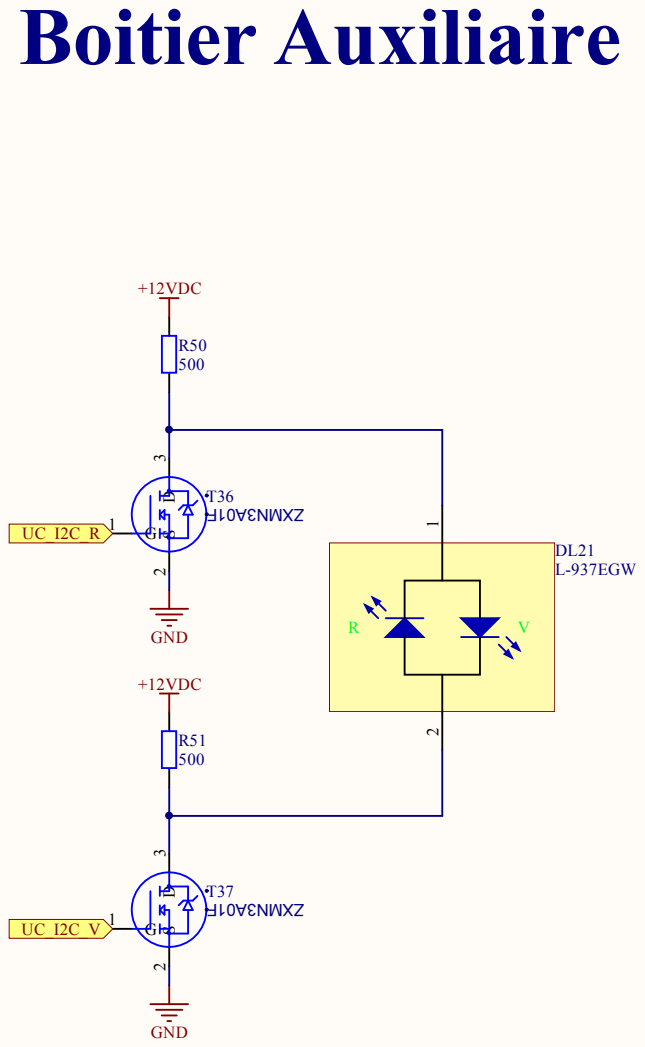
[picture p96: page 16]

C:\Users\think\Stage_Lyon\Carte test BP\CI\BA.SchDoc

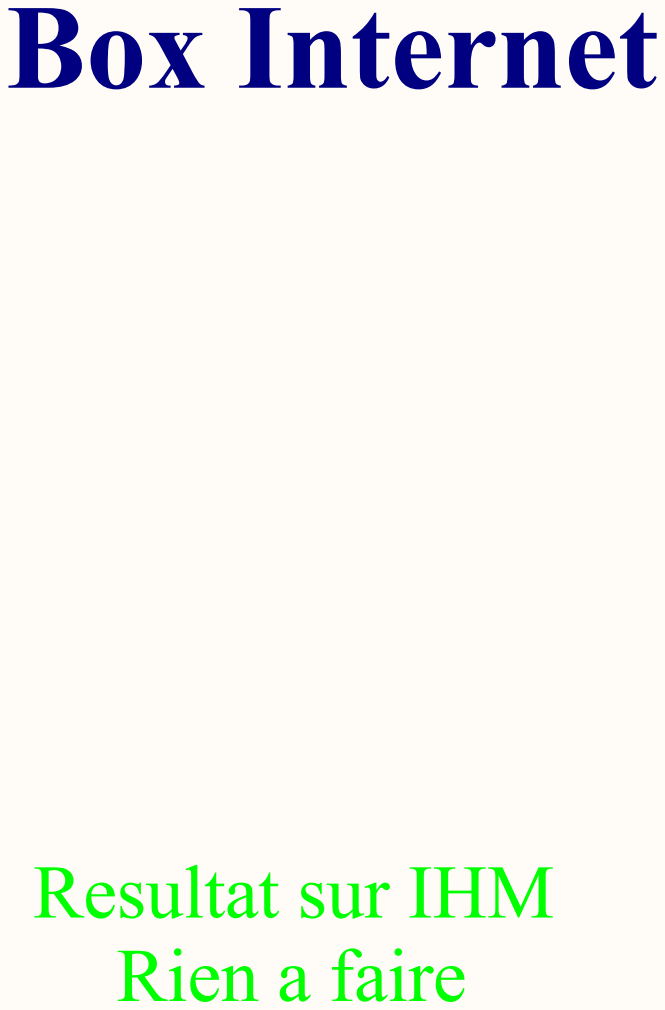
[picture p97: page 17]

C:\Users\think\Stage_Lyon\Carte test BP\CI\Eternet.SchDoc
