essensys-hub/essensys-test-banc-SC944D/points-de-test-SC944/archives/si944c-pt-emplacement-v1.pdf

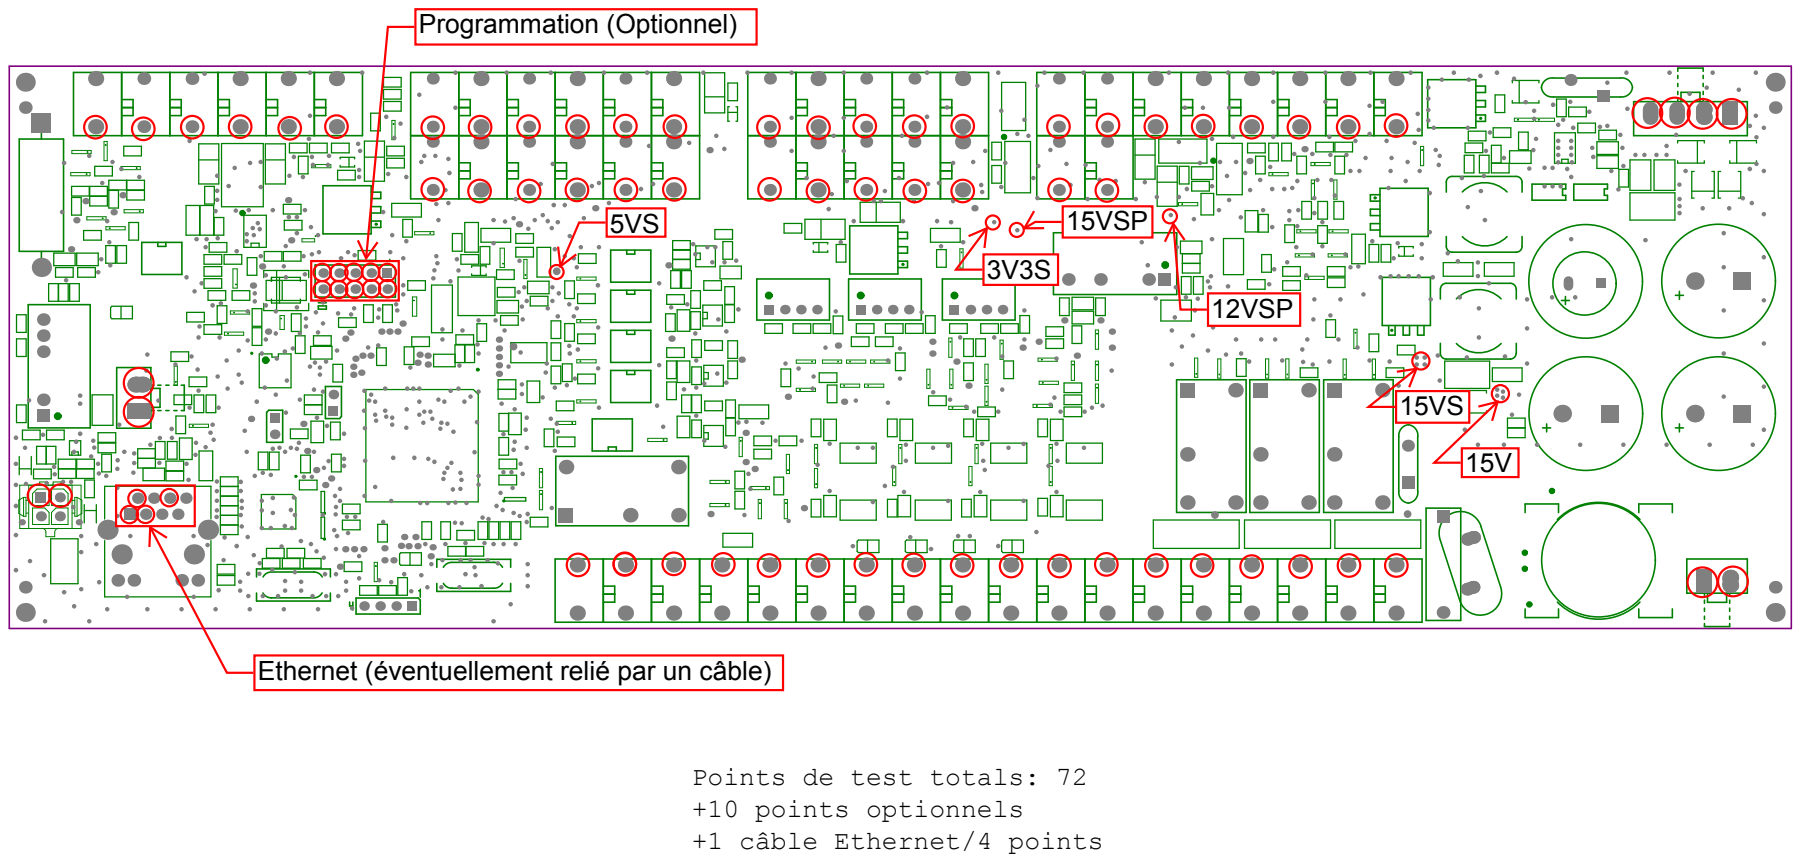
[picture p98: page 1]
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
