essensys-hub/essensys-test-banc-SC944D/(commit log)

2026-11-11 docs: archiver et documenter le banc de test du BP SC944 (essensys-hub/essensys-doc#36)
    Réorganisation des 103 fichiers d'archive (table docs/correspondance.csv),
    documentation complète dans docs/, transcription de la spec logicielle v4,
    retrait des coordonnées GPS des photos.
    Refs essensys-hub/essensys-doc#36
    [SI841A_BOTTOM.gbr, SI841A_Board.gbr, SI841A_Control_drill_file.gbr, SI841A_Excellon2_drill_file_RoundHoles.drl, SI841A_Excellon2_drill_file_SlotHoles.drl, SI841A_IN1.gbr, SI841A_IN2.gbr, SI841A_Mechanical.gbr]
2026-11-11 chore: conserver les fins de ligne d'origine des archives (essensys-hub/essensys-doc#36)
    [SI841A_BOTTOM.gbr, SI841A_Board.gbr, SI841A_Control_drill_file.gbr, SI841A_Excellon2_drill_file_RoundHoles.drl, SI841A_Excellon2_drill_file_SlotHoles.drl, SI841A_IN1.gbr, SI841A_IN2.gbr, SI841A_Mechanical.gbr]
2026-11-11 docs: corriger le lien avec essensys-board-SC841A, ajouter seuils et écarts spec/code (essensys-hub/essensys-doc#38)
    La SI841A est la carte du dépôt public essensys-board-SC841A : fichiers
    Altium, Gerber routés et code source du logiciel de test y sont publiés.
    La première version affirmait le contraire.
    Refs essensys-hub/essensys-doc#38
